goran-mahovlic/modular-psu/3D/BP3C/BP3C_r3B2_Front.png

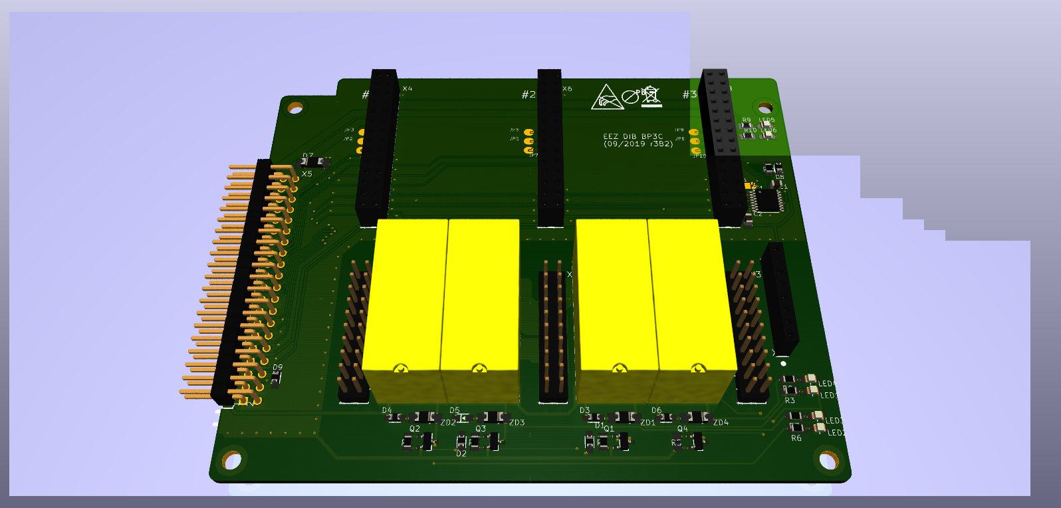
3D/BP3C/BP3C_r3B2_Front.png
