goran-mahovlic/modular-psu/3D/connected.FCStd

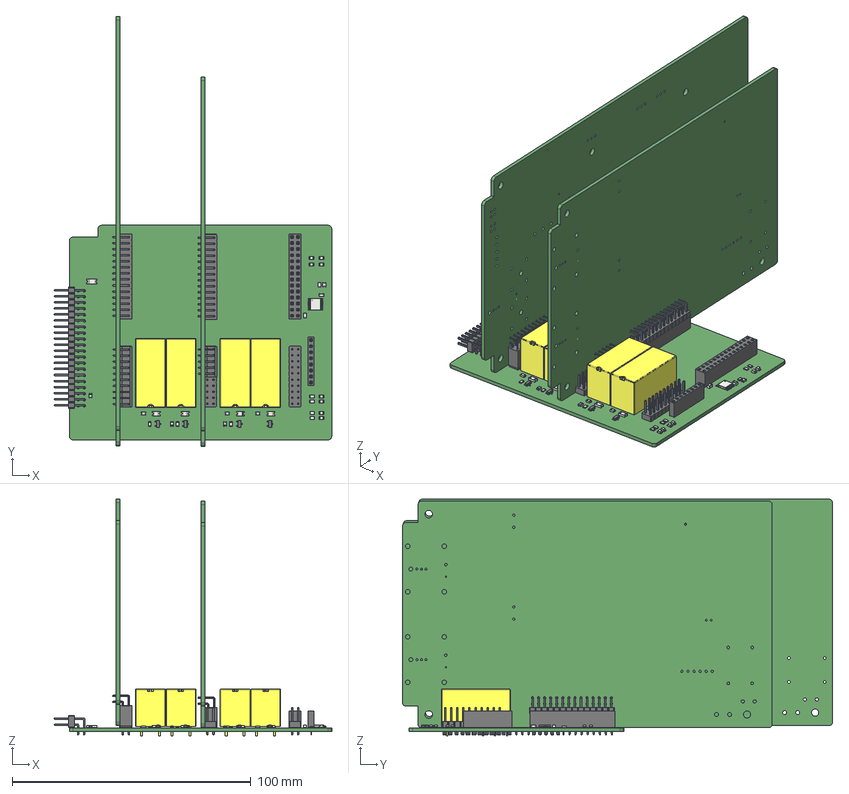
[picture p3: CAD file, 2020-01-07]
3D/connected.FCStd
116.4 x 180.3 x 99.2 mm
