goran-mahovlic/modular-psu/3D/parts/RM84-2P.STEP

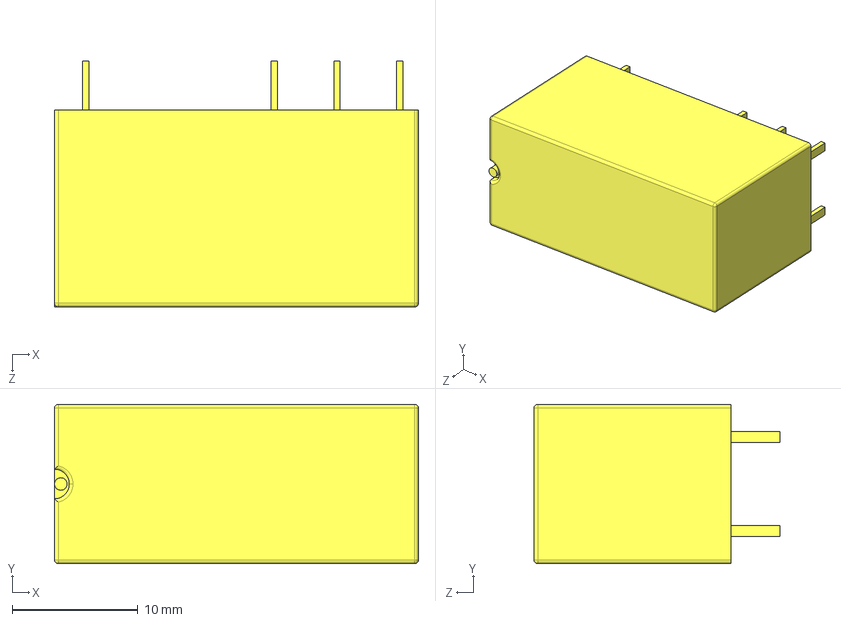
[picture p4: CAD file, 2020-01-07]
3D/parts/RM84-2P.STEP
29.0 x 12.7 x 19.6 mm
