goran-mahovlic/modular-psu/dcm220/Kicad/EEZ DIB DCM220 r2B7.step

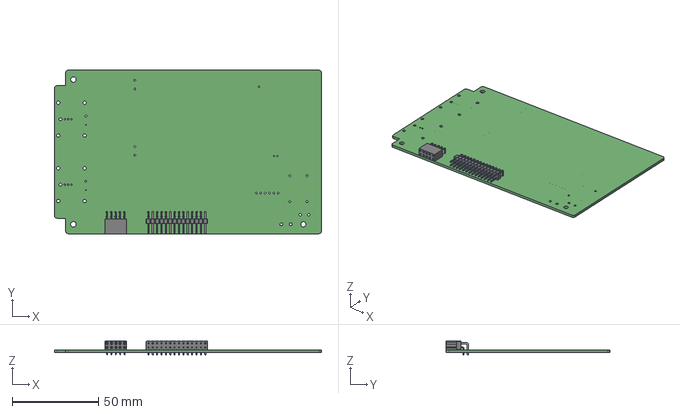
[picture p5: CAD file, 2020-01-07]
dcm220/Kicad/EEZ DIB DCM220 r2B7.step
155.0 x 95.1 x 8.08 mm
