goran-mahovlic/modular-psu/(list of files, cad)

Other CAD files:
3D/parts/RM84-2Z.STEP
