goran-mahovlic/modular-psu/dcp405/Kicad/EEZ DIB DCP405 r2B8.kicad_pcb

## KiCad design dcp405/Kicad/EEZ DIB DCP405 r2B8.kicad_pcb (2020-01-07)

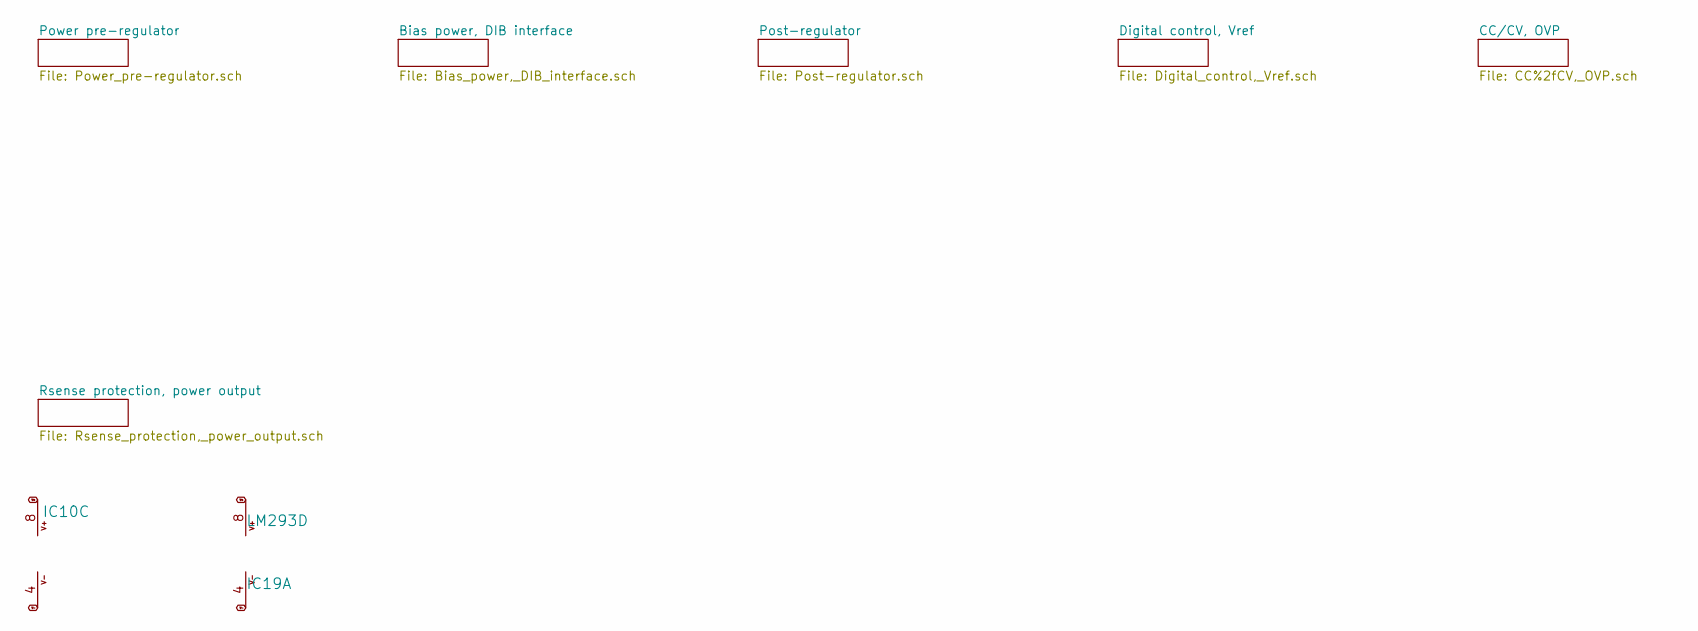
[picture p6: schematic EEZ DIB DCP405 r2B8.sch]

Parts:
IC10: MC33272ADR2G; SOIC127P600X173-8N
IC19: LM293D; SOIC127P600X173-8N

Connections:
V+: IC10.8 (V+), IC19.8 (V+); also elsewhere on the board
V-: IC10.4 (V-), IC19.4 (V-); also elsewhere on the board

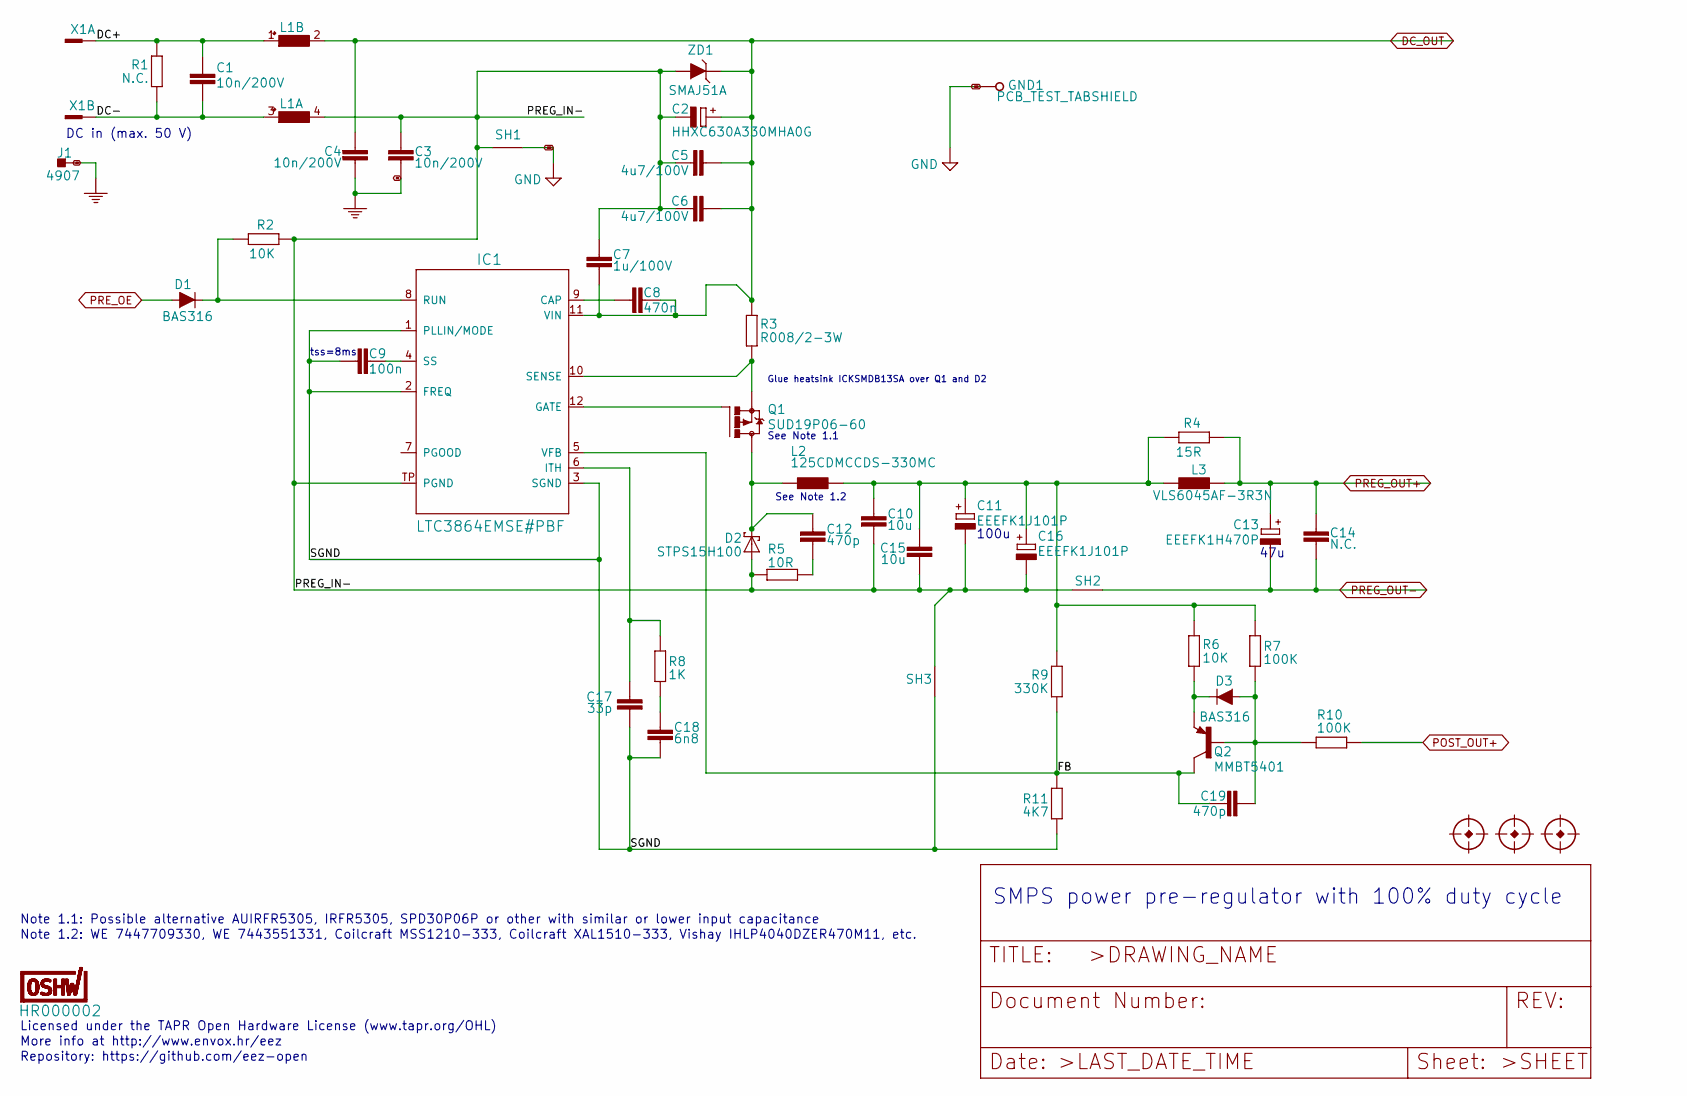
[picture p7: schematic Power_pre-regulator.sch]

Parts:
C1, C3, C4: 10n/200V; C1206
C2: HHXC630A330MHA0G; CAPAE830X1050N
C5, C6: 4u7/100V; C1210
C7: 1u/100V; C1206
C8: 470n; C0805
C9: 100n; C0603
C10, C15: 10u; C1210
C11, C16: EEEFK1J101P; CAPAE1030X1050N
C12, C19: 470p; C0805
C13: EEEFK1H470P; CAPAE830X1050N
C14: N.C.; C0805
C17: 33p; C0805
C18: 6n8; C0805
D1, D3: BAS316; SOD323-R
D2: STPS15H100; TO252-L
FM1, FM2, FM3: FIDUCIAL_2; FIDUCIAL_DUAL
GND: PCB_TEST_TABSHIELD; PCB_SHIELD_TAB
IC1: LTC3864EMSE#PBF; LTC_05-08-1666
J1: 4907; PCB_TAB-4907
L1: RN112-4-02-0M7; RN112
L2: 125CDMCCDS-330MC; 125CDMCC_DS
L3: VLS6045AF-3R3N; COILCRAFT_HPI0630
OSHWA: HR000002; CERT-SMALL-SILK
Q1: SUD19P06-60; TO229P990X239-3N
Q2: MMBT5401; SOT23-BEC
R1: N.C.; R2512
R2, R6: 10K; R0805
R3: R008/2-3W; R2512
R4: 15R; R2010
R5: 10R; R1206
R7, R10: 100K; R0805
R8: 1K; R0805
R9: 330K; R0805
R11: 4K7; R0805
SH1: SHORTNOHOLE; SHORT_NOHOLE
SH2: Pgnd to Pout- short; SHORT_NOHOLE
SH3: Sgnd to Pgnd short; SHORT_NOHOLE
X1: 39-30-1020; MINIFIT_39301020
ZD1: SMAJ51A; DO214AA

Connections:
/Power pre-regulator/DC+: C1.2, L1.1, R1.2, X1.1
/Power pre-regulator/DC-: C1.1, L1.3 (1), R1.1, X1.2
/Power pre-regulator/FB: C19.1, IC1.5 (VFB), Q2.C, R9.2, R11.1
/Power pre-regulator/PREG_IN-: C2.-, C3.1, C5.2, C6.2, C7.2, C10.2, C11.-, C15.2, C16.-, D2.1 (A), D2.2 (A), IC1.TP (PGND), L1.4 (2), R2.1, R5.1, SH1.1 (GND_A), SH2.2 (GND_B), SH3.2 (GND_B), ZD1.A
/Power pre-regulator/SGND: C9.1, C17.2, C18.2, IC1.1 (PLLIN/MODE), IC1.2 (FREQ), IC1.3 (SGND), R11.2, SH3.1 (GND_A)
DC_OUT: C2.+, C4.2, C5.1, C6.1, C7.1, C8.2, IC1.11 (VIN), L1.2, R3.1, ZD1.C; also elsewhere on the board
GND: GND.1, SH1.2 (GND_B); also elsewhere on the board
unnamed: C8.1, IC1.9 (CAP)
unnamed: C9.2, IC1.4 (SS)
unnamed: C10.1, C11.+, C15.1, C16.+, L2.2, L3.1, R4.1, R6.1, R7.1, R9.1
unnamed: C12.1, D2.3 (C), L2.1, Q1.2 (D)
unnamed: C12.2, R5.2
unnamed: C17.1, IC1.6 (ITH), R8.2
unnamed: C18.1, R8.1
unnamed: C19.2, D3.A, Q2.B, R7.2, R10.1
unnamed: D1.C, IC1.8 (RUN), R2.2
unnamed: D3.C, Q2.E, R6.2
unnamed: IC1.10 (SENSE), Q1.3 (S), R3.2
unnamed: IC1.12 (GATE), Q1.1 (G)
PE: C3.2, C4.1, J1.1, J1.2; also elsewhere on the board
POST_OUT+: R10.2; also elsewhere on the board
PREG_OUT+: C13.+, C14.1, L3.2, R4.2; also elsewhere on the board
PREG_OUT-: C13.-, C14.2, SH2.1 (GND_A); also elsewhere on the board
PRE_OE: D1.A; also elsewhere on the board

Notes on the sheet:
47u
tss=8ms
Licensed under the TAPR Open Hardware License (www.tapr.org/OHL)
Repository: https://github.com/eez-open
More info at http://www.envox.hr/eez
SMPS power pre-regulator with 100% duty cycle
100u
See Note 1.1
Note 1.1: Possible alternative AUIRFR5305, IRFR5305, SPD30P06P or other with similar or lower input capacitance
Note 1.2: WE 7447709330, WE 7443551331, Coilcraft MSS1210-333, Coilcraft XAL1510-333, Vishay IHLP4040DZER470M11, etc.
DC in (max. 50 V)
See Note 1.2
Glue heatsink ICKSMDB13SA over Q1 and D2

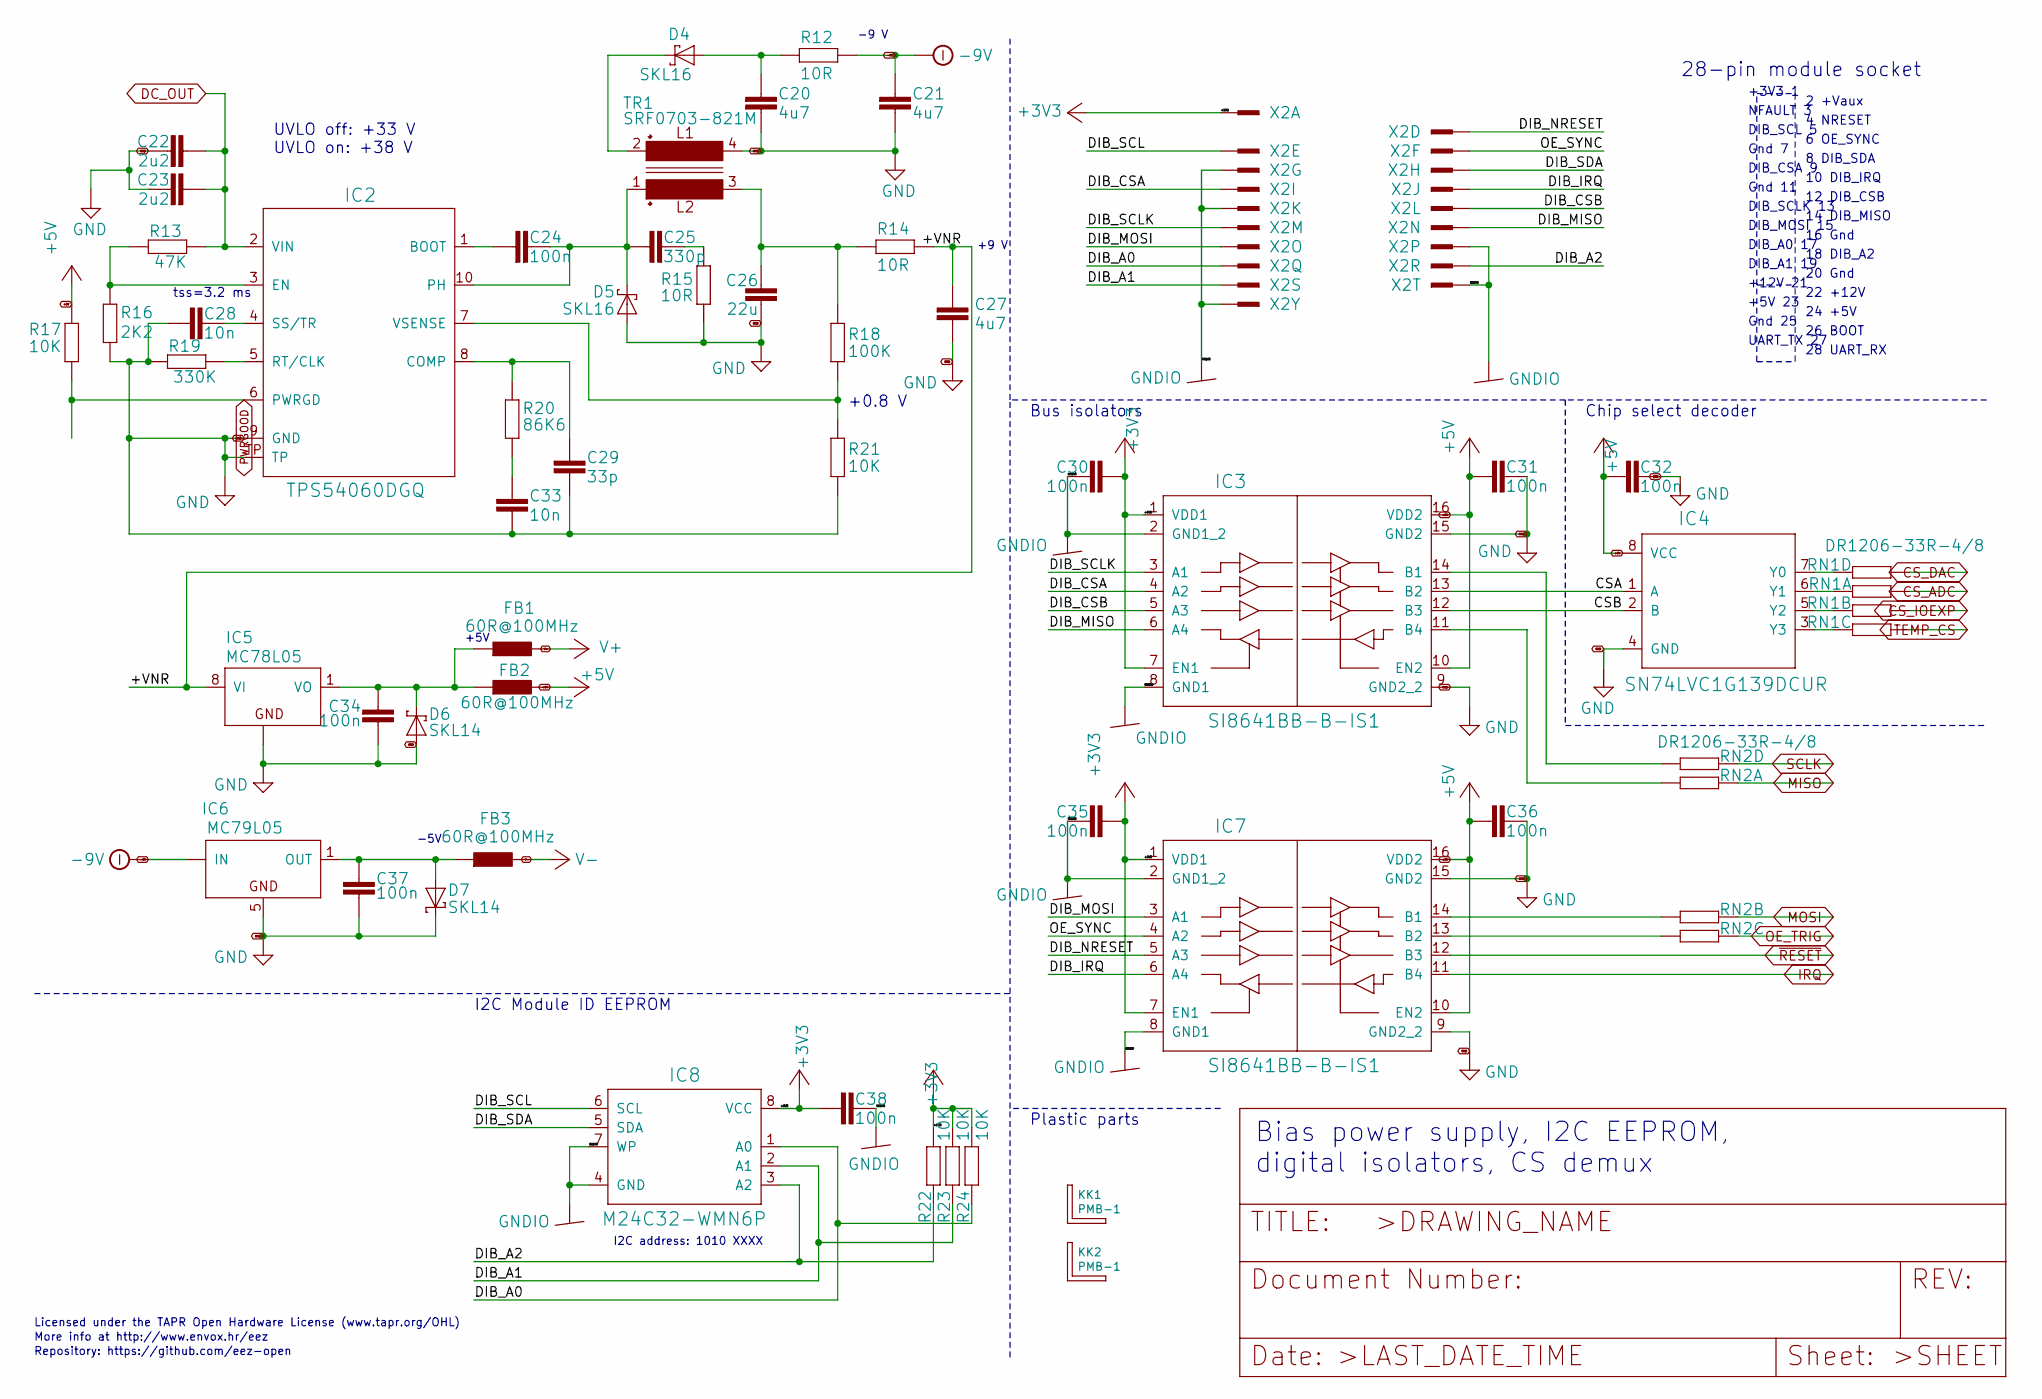
[picture p8: schematic Bias_power,_DIB_interface.sch]

Parts:
C20, C21, C27: 4u7; C1206
C22, C23: 2u2; C1206
C24, C30, C31, C32, C34, C35, C36, C37, C38: 100n; C0603
C25: 330p; C0805
C26: 22u; C1210
C28, C33: 10n; C0805
C29: 33p; C0805
D4, D5: SKL16; SOD123
D6, D7: SKL14; SOD123
FB1, FB2, FB3: 60R@100MHz; BEAD0603
IC2: TPS54060DGQ; SOP50P490X110-11N
IC3, IC7: SI8641BB-B-IS1; SOIC-16
IC4: SN74LVC1G139DCUR; DCU8
IC5: MC78L05; SOIC127P600X173-8N
IC6: MC79L05; SOIC127P600X173-8N
IC8: M24C32-WMN6P; SOIC127P600X173-8N
KK1, KK2: PMB-1; PCB-MB
R12, R14, R15: 10R; R1206
R13: 47K; R0805
R16: 2K2; R0805
R17, R21, R22, R23, R24: 10K; R0805
R18: 100K; R0805
R19: 330K; R0805
R20: 86K6; R0805
RN1, RN2: DR1206-33R-4/8; CAY16
TR1: SRF0703-821M; SRF0703
X2: 77317-104-20LF; 77317-104-28LF

Connections:
+3V3: C30.1, C35.1, C38.2, IC3.1 (VDD1), IC3.7 (EN1), IC7.1 (VDD1), IC7.7 (EN1), IC8.8 (VCC), R22.1, R23.1, R24.1, X2.1
+5V: C31.2, C32.1, C36.2, FB2.P$2 (2), IC3.10 (EN2), IC3.16 (VDD2), IC4.8 (VCC), IC7.10 (EN2), IC7.16 (VDD2), R17.1; also elsewhere on the board
-9V: C21.1, IC6.2 (IN), IC6.3 (IN), IC6.6 (IN), IC6.7 (IN), R12.1; also elsewhere on the board
/Bias power, DIB interface/+VNR: C27.1, IC5.8 (VI), R14.1
/Bias power, DIB interface/CSA: IC3.13 (B2), IC4.1 (A)
/Bias power, DIB interface/CSB: IC3.12 (B3), IC4.2 (B)
/Bias power, DIB interface/DIB_A0: IC8.1 (A0), R24.2, X2.17
/Bias power, DIB interface/DIB_A1: IC8.2 (A1), R23.2, X2.19
/Bias power, DIB interface/DIB_A2: IC8.3 (A2), R22.2, X2.18
/Bias power, DIB interface/DIB_CSA: IC3.4 (A2), X2.9
/Bias power, DIB interface/DIB_CSB: IC3.5 (A3), X2.12
/Bias power, DIB interface/DIB_IRQ: IC7.6 (A4), X2.10
/Bias power, DIB interface/DIB_MISO: IC3.6 (A4), X2.14
/Bias power, DIB interface/DIB_MOSI: IC7.3 (A1), X2.15
/Bias power, DIB interface/DIB_NRESET: IC7.5 (A3), X2.4
/Bias power, DIB interface/DIB_SCL: IC8.6 (SCL), X2.5
/Bias power, DIB interface/DIB_SCLK: IC3.3 (A1), X2.13
/Bias power, DIB interface/DIB_SDA: IC8.5 (SDA), X2.8
/Bias power, DIB interface/OE_SYNC: IC7.4 (A2), X2.6
CS_ADC: RN1.7 (2); also elsewhere on the board
CS_DAC: RN1.8 (2); also elsewhere on the board
CS_IOEXP: RN1.6 (2); also elsewhere on the board
DC_OUT: C22.1, C23.1, IC2.2 (VIN), R13.2; also elsewhere on the board
GND: C20.2, C21.2, C22.2, C23.2, C26.2, C27.2, C28.2, C29.1, C31.1, C32.2, C33.1, C34.2, C36.1, C37.1, D5.A, D6.A, D7.C, IC2.9 (GND), IC2.TP, IC3.9 (GND2_2), IC3.15 (GND2), IC4.4 (GND), IC5.2 (GND), IC5.3 (GND), IC5.6 (GND), IC5.7 (GND), IC6.5 (GND), IC7.9 (GND2_2), IC7.15 (GND2), R15.1, R16.1, R19.1, R21.1, TR1.4; also elsewhere on the board
GNDIO: C30.2, C35.2, C38.1, IC3.2 (GND1_2), IC3.8 (GND1), IC7.2 (GND1_2), IC7.8 (GND1), IC8.4 (GND), IC8.7 (WP), X2.7, X2.11, X2.16, X2.20, X2.25
IRQ: IC7.11 (B4); also elsewhere on the board
MISO: RN2.7 (2); also elsewhere on the board
MOSI: RN2.6 (2); also elsewhere on the board
unnamed: C20.1, D4.A, R12.2
unnamed: C24.1, C25.1, D5.C, IC2.10 (PH), TR1.1
unnamed: C24.2, IC2.1 (BOOT)
unnamed: C25.2, R15.2
unnamed: C26.1, R14.2, R18.2, TR1.3
unnamed: C28.1, IC2.4 (SS/TR)
unnamed: C29.2, IC2.8 (COMP), R20.2
unnamed: C33.2, R20.1
unnamed: C34.1, D6.C, FB1.P$1 (1), FB2.P$1 (1), IC5.1 (VO)
unnamed: C37.2, D7.A, FB3.P$1 (1), IC6.1 (OUT)
unnamed: D4.C, TR1.2
unnamed: IC2.3 (EN), R13.1, R16.2
unnamed: IC2.5 (RT/CLK), R19.2
unnamed: IC2.7 (VSENSE), R18.1, R21.2
unnamed: IC3.11 (B4), RN2.2 (1)
unnamed: IC3.14 (B1), RN2.1
unnamed: IC4.3 (Y3), RN1.4 (1)
unnamed: IC4.5 (Y2), RN1.3 (1)
unnamed: IC4.6 (Y1), RN1.2 (1)
unnamed: IC4.7 (Y0), RN1.1
unnamed: IC7.13 (B2), RN2.4 (1)
unnamed: IC7.14 (B1), RN2.3 (1)
OE_TRIG: RN2.5 (2); also elsewhere on the board
PWRGOOD: IC2.6 (PWRGD), R17.2; also elsewhere on the board
SCLK: RN2.8 (2); also elsewhere on the board
TEMP_CS: RN1.5 (2); also elsewhere on the board
V+: FB1.P$2 (2); also elsewhere on the board
V-: FB3.P$2 (2); also elsewhere on the board
~RESET: IC7.12 (B3); also elsewhere on the board

Notes on the sheet:
Licensed under the TAPR Open Hardware License (www.tapr.org/OHL)
Repository: https://github.com/eez-open
More info at http://www.envox.hr/eez
I2C Module ID EEPROM
Bus isolators
Bias power supply, I2C EEPROM, digital isolators, CS demux
Plastic parts
Chip select decoder
Gnd 7
22 +12V
16 Gnd
6 OE_SYNC
24 +5V
+5V 23
Gnd 25
28-pin module socket
+12V 21
10 DIB_IRQ
DIB_CSA 9
2 +Vaux
12 DIB_CSB
+3V3 1
Gnd 11
8 DIB_SDA
DIB_SCL 5
DIB_A1 19
4 NRESET
DIB_A0 17
20 Gnd
NFAULT 3
14 DIB_MISO
DIB_MOSI 15
DIB_SCLK 13
18 DIB_A2
-5V
+5V
I2C address: 1010 XXXX
+9 V
UVLO off: +33 V UVLO on: +38 V
+0.8 V
-9 V
26 BOOT
UART_TX 27
28 UART_RX
tss=3.2 ms

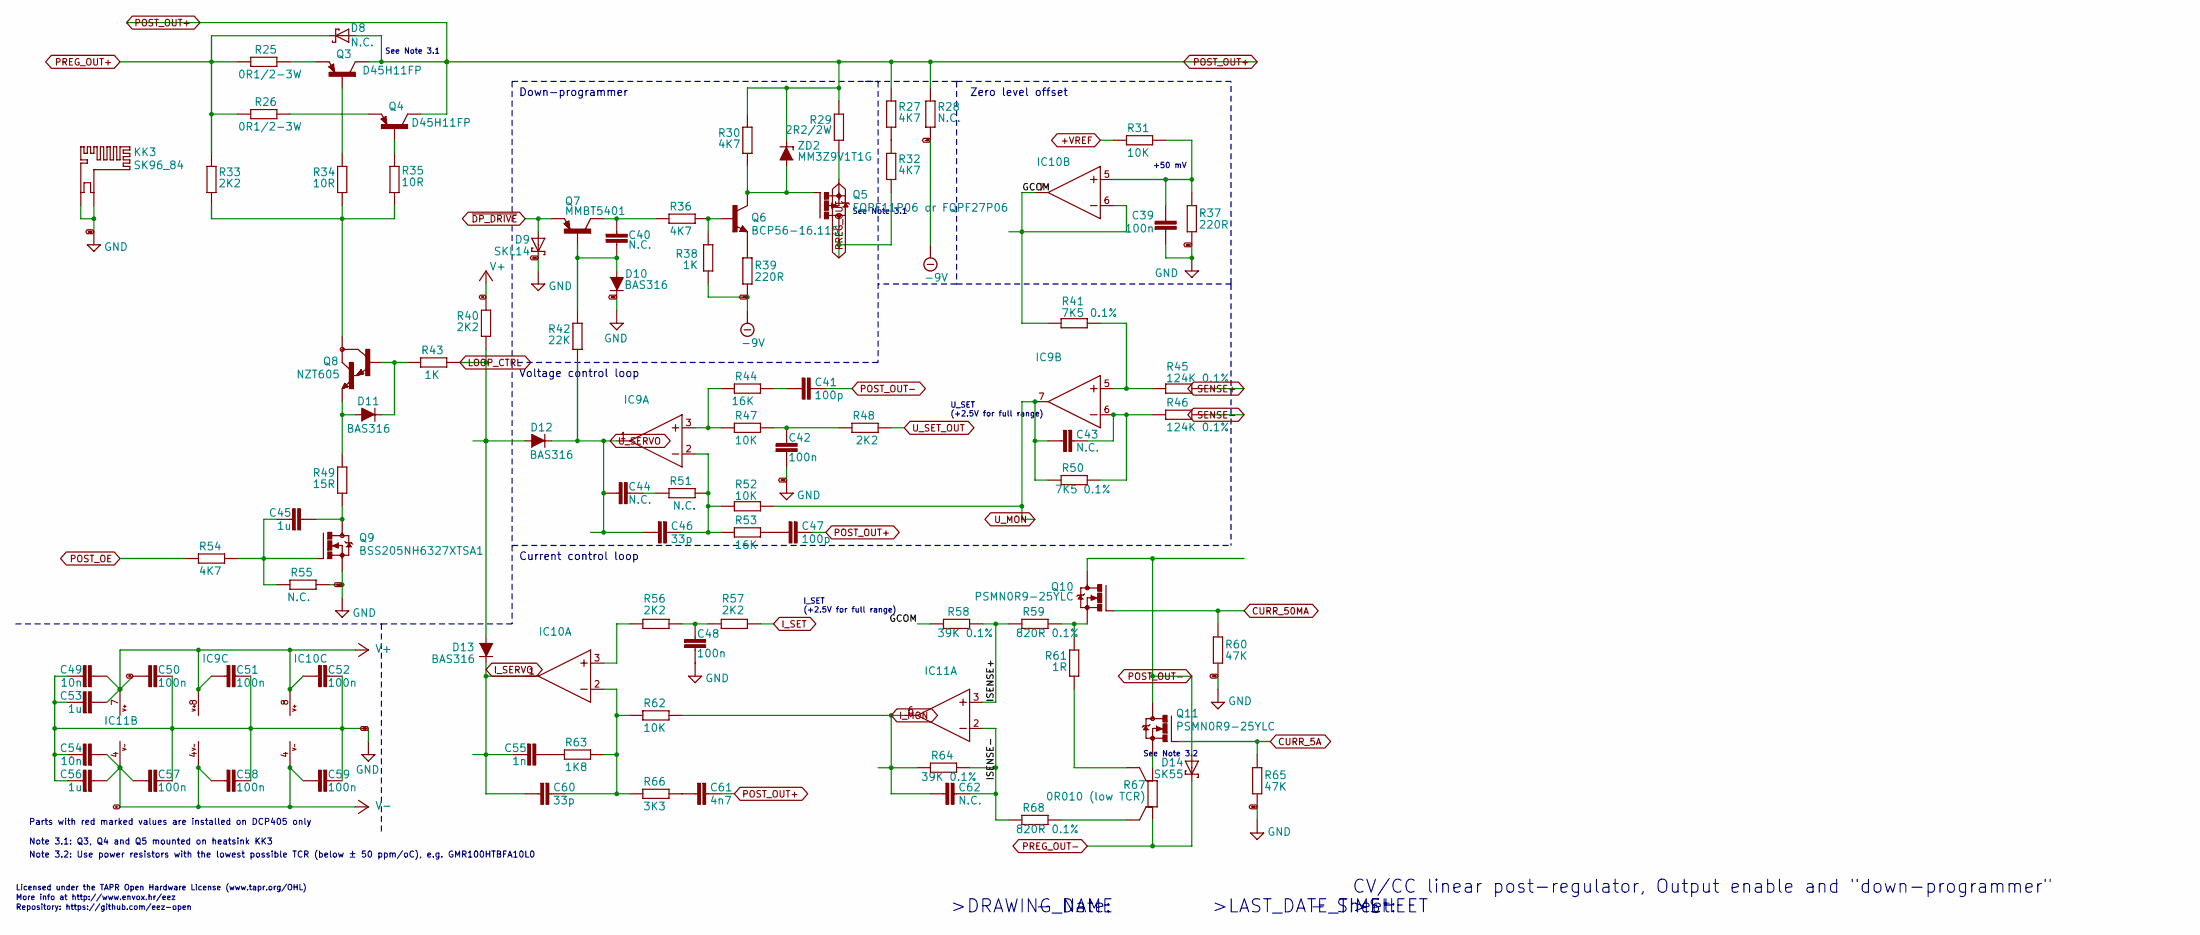
[picture p9: schematic Post-regulator.sch]

Parts:
C39, C42, C48, C50, C51, C52, C57, C58, C59: 100n; C0603
C40, C43, C44, C62: N.C.; C0805
C41, C47: 100p; C0805
C45, C53, C56: 1u; C0805
C46, C60: 33p; C0805
C49, C54: 10n; C0805
C55: 1n; C0805
C61: 4n7; C0805
D8: N.C.; SOD123
D9: SKL14; SOD123
D10, D11, D12, D13: BAS316; SOD323-R
D14: SK55; SMB
IC9: TL072D; SOIC127P600X173-8N
IC10: MC33272ADR2G; SOIC127P600X173-8N
IC11: LTC2050HVCS8#PBF; SOIC127P600X173-8N
KK3: SK96_84
Q3, Q4: D45H11FP; TO220FP-V
Q5: FQPF11P06 or FQPF27P06; TO220FP-V
Q6: BCP56-16.115; SOT230P700X180-4N
Q7: MMBT5401; SOT23-BEC
Q8: NZT605; SOT230P700X180-4N
Q9: BSS205NH6327XTSA1; SOT103P240X110-3N
Q10, Q11: PSMN0R9-25YLC; SOT669
R25, R26: 0R1/2-3W; R2512
R27, R30, R32, R36, R54: 4K7; R0805
R28, R51, R55: N.C.; R0805
R29: 2R2/2W; R2512
R31, R47, R52, R62: 10K; R0805
R33, R40, R48, R56, R57: 2K2; R0805
R34, R35: 10R; R1206
R37, R39: 220R; R0805
R38, R43: 1K; R0805
R41, R50: 7K5 0.1%; R0805
R42: 22K; R0805
R44, R53: 16K; R0805
R45, R46: 124K 0.1%; R0805
R49: 15R; R2010
R58, R64: 39K 0.1%; R0805
R59, R68: 820R 0.1%; R0805
R60, R65: 47K; R0805
R61: 1R; R1206
R63: 1K8; R0805
R66: 3K3; R0805
R67: 0R010 (low TCR); R_2512-4WIRE
ZD2: MM3Z9V1T1G; SOD323-R

Connections:
+VREF: R31.1; also elsewhere on the board
-9V: R28.1, R38.2, R39.2; also elsewhere on the board
/Post-regulator/GCOM: IC10.6 (-IN), IC10.7 (OUT), R41.1, R58.1
/Post-regulator/ISENSE+: IC11.3 (+IN), R58.2, R59.2
/Post-regulator/ISENSE-: C62.1, IC11.2 (-IN), R64.1, R68.2
CURR_5A: Q11.4 (G), R65.2; also elsewhere on the board
CURR_50MA: Q10.4 (G), R60.2; also elsewhere on the board
GND: C39.2, C42.2, C48.2, C49.1, C50.2, C51.1, C52.1, C53.1, C54.1, C56.1, C57.2, C58.1, C59.1, D9.C, D10.C, KK3.1, KK3.2, Q9.2 (S), R37.2, R55.1, R60.1, R65.1; also elsewhere on the board
I_MON: C62.2, IC11.6 (OUT), R62.1, R64.2; also elsewhere on the board
I_SERVO: C55.2, C60.2, D13.C, IC10.1 (OUT); also elsewhere on the board
I_SET: R57.1; also elsewhere on the board
LOOP_CTRL: D12.A, D13.A, R40.1, R43.1; also elsewhere on the board
unnamed: C39.1, IC10.5 (+IN), R31.2, R37.1
unnamed: C40.1, D10.A, Q7.B, R42.2
unnamed: C40.2, Q7.C, R36.2
unnamed: C41.2, R44.1
unnamed: C42.1, R47.1, R48.2
unnamed: C43.1, IC9.6 (-IN), R46.1, R50.2
unnamed: C44.1, R51.2
unnamed: C45.1, Q9.1 (G), R54.1, R55.2
unnamed: C45.2, Q9.3 (D), R49.1
unnamed: C46.1, IC9.2 (-IN), R51.1, R52.2, R53.2
unnamed: C47.2, R53.1
unnamed: C48.1, R56.1, R57.2
unnamed: C55.1, R63.1
unnamed: C60.1, IC10.2 (-IN), R62.2, R63.2, R66.2
unnamed: C61.2, R66.1
unnamed: D11.A, Q8.3 (E), R49.2
unnamed: D11.C, Q8.1 (B), R43.2
unnamed: IC9.3 (+IN), R44.2, R47.2
unnamed: IC9.5 (+IN), R41.2, R45.1
unnamed: IC10.3 (+IN), R56.2
unnamed: Q3.1 (B), R34.2
unnamed: Q3.3 (E), R25.2
unnamed: Q4.1 (B), R35.2
unnamed: Q4.3 (E), R26.2
unnamed: Q5.1 (G), Q6.2 (C), Q6.4 (C), R30.2, ZD2.A
unnamed: Q5.3 (S), R29.1
unnamed: Q6.1 (B), R36.1, R38.1
unnamed: Q6.3 (E), R39.1
unnamed: Q8.2 (C), Q8.4 (C), R33.1, R34.1, R35.1
unnamed: Q10.1 (S), Q10.2 (S), Q10.3 (S), R59.1, R61.1
unnamed: Q11.1 (S), Q11.2 (S), Q11.3 (S), R67.2
unnamed: R27.1, R32.2
unnamed: R61.2, R67.2S
unnamed: R67.1S, R68.1
POST_OE: R54.2; also elsewhere on the board
POST_OUT+: C47.1, C61.1, D8.A, Q3.2 (C), Q4.2 (C), R27.2, R28.2, R29.2, R30.1, ZD2.C; also elsewhere on the board
POST_OUT-: C41.1, D14.A, Q10.MB (D), Q11.MB (D); also elsewhere on the board
PREG_OUT+: D8.C, R25.1, R26.1, R33.2; also elsewhere on the board
PREG_OUT-: D14.C, Q5.2 (D), R32.1, R67.1; also elsewhere on the board
SENSE+: R45.2; also elsewhere on the board
SENSE-: R46.2; also elsewhere on the board
U_MON: C43.2, IC9.7 (OUT), R50.1, R52.1; also elsewhere on the board
U_SERVO: C44.2, C46.2, D12.C, IC9.1 (OUT), R42.1; also elsewhere on the board
U_SET_OUT: R48.1; also elsewhere on the board
V+: C49.2, C50.1, C51.2, C52.2, C53.2, IC9.8 (V+), IC10.8 (V+), IC11.7 (V+), R40.2; also elsewhere on the board
V-: C54.2, C56.2, C57.1, C58.2, C59.2, IC9.4 (V-), IC10.4 (V-), IC11.4 (V-); also elsewhere on the board
~DP_DRIVE: D9.A, Q7.E; also elsewhere on the board

Notes on the sheet:
Voltage control loop
U_SET (+2.5V for full range)
Note 3.1: Q3, Q4 and Q5 mounted on heatsink KK3
Down-programmer
Licensed under the TAPR Open Hardware License (www.tapr.org/OHL)
Repository: https://github.com/eez-open
More info at http://www.envox.hr/eez
+50 mV
See Note 3.1
I_SET (+2.5V for full range)
Zero level offset
Note 3.2: Use power resistors with the lowest possible TCR (below ± 50 ppm/oC), e.g. GMR100HTBFA10L0
CV/CC linear post-regulator, Output enable and "down-programmer"
See Note 3.2
>SHEET
- Sheet:
>DRAWING_NAME
>LAST_DATE_TIME
- Date:
Current control loop
Parts with red marked values are installed on DCP405 only

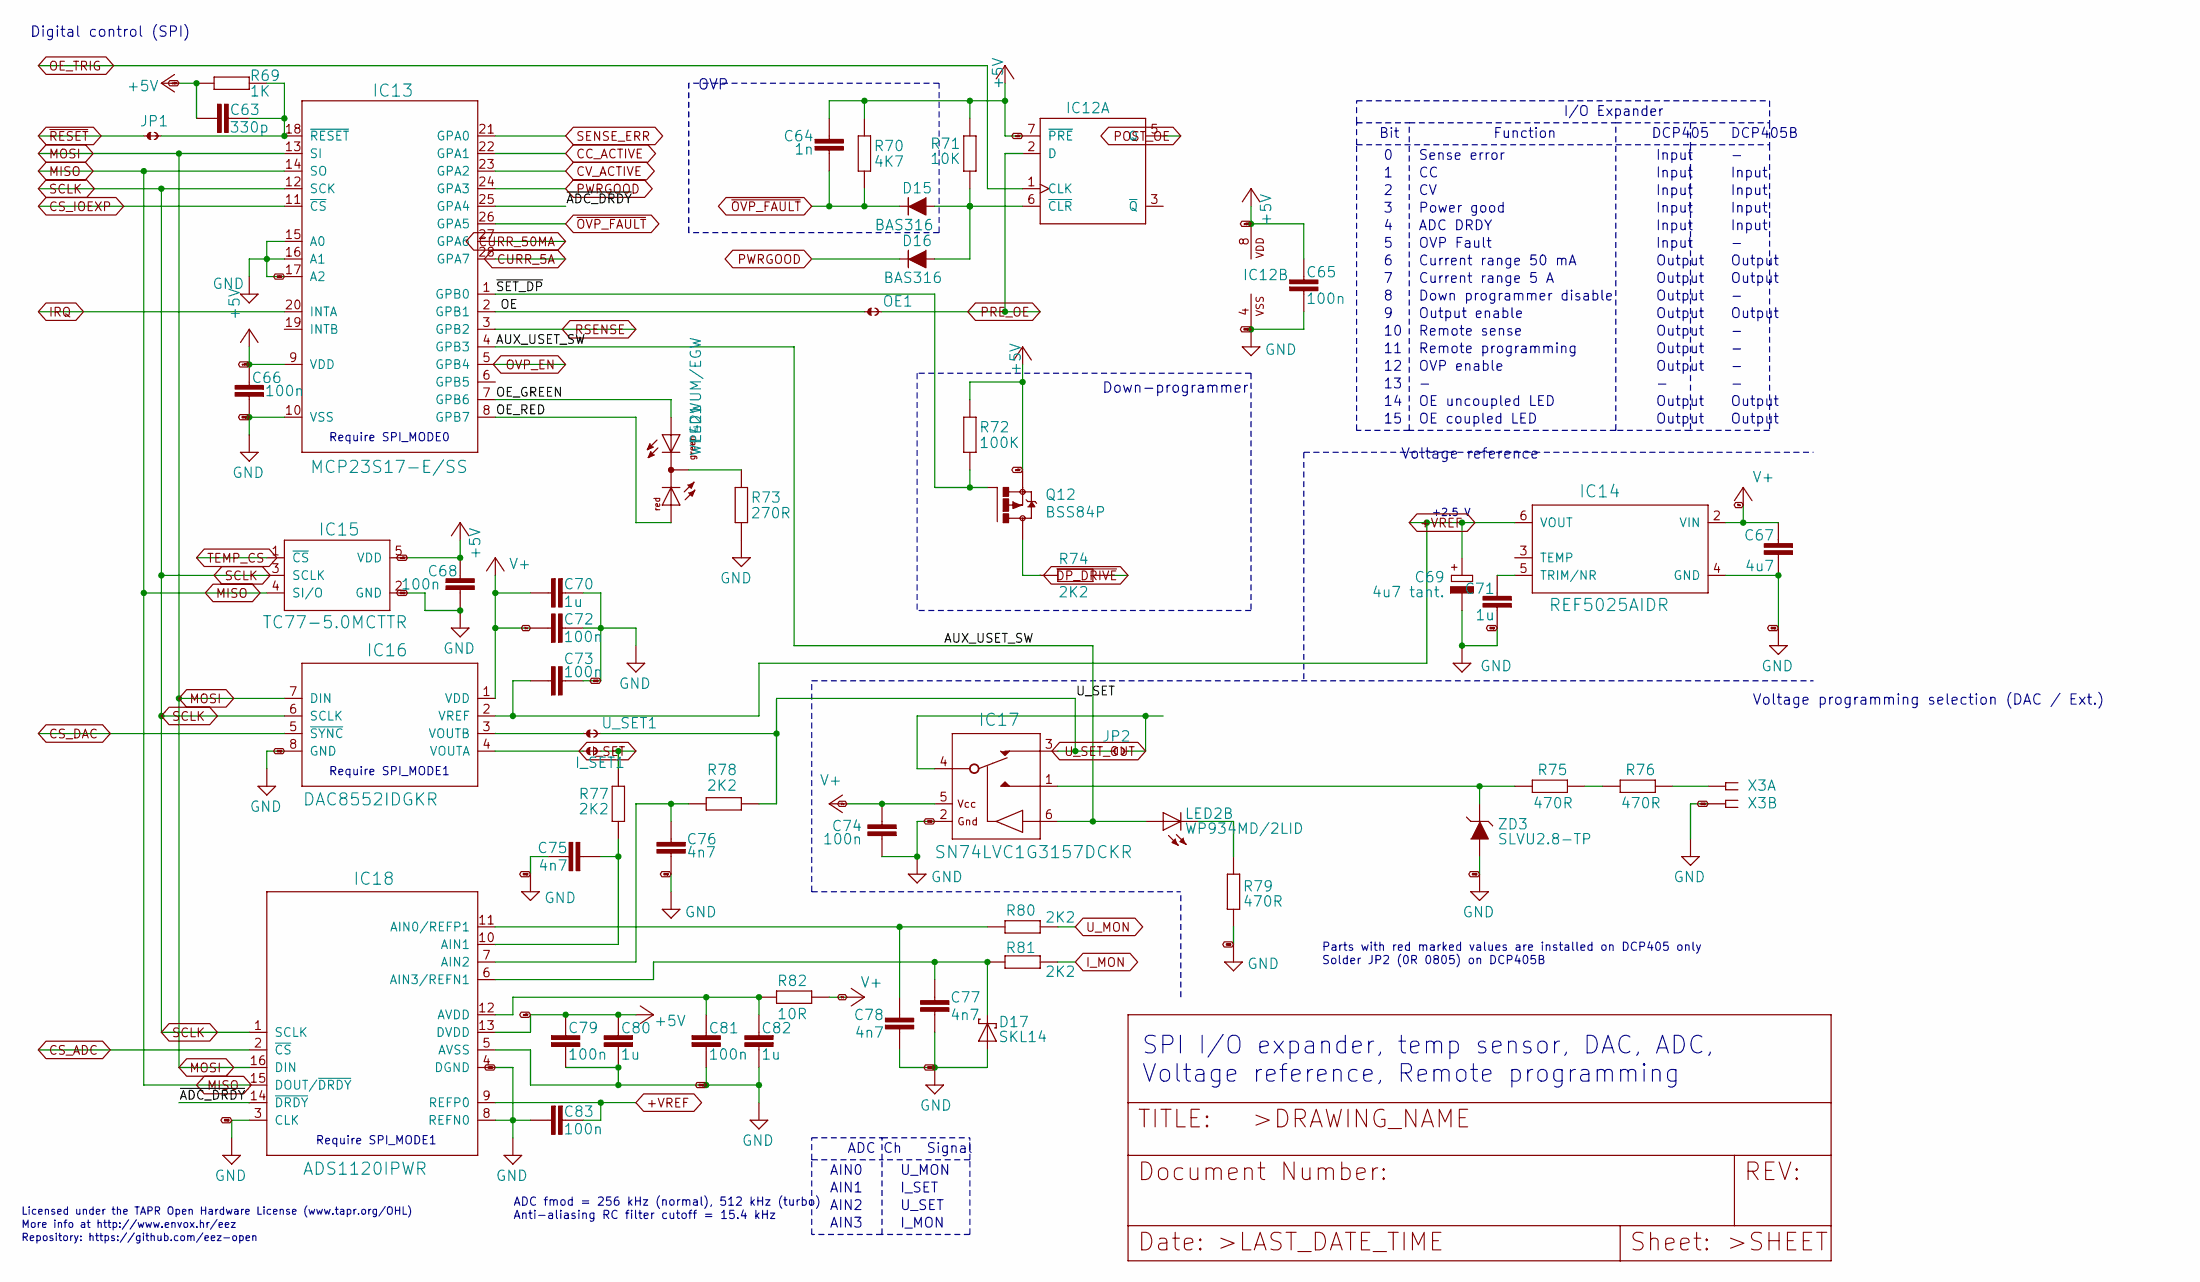
[picture p10: schematic Digital_control,_Vref.sch]

Parts:
C63: 330p; C0805
C64: 1n; C0805
C65, C66, C68, C72, C73, C74, C79, C81, C83: 100n; C0603
C67: 4u7; C1206
C69: 4u7 tant.; EC1206
C70, C71, C80, C82: 1u; C0805
C75, C76, C77, C78: 4n7; C0805
D15, D16: BAS316; SOD323-R
D17: SKL14; SOD123
IC12: 74AUP1G74DC.125; DCU8
IC13: MCP23S17-E/SS; SOP65P780X200-28N
IC14: REF5025AIDR; SOIC127P600X175-8N
IC15: TC77-5.0MCTTR; SOT23-5
IC16: DAC8552IDGKR; DGK8-M
IC17: SN74LVC1G3157DCKR; SOT65P210X110-6N
IC18: ADS1120IPWR; PW(R-PDSO-G16)
I_SET: JP2-NOCUT
JP1: JP2-NOCUT
JP2: JP2-CUT-0805; R_0805
LED1: WP42WUM/EGW; L-42WUM-1EGWT
LED2: WP934MD/2LID; WP934MD
OE: JP2-NOCUT
Q12: BSS84P; SOT95P237X112-3N
R69: 1K; R0805
R70: 4K7; R0805
R71: 10K; R0805
R72: 100K; R0805
R73: 270R; R0805
R74, R77, R78, R80, R81: 2K2; R0805
R75, R76, R79: 470R; R0805
R82: 10R; R1206
U_SET: JP2-NOCUT
X3: 691322110005; MC1,5_5-G-3,5
ZD3: SLVU2.8-TP; SOT23

Connections:
+5V: C63.2, C64.2, C65.2, C66.1, C68.1, C79.2, C80.2, IC12.7 (~PRE), IC12.8 (VDD), IC13.9 (VDD), IC15.5 (VDD), IC18.13 (DVDD), Q12.2 (S), R69.1, R70.1, R71.1, R72.1; also elsewhere on the board
+VREF: C69.+, C73.2, C83.2, IC14.6 (VOUT), IC16.2 (VREF), IC18.9 (REFP0); also elsewhere on the board
/Digital control, Vref/AUX_USET_SW: IC13.4 (GPB3), IC17.6 (CTRL), LED2.BA (A)
/Digital control, Vref/OE: IC13.2 (GPB1), OE.1
/Digital control, Vref/OE_GREEN: IC13.7 (GPB6), LED1.GREEN (AG)
/Digital control, Vref/OE_RED: IC13.8 (GPB7), LED1.RED (AR)
/Digital control, Vref/U_SET: IC17.3 (NC), JP2.1, R78.1, U_SET.2
/Digital control, Vref/~ADC_DRDY: IC13.25 (GPA4), IC18.14 (~DRDY)
/Digital control, Vref/~SET_DP: IC13.1 (GPB0), Q12.1 (G), R72.2
CC_ACTIVE: IC13.22 (GPA1); also elsewhere on the board
CS_ADC: IC18.2 (~CS); also elsewhere on the board
CS_DAC: IC16.5 (~SYNC); also elsewhere on the board
CS_IOEXP: IC13.11 (~CS); also elsewhere on the board
CURR_5A: IC13.28 (GPA7); also elsewhere on the board
CURR_50MA: IC13.27 (GPA6); also elsewhere on the board
CV_ACTIVE: IC13.23 (GPA2); also elsewhere on the board
GND: C65.1, C66.2, C67.2, C68.2, C69.-, C70.2, C71.2, C72.1, C73.1, C74.2, C75.1, C76.1, C77.2, C78.1, C79.1, C80.1, C81.1, C82.1, C83.1, D17.A, IC12.4 (VSS), IC13.10 (VSS), IC13.15 (A0), IC13.16 (A1), IC13.17 (A2), IC14.4 (GND), IC15.2 (GND), IC16.8 (GND), IC17.2 (GND), IC18.3 (CLK), IC18.4 (DGND), IC18.5 (AVSS), IC18.8 (REFN0), R73.2, R79.1, X3.2, ZD3.1 (A), ZD3.2 (A); also elsewhere on the board
IRQ: IC13.20 (INTA); also elsewhere on the board
I_MON: R81.1; also elsewhere on the board
I_SET: I_SET.2, R77.1; also elsewhere on the board
MISO: IC13.14 (SO), IC15.4 (SI/O), IC18.15 (DOUT/~DRDY); also elsewhere on the board
MOSI: IC13.13 (SI), IC16.7 (DIN), IC18.16 (DIN); also elsewhere on the board
unnamed: C63.1, IC13.18 (~RESET), JP1.2, R69.2
unnamed: C71.1, IC14.5 (TRIM/NR)
unnamed: C75.2, IC18.10 (AIN1), R77.2
unnamed: C76.2, IC18.7 (AIN2), R78.2
unnamed: C77.1, D17.C, IC18.6 (AIN3/REFN1), R81.2
unnamed: C78.2, IC18.11 (AIN0/REFP1), R80.2
unnamed: C81.2, C82.2, IC18.12 (AVDD), R82.2
unnamed: D15.A, D16.A, IC12.6 (~CLR), R71.2
unnamed: IC16.3 (VOUTB), U_SET.1
unnamed: IC16.4 (VOUTA), I_SET.1
unnamed: IC17.1 (NO), R75.1, ZD3.3 (C)
unnamed: LED1.CC (C), R73.1
unnamed: LED2.BC (C), R79.2
unnamed: Q12.3 (D), R74.2
unnamed: R75.2, R76.1
unnamed: R76.2, X3.1
OE_TRIG: IC12.1 (CLK); also elsewhere on the board
OVP_EN: IC13.5 (GPB4); also elsewhere on the board
POST_OE: IC12.5 (Q); also elsewhere on the board
PRE_OE: IC12.2 (D), OE.2; also elsewhere on the board
PWRGOOD: D16.C, IC13.24 (GPA3); also elsewhere on the board
RSENSE: IC13.3 (GPB2); also elsewhere on the board
SCLK: IC13.12 (SCK), IC15.3 (SCLK), IC16.6 (SCLK), IC18.1 (SCLK); also elsewhere on the board
SENSE_ERR: IC13.21 (GPA0); also elsewhere on the board
TEMP_CS: IC15.1 (~CS); also elsewhere on the board
U_MON: R80.1; also elsewhere on the board
U_SET_OUT: IC17.4 (COM), JP2.2; also elsewhere on the board
V+: C67.1, C70.1, C72.2, C74.1, IC14.2 (VIN), IC16.1 (VDD), IC17.5 (VDD), R82.1; also elsewhere on the board
~DP_DRIVE: R74.1; also elsewhere on the board
~OVP_FAULT: C64.1, D15.C, IC13.26 (GPA5), R70.2; also elsewhere on the board
~RESET: JP1.1; also elsewhere on the board

Notes on the sheet:
Require SPI_MODE1
Digital control (SPI)
Voltage reference
Licensed under the TAPR Open Hardware License (www.tapr.org/OHL)
Repository: https://github.com/eez-open
More info at http://www.envox.hr/eez
Function
DCP405
Sense error
Input
Bit
Down programmer disable
Remote sense
Remote programming
Power good
Output enable
Output
I/O Expander
SPI I/O expander, temp sensor, DAC, ADC, Voltage reference, Remote programming
Require SPI_MODE0
Current range 5 A
Current range 50 mA
+2.5 V
OE coupled LED
AIN0
AIN1
Signal
U_MON
I_SET
ADC Ch
U_SET
AIN2
AIN3
I_MON
Voltage programming selection (DAC / Ext.)
OE uncoupled LED
OVP enable
ADC DRDY
OVP Fault
ADC fmod = 256 kHz (normal), 512 kHz (turbo) Anti-aliasing RC filter cutoff = 15.4 kHz
DCP405B
Parts with red marked values are installed on DCP405 only Solder JP2 (0R 0805) on DCP405B
OVP
Down-programmer
