goran-mahovlic/modular-psu/dcp405/Kicad/EEZ DIB DCP405 r2B8.kicad_pcb

## KiCad design dcp405/Kicad/EEZ DIB DCP405 r2B8.kicad_pcb (continued)

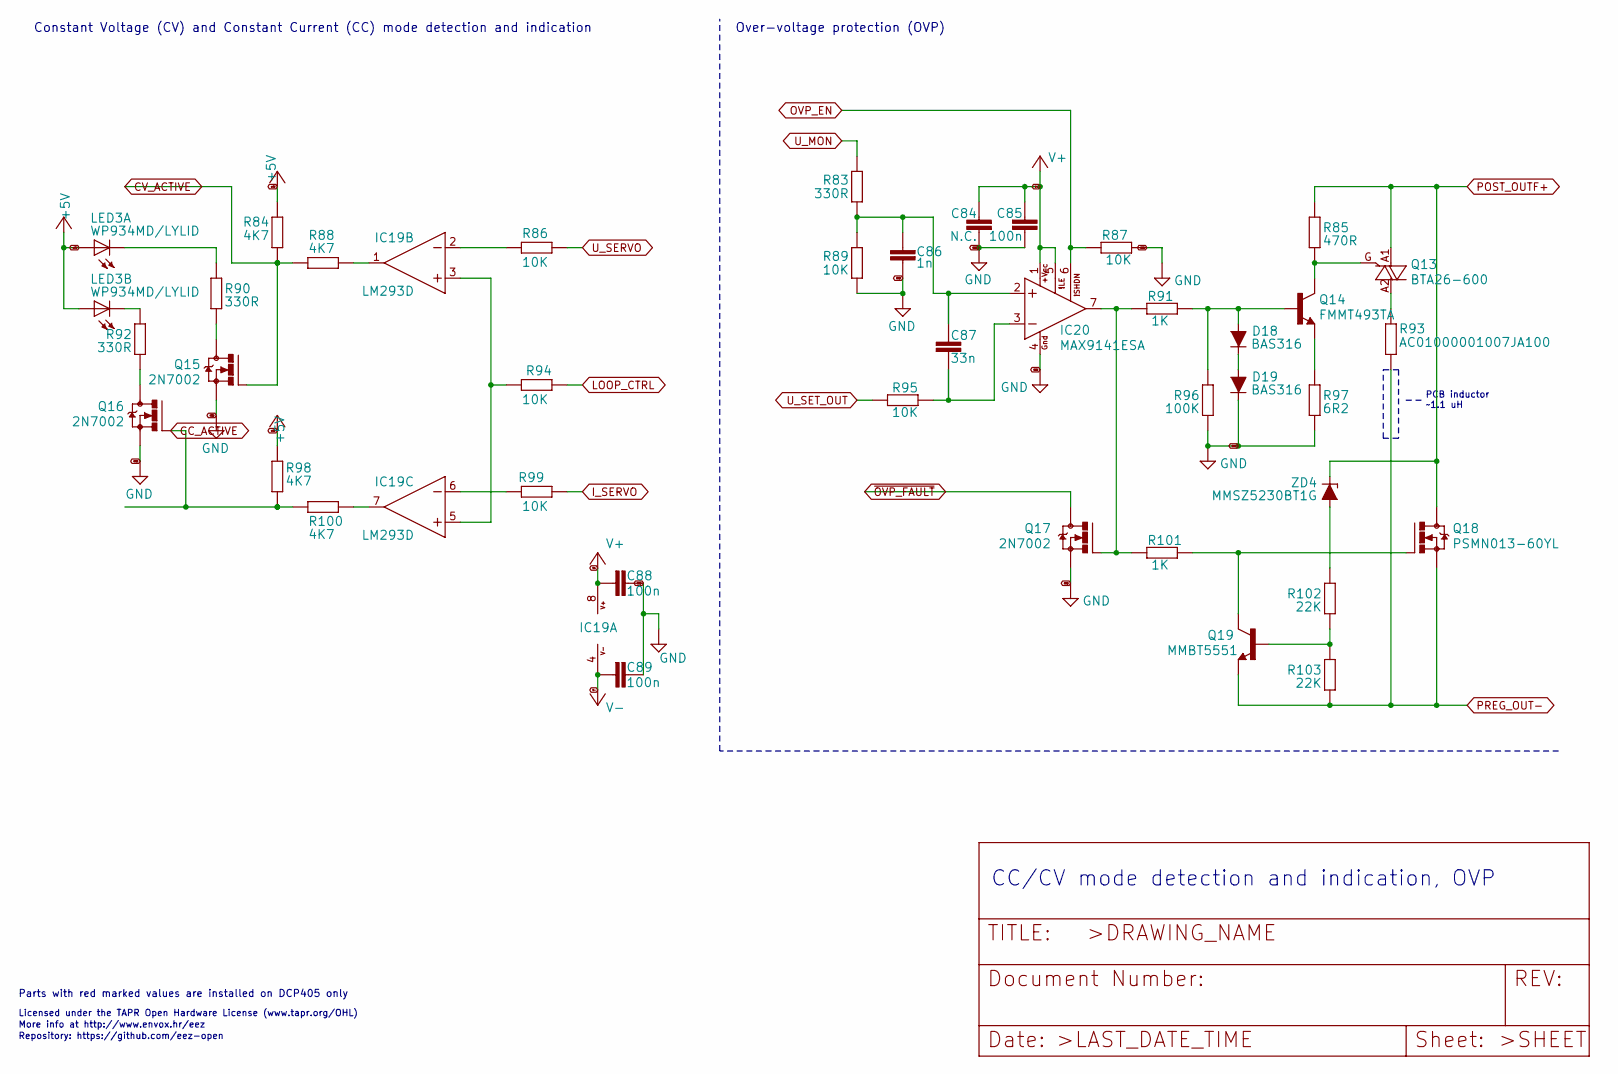
[picture p11: schematic CC%2fCV,_OVP.sch]

Parts:
C84: N.C.; C0805
C85, C88, C89: 100n; C0603
C86: 1n; C0805
C87: 33n; C0805
D18, D19: BAS316; SOD323-R
IC19: LM293D; SOIC127P600X173-8N
IC20: MAX9141ESA; SOIC127P600X173-8N
LED3: WP934MD/LYLID; WP934MD
Q13: BTA26-600; TOP3_TRIAC_NOHOLE
Q14: FMMT493TA; SOT23-BEC
Q15, Q16, Q17: 2N7002; SOT103P240X110-3N
Q18: PSMN013-60YL; SOT669
Q19: MMBT5551; SOT23-BEC
R83, R90, R92: 330R; R0805
R84, R88, R98, R100: 4K7; R0805
R85: 470R; R0805
R86, R87, R89, R94, R95, R99: 10K; R0805
R91, R101: 1K; R0805
R93: AC01000001007JA100; 0411_15
R96: 100K; R0805
R97: 6R2; R0805
R102, R103: 22K; R0805
ZD4: MMSZ5230BT1G; SOD123

Connections:
+5V: LED3.BA (A), LED3.TA (A), R84.2, R98.2; also elsewhere on the board
CC_ACTIVE: Q16.1 (G), R98.1, R100.2; also elsewhere on the board
CV_ACTIVE: Q15.1 (G), R84.1, R88.2; also elsewhere on the board
GND: C84.2, C85.1, C86.1, C88.1, C89.1, D19.C, IC20.4 (GND), Q15.2 (S), Q16.2 (S), Q17.2 (S), R87.1, R89.2, R96.1, R97.1; also elsewhere on the board
I_SERVO: R99.1; also elsewhere on the board
LOOP_CTRL: R94.2; also elsewhere on the board
unnamed: C86.2, C87.1, IC20.2 (+IN), R83.2, R89.1
unnamed: C87.2, IC20.3 (-IN), R95.2
unnamed: D18.A, Q14.B, R91.1, R96.2
unnamed: D18.C, D19.A
unnamed: IC19.1 (OUT), R88.1
unnamed: IC19.2 (-IN), R86.2
unnamed: IC19.3 (+IN), IC19.5 (+IN), R94.1
unnamed: IC19.6 (-IN), R99.2
unnamed: IC19.7 (OUT), R100.1
unnamed: IC20.7 (OUT), Q17.1 (G), R91.2, R101.2
unnamed: LED3.BC (C), R92.2
unnamed: LED3.TC (C), R90.1
unnamed: Q13.A2, R93.2
unnamed: Q13.G, Q14.C, R85.1
unnamed: Q14.E, R97.2
unnamed: Q15.3 (D), R90.2
unnamed: Q16.3 (D), R92.1
unnamed: Q18.4 (G), Q19.C, R101.1
unnamed: Q19.B, R102.1, R103.2
unnamed: R102.2, ZD4.A
OVP_EN: IC20.6 (~SHDN), R87.2; also elsewhere on the board
POST_OUTF+: Q13.A1, Q18.MB (D), R85.2, ZD4.C; also elsewhere on the board
PREG_OUT-: Q18.1 (S), Q18.2 (S), Q18.3 (S), Q19.E, R93.1, R103.1; also elsewhere on the board
U_MON: R83.1; also elsewhere on the board
U_SERVO: R86.1; also elsewhere on the board
U_SET_OUT: R95.1; also elsewhere on the board
V+: C84.1, C85.2, C88.2, IC19.8 (V+), IC20.1 (+VCC), IC20.5 (~LE); also elsewhere on the board
V-: C89.2, IC19.4 (V-); also elsewhere on the board
~OVP_FAULT: Q17.3 (D); also elsewhere on the board

Notes on the sheet:
Licensed under the TAPR Open Hardware License (www.tapr.org/OHL)
Repository: https://github.com/eez-open
More info at http://www.envox.hr/eez
CC/CV mode detection and indication, OVP
Constant Voltage (CV) and Constant Current (CC) mode detection and indication
Over-voltage protection (OVP)
PCB inductor ~~1.1 uH ~
Parts with red marked values are installed on DCP405 only

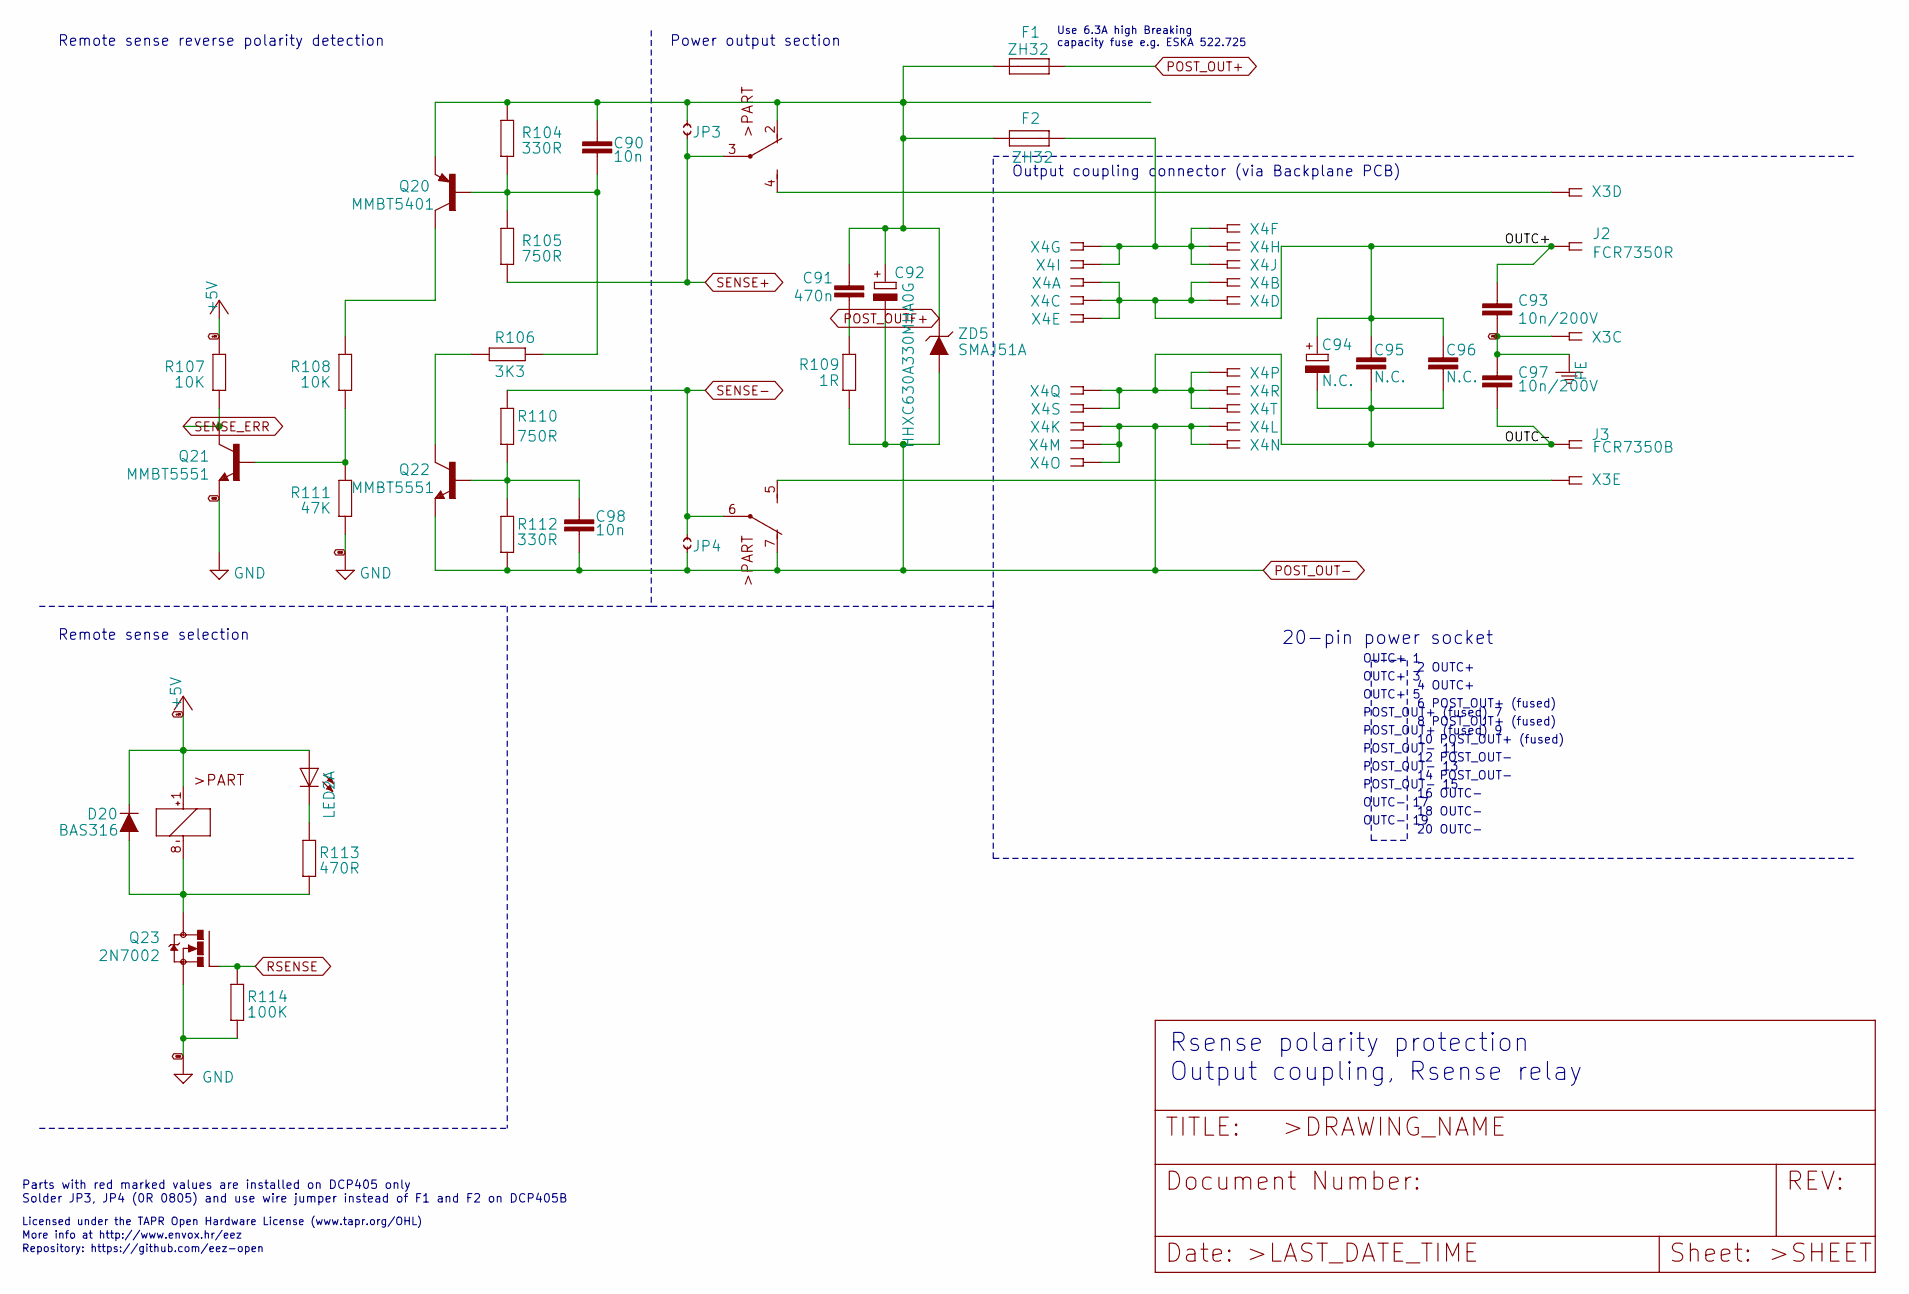
[picture p12: schematic Rsense_protection,_power_output.sch]

Parts:
C90, C98: 10n; C0805
C91: 470n; C0805
C92: HHXC630A330MHA0G; CAPAE830X1050N
C93, C97: 10n/200V; C1206
C94: N.C.; ECAP2_5
C95, C96: N.C.; C0805
D20: BAS316; SOD323-R
F1, F2: ZH32
J2: FCR7350R; S16N-PC
J3: FCR7350B; S16N-PC
JP3, JP4: JP2-CUT-0805; R_0805
K1: G6K-2F-5DC; G6K-2F
LED2: WP934MD/2LID; WP934MD
Q20: MMBT5401; SOT23-BEC
Q21, Q22: MMBT5551; SOT23-BEC
Q23: 2N7002; SOT103P240X110-3N
R104, R112: 330R; R0805
R105, R110: 750R; R0805
R106: 3K3; R0805
R107, R108: 10K; R0805
R109: 1R; R1206
R111: 47K; R0805
R113: 470R; R0805
R114: 100K; R0805
X3: 691322110005; MC1,5_5-G-3,5
X4: DS1024-2*10R0; SSW-110-02-T-D-RA
ZD5: SMAJ51A; DO214AA

Connections:
+5V: D20.C, K1.1 (+), LED2.TA (A), R107.2; also elsewhere on the board
/Rsense protection, power output/OUTC+: C93.1, C94.+, C95.1, C96.1, J2.1, J2.NC1, J2.NC2, J2.NC3, J2.NC4, X4.1, X4.2, X4.3, X4.4, X4.5
/Rsense protection, power output/OUTC-: C94.-, C95.2, C96.2, C97.2, J3.1, J3.NC1, J3.NC2, J3.NC3, J3.NC4, X4.16, X4.17, X4.18, X4.19, X4.20
GND: Q21.E, Q23.2 (S), R111.1, R114.1; also elsewhere on the board
unnamed: C90.2, Q20.B, R104.1, R105.2, R106.2
unnamed: C91.2, R109.2
unnamed: C98.1, Q22.B, R110.1, R112.2
unnamed: D20.A, K1.8 (-), Q23.3 (D), R113.1
unnamed: F2.2, X4.6, X4.7, X4.8, X4.9, X4.10
unnamed: K1.4 (S), X3.4
unnamed: K1.5 (S), X3.5
unnamed: LED2.TC (C), R113.2
unnamed: Q20.C, R108.2
unnamed: Q21.B, R108.1, R111.2
unnamed: Q22.C, R106.1
PE: C93.2, C97.1, X3.3; also elsewhere on the board
POST_OUT+: F1.1; also elsewhere on the board
POST_OUT-: C92.-, C98.2, JP4.1, K1.7 (O), Q22.E, R109.1, R112.1, X4.11, X4.12, X4.13, X4.14, X4.15, ZD5.A; also elsewhere on the board
POST_OUTF+: C90.1, C91.1, C92.+, F1.2, F2.1, JP3.2, K1.2 (O), Q20.E, R104.2, ZD5.C; also elsewhere on the board
RSENSE: Q23.1 (G), R114.2; also elsewhere on the board
SENSE+: JP3.1, K1.3, R105.1; also elsewhere on the board
SENSE-: JP4.2, K1.6, R110.2; also elsewhere on the board
SENSE_ERR: Q21.C, R107.1; also elsewhere on the board

Notes on the sheet:
Rsense polarity protection Output coupling, Rsense relay
Licensed under the TAPR Open Hardware License (www.tapr.org/OHL)
Repository: https://github.com/eez-open
More info at http://www.envox.hr/eez
Remote sense reverse polarity detection
Remote sense selection
POST_OUT+ (fused) 7
16 OUTC-
6 POST_OUT+ (fused)
20-pin power socket
10 POST_OUT+ (fused)
POST_OUT+ (fused) 9
2 OUTC+
12 POST_OUT-
OUTC+ 1
POST_OUT- 11
8 POST_OUT+ (fused)
OUTC+ 5
OUTC- 19
4 OUTC+
OUTC- 17
20 OUTC-
OUTC+ 3
14 POST_OUT-
POST_OUT- 15
POST_OUT- 13
18 OUTC-
Output coupling connector (via Backplane PCB)
Power output section
Use 6.3A high Breaking capacity fuse e.g. ESKA 522.725
Parts with red marked values are installed on DCP405 only Solder JP3, JP4 (0R 0805) and use wire jumper instead of F1 and F2 on DCP405B

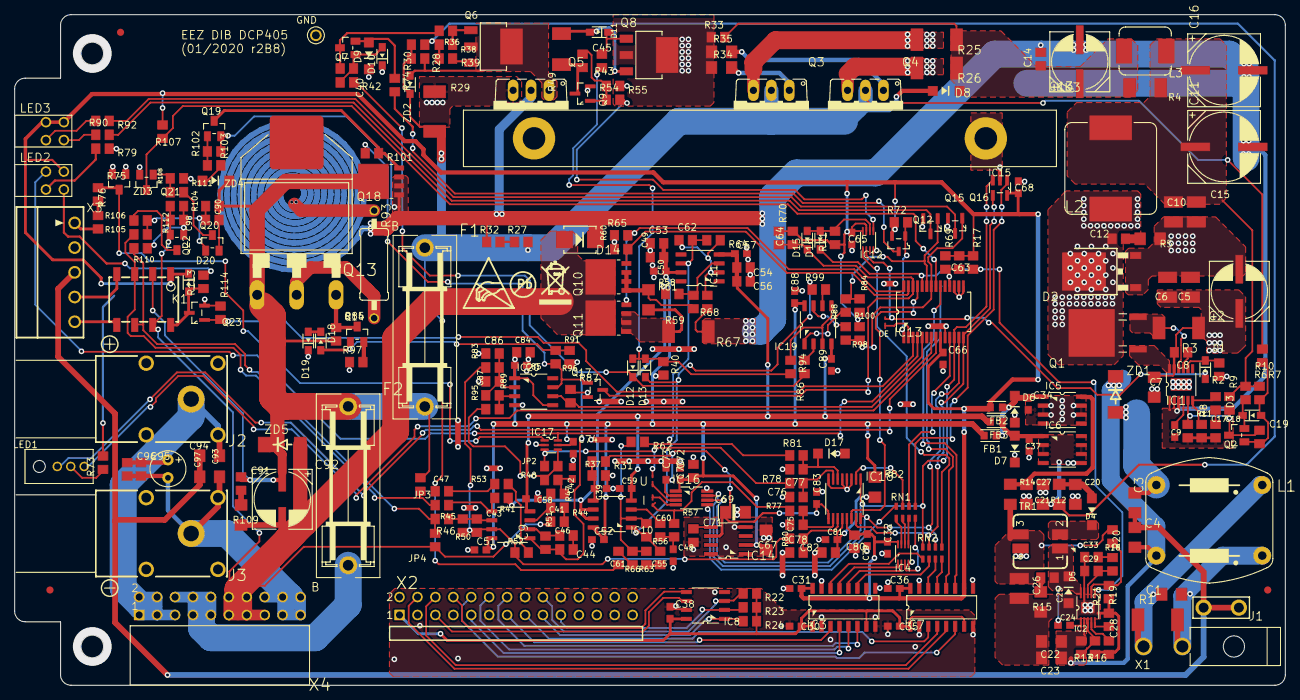
[picture p13: board EEZ DIB DCP405 r2B8.kicad_pcb from above]

Board: 2 copper layers, 180.0 x 95.0 mm, 324 parts (0 on the bottom side), 194 nets.

Other parts of the board:
EEZ_SIGNATURE: SIGNATURESMALL; SIGNATURE_5MM
U$1: RECYCLE_BIN1_8
U$6: ESD_SYMBOL
U$7: PB_SMALL
