goran-mahovlic/modular-psu/dcm220/Kicad/EEZ DIB DCM220 r2B7.kicad_pcb

## KiCad design dcm220/Kicad/EEZ DIB DCM220 r2B7.kicad_pcb (2020-01-07)

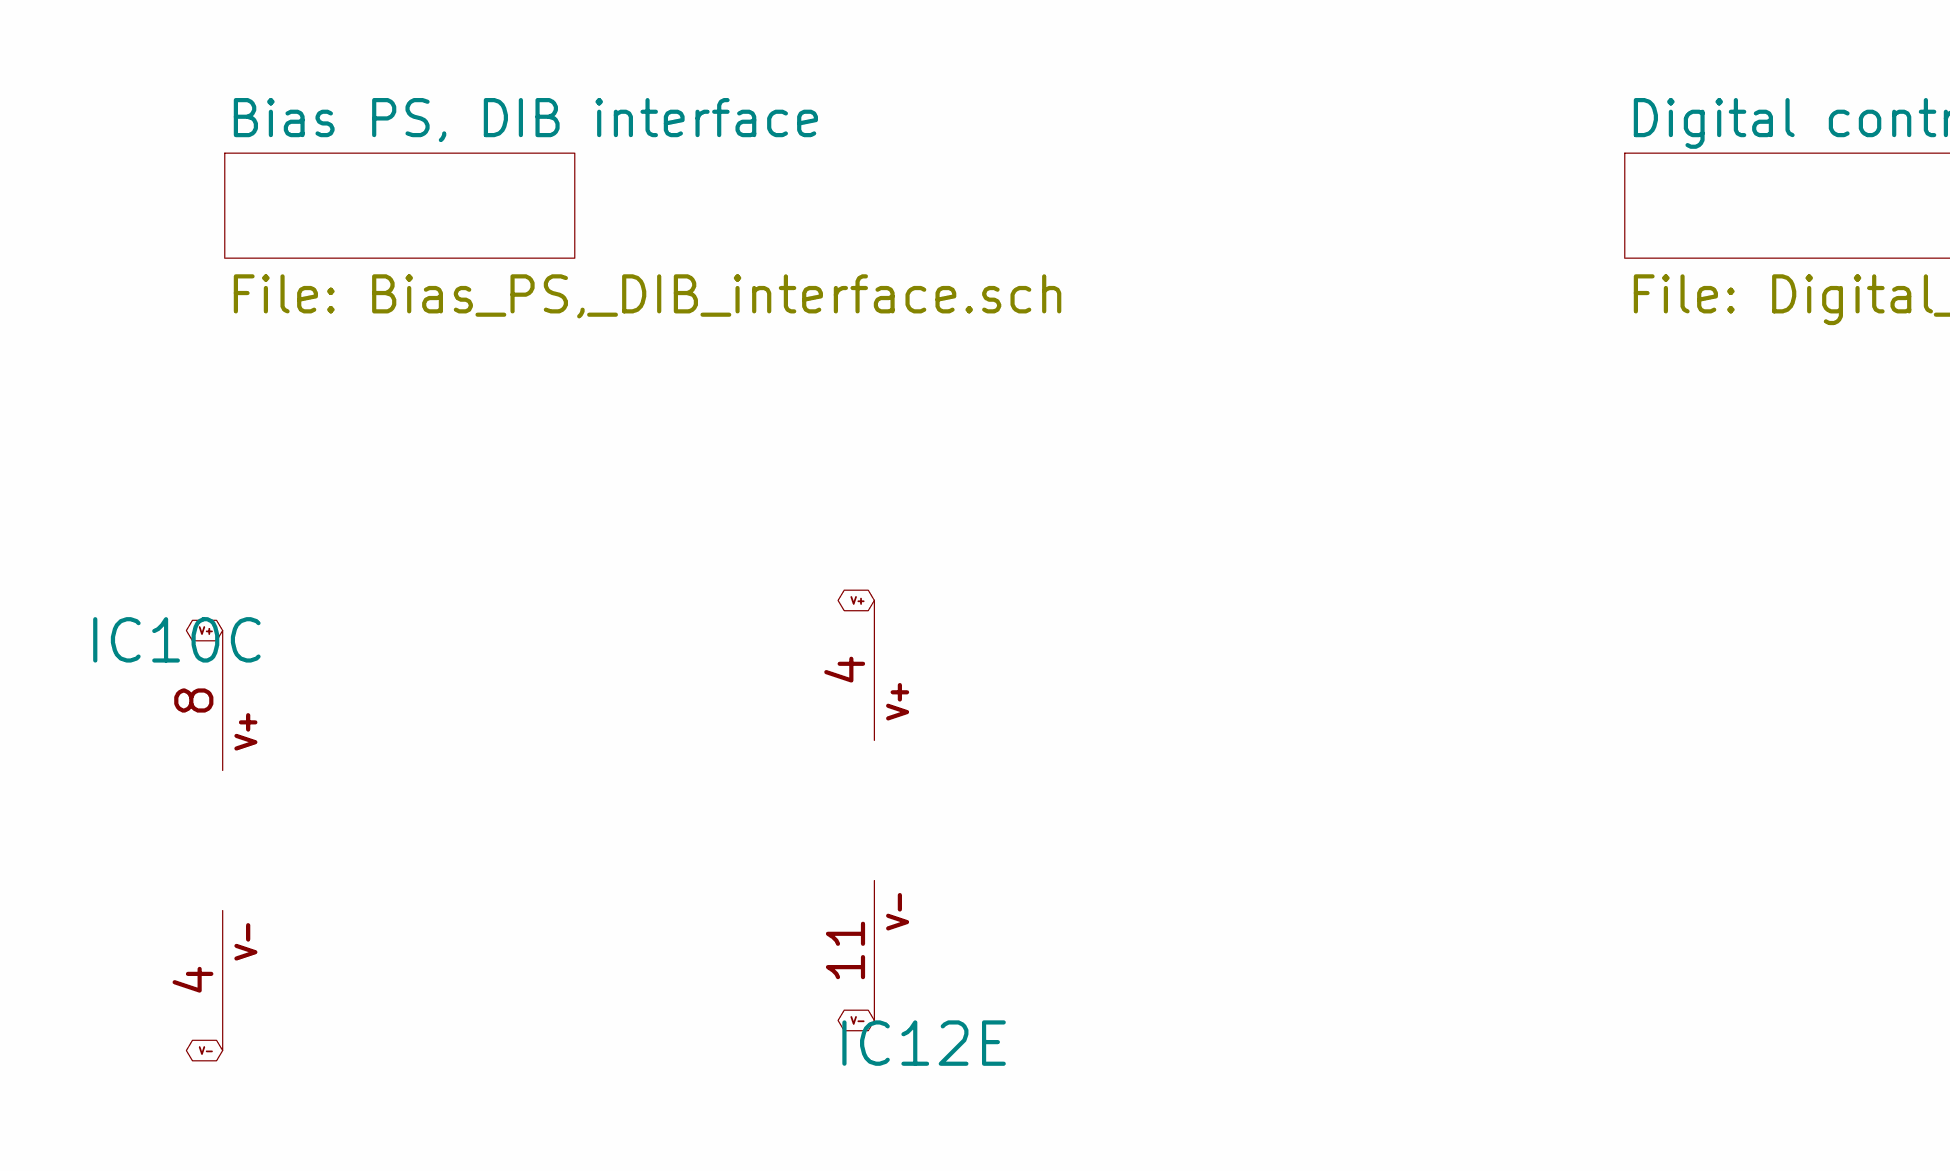
[picture p14: schematic EEZ DIB DCM220 r2B7.sch, part in row 1, column 1]

Parts:
IC10: MC33272ADR2G; SOIC127P600X173-8N
IC12: MC33274ADR2G; SOIC127P600X175-14N

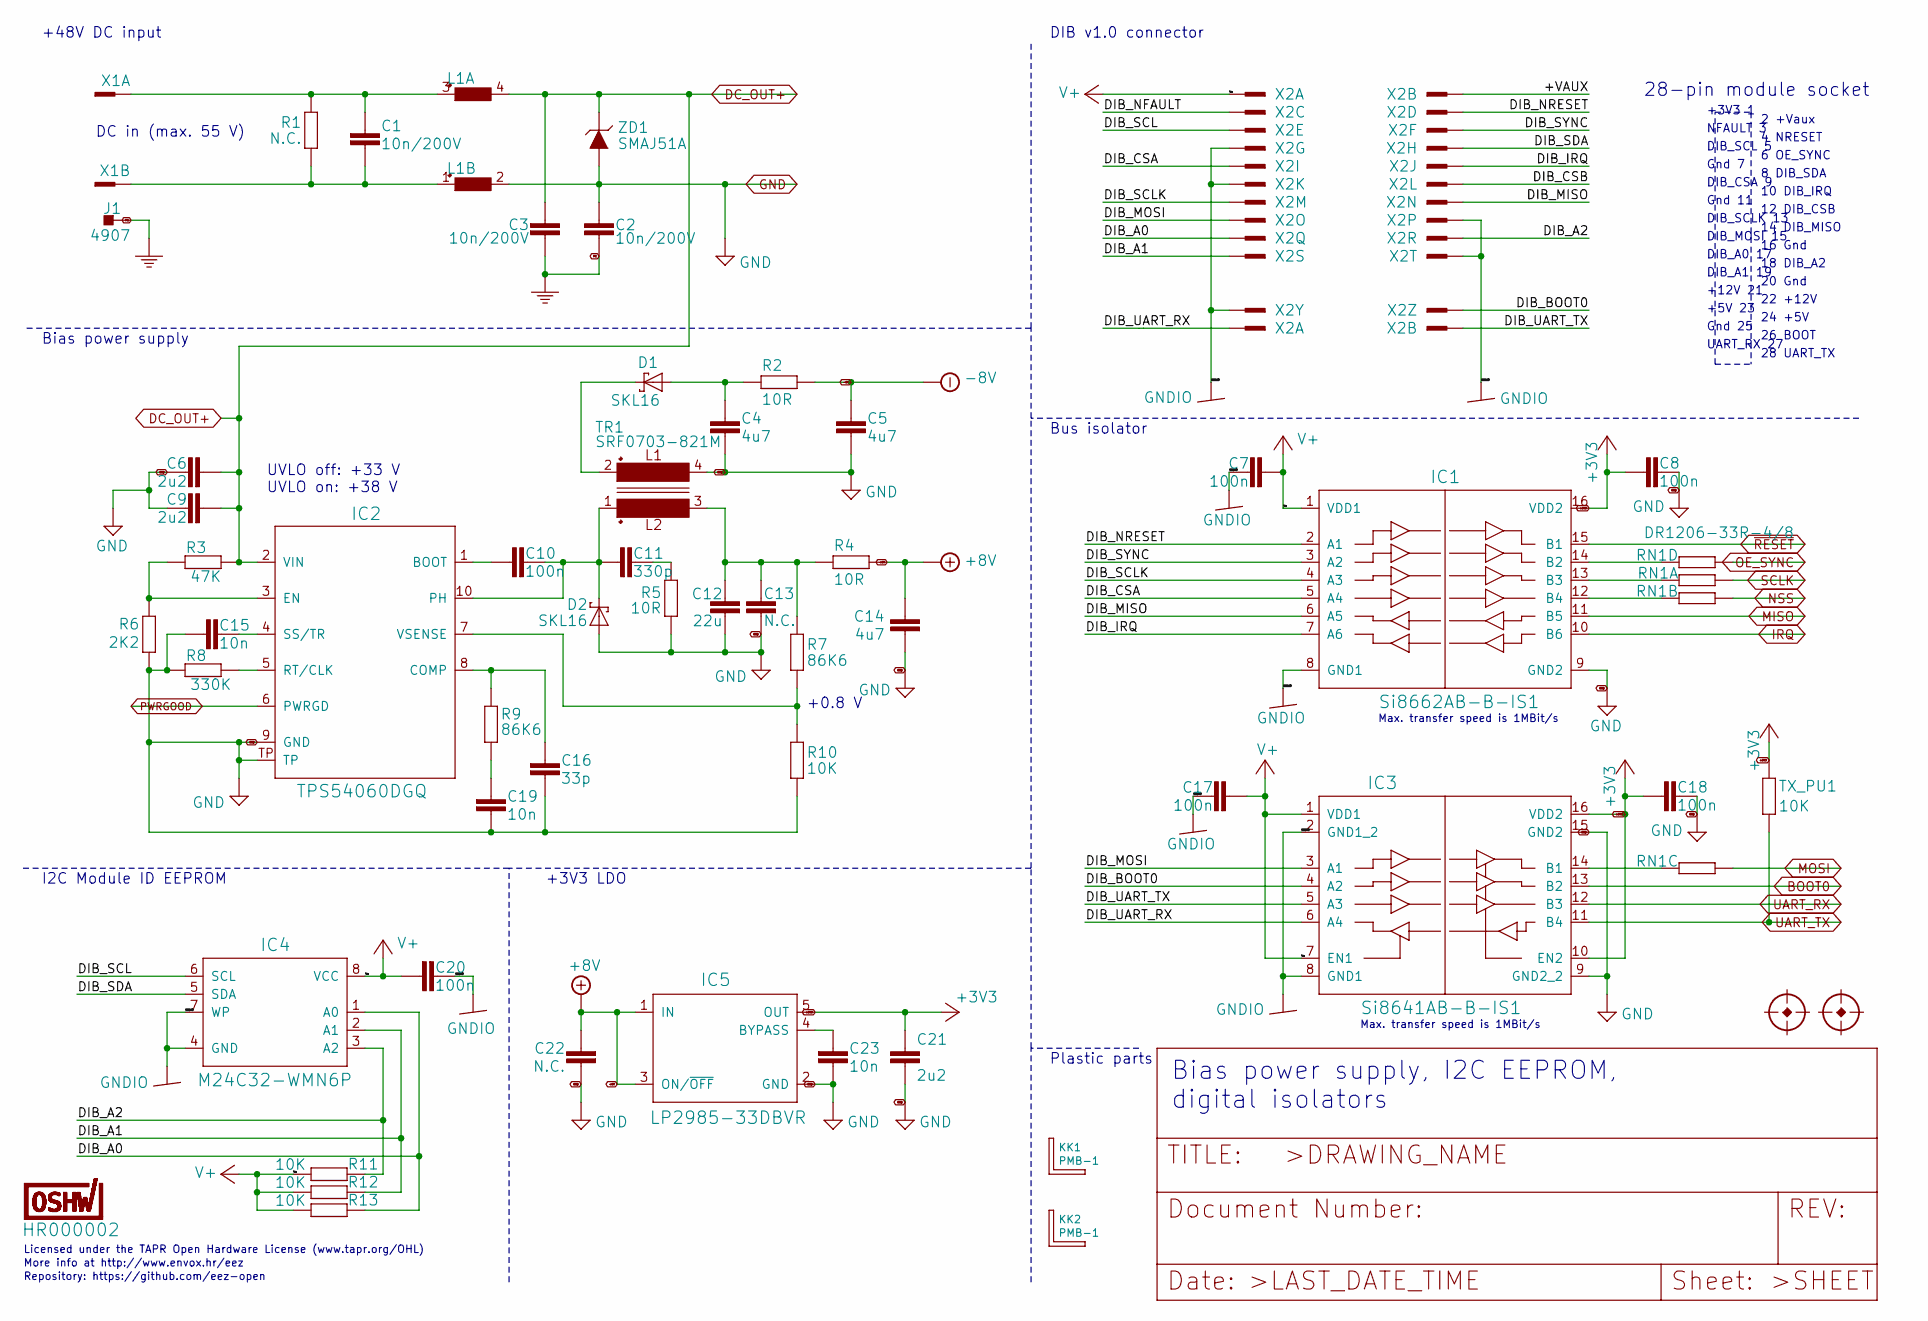
[picture p15: schematic Bias_PS,_DIB_interface.sch]

Parts:
C1, C2, C3: 10n/200V; C1206
C4, C5, C14: 4u7; C1206
C6, C9, C21: 2u2; C1206
C7, C8, C10, C17, C18, C20: 100n; C0603
C11: 330p; C0805
C12: 22u; C1206
C13: N.C.; C1206
C15, C19, C23: 10n; C0805
C16: 33p; C0603
C22: N.C.; C0805
D1, D2: SKL16; SOD123
FM1, FM2: FIDUCIAL_2; FIDUCIAL_DUAL
IC1: Si8662AB-B-IS1; SOIC-16
IC2: TPS54060DGQ; SOP50P490X110-11N
IC3: Si8641AB-B-IS1; SOIC-16
IC4: M24C32-WMN6P; SOIC127P600X173-8N
IC5: LP2985-33DBVR; SOT95P270X145-5N
J1: 4907; PCB_TAB-4907
KK1, KK2: PMB-1; PCB-MB
L1: RN112-4-02-0M7; RN112
R1: N.C.; R2512
R2, R4, R5: 10R; R0805
R3: 47K; R0805
R6: 2K2; R0805
R7, R9: 86K6; R0805
R8: 330K; R0805
R10, R11, R12, R13: 10K; R0805
RN1: DR1206-33R-4/8; CAY16
TR1: SRF0703-821M; SRF0703
TX_PU: 10K; R0805
U$3: HR000002; CERT-SMALL-SILK
X1: 39-30-1020; MINIFIT_39301020
X2: 77317-104-28LF
ZD1: SMAJ51A; DO214AA

Connections:
/Bias PS, DIB interface/+VAUX: X2.2
/Bias PS, DIB interface/DIB_A0: IC4.1 (A0), R13.2, X2.17
/Bias PS, DIB interface/DIB_A1: IC4.2 (A1), R12.2, X2.19
/Bias PS, DIB interface/DIB_A2: IC4.3 (A2), R11.2, X2.18
/Bias PS, DIB interface/DIB_BOOT0: IC3.4 (A2), X2.26
/Bias PS, DIB interface/DIB_CSA: IC1.5 (A4), X2.9
/Bias PS, DIB interface/DIB_CSB: X2.12
/Bias PS, DIB interface/DIB_IRQ: IC1.7 (A6), X2.10
/Bias PS, DIB interface/DIB_MISO: IC1.6 (A5), X2.14
/Bias PS, DIB interface/DIB_MOSI: IC3.3 (A1), X2.15
/Bias PS, DIB interface/DIB_NFAULT: X2.3
/Bias PS, DIB interface/DIB_NRESET: IC1.2 (A1), X2.4
/Bias PS, DIB interface/DIB_SCL: IC4.6 (SCL), X2.5
/Bias PS, DIB interface/DIB_SCLK: IC1.4 (A3), X2.13
/Bias PS, DIB interface/DIB_SDA: IC4.5 (SDA), X2.8
/Bias PS, DIB interface/DIB_SYNC: IC1.3 (A2), X2.6
/Bias PS, DIB interface/DIB_UART_RX: IC3.6 (A4), X2.27
/Bias PS, DIB interface/DIB_UART_TX: IC3.5 (A3), X2.28
BOOT0: IC3.13 (B2); also elsewhere on the board
DC_OUT+: C3.2, C6.1, C9.1, IC2.2 (VIN), L1.4 (2), R3.2, ZD1.C; also elsewhere on the board
GNDIO: C7.2, C17.2, C20.1, IC1.8 (GND1), IC3.2 (GND1_2), IC3.8 (GND1), IC4.4 (GND), IC4.7 (WP), X2.7, X2.11, X2.16, X2.20, X2.25
IRQ: IC1.10 (B6); also elsewhere on the board
MISO: IC1.11 (B5); also elsewhere on the board
MOSI: RN1.5 (2); also elsewhere on the board
NSS: RN1.6 (2); also elsewhere on the board
unnamed: C1.1, L1.1, R1.1, X1.2
unnamed: C1.2, L1.3 (1), R1.2, X1.1
unnamed: C4.1, D1.A, R2.2
unnamed: C10.1, C11.1, D2.C, IC2.10 (PH), TR1.1
unnamed: C10.2, IC2.1 (BOOT)
unnamed: C11.2, R5.2
unnamed: C12.1, C13.1, R4.2, R7.2, TR1.3
unnamed: C15.1, IC2.4 (SS/TR)
unnamed: C16.2, IC2.8 (COMP), R9.2
unnamed: C19.2, R9.1
unnamed: C23.2, IC5.4 (BYPASS)
unnamed: D1.C, TR1.2
unnamed: IC1.12 (B4), RN1.3 (1)
unnamed: IC1.13 (B3), RN1.2 (1)
unnamed: IC1.14 (B2), RN1.1
unnamed: IC2.3 (EN), R3.1, R6.2
unnamed: IC2.5 (RT/CLK), R8.2
unnamed: IC2.7 (VSENSE), R7.1, R10.2
unnamed: IC3.14 (B1), RN1.4 (1)
OE_SYNC: RN1.8 (2); also elsewhere on the board
PE: C2.2, C3.1, J1.1, J1.2; also elsewhere on the board
PWRGOOD: IC2.6 (PWRGD); also elsewhere on the board
SCLK: RN1.7 (2); also elsewhere on the board
UART_RX: IC3.12 (B3); also elsewhere on the board
UART_TX: IC3.11 (B4), TX_PU.1; also elsewhere on the board
~RESET: IC1.15 (B1); also elsewhere on the board

Notes on the sheet:
Licensed under the TAPR Open Hardware License (www.tapr.org/OHL)
Repository: https://github.com/eez-open
More info at http://www.envox.hr/eez
I2C Module ID EEPROM
Bias power supply, I2C EEPROM, digital isolators
Plastic parts
26 BOOT
Gnd 7
22 +12V
16 Gnd
6 OE_SYNC
24 +5V
+5V 23
Gnd 25
28-pin module socket
+12V 21
10 DIB_IRQ
DIB_CSA 9
2 +Vaux
12 DIB_CSB
+3V3 1
Gnd 11
8 DIB_SDA
DIB_SCL 5
DIB_A1 19
4 NRESET
DIB_A0 17
20 Gnd
NFAULT 3
14 DIB_MISO
DIB_MOSI 15
DIB_SCLK 13
18 DIB_A2
DC in (max. 55 V)
Bus isolator
+0.8 V
UART_RX 27
28 UART_TX
UVLO off: +33 V UVLO on: +38 V
+3V3 LDO
Max. transfer speed is 1MBit/s
DIB v1.0 connector
Bias power supply
+48V DC input

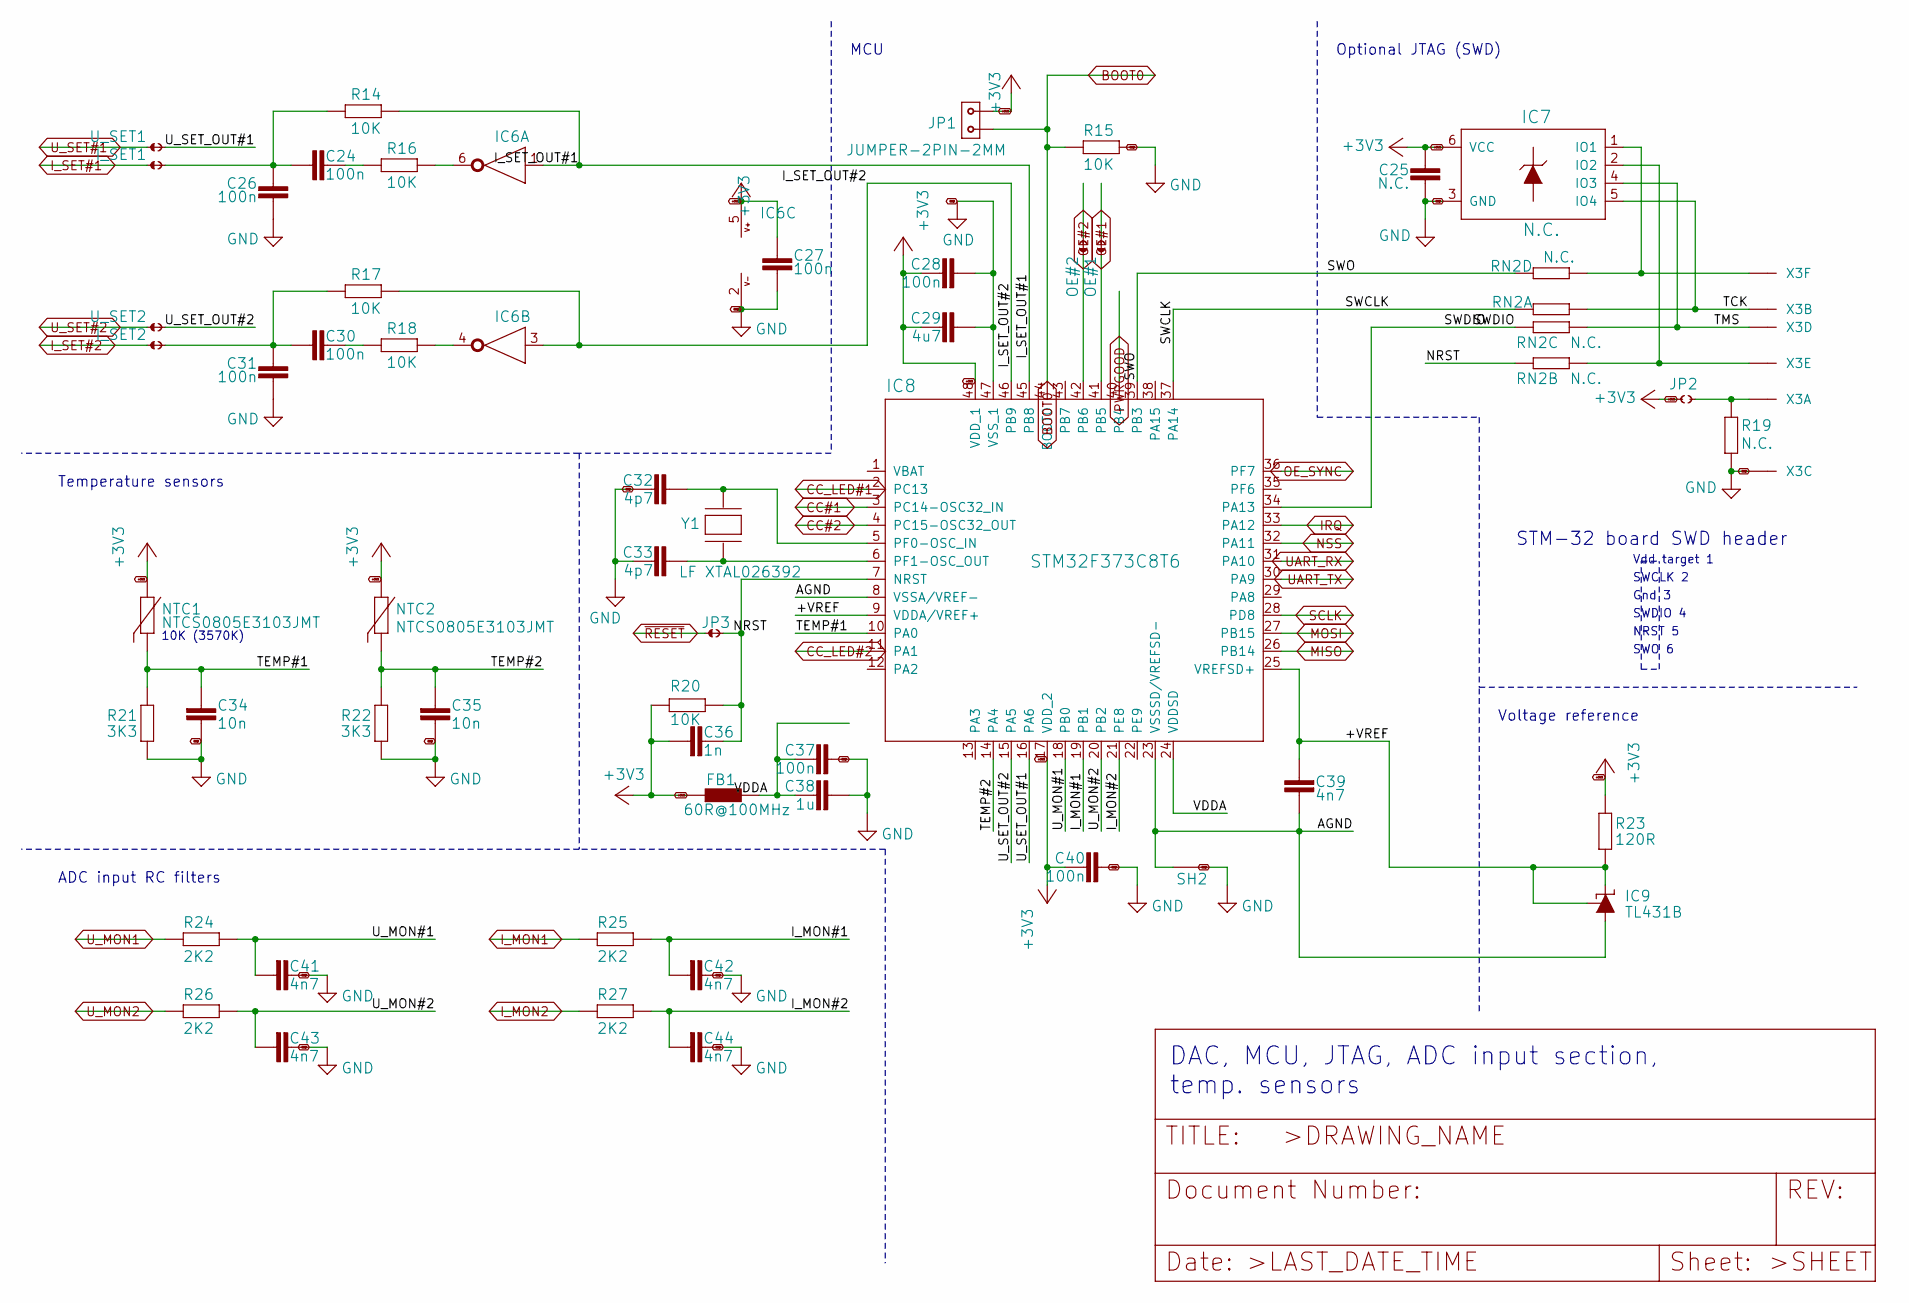
[picture p16: schematic Digital_control.sch]

Parts:
C24, C26, C27, C28, C30, C31, C37, C40: 100n; C0603
C25: N.C.; C0603
C29: 4u7; C1206
C32, C33: 4p7; C0603
C34, C35: 10n; C0805
C36: 1n; C0805
C38: 1u; C0805
C39, C41, C42, C43, C44: 4n7; C0805
FB1: 60R@100MHz; BEAD0603
IC6: 74HC2G04GW,125; SOT65P210X110-6N
IC7: N.C.; DRL6
IC8: STM32F373C8T6; LQFP-48
IC9: TL431B; SOT103P240X110-3N
I_SET1, I_SET2: JP2-NOCUT
JP1: JUMPER-2PIN-2MM; 2MM-2
JP2: JP2-CUT
JP3: JP2-NOCUT
NTC1, NTC2: NTCS0805E3103JMT; R_0805
OE#1, OE#2: JP2-NOCUT
R14, R15, R16, R17, R18, R20: 10K; R0805
R19: N.C.; R0805
R21, R22: 3K3; R0805
R23: 120R; R0805
R24, R25, R26, R27: 2K2; R0805
RN2: N.C.; CAY16
SH2: SHORTNOHOLE; SHORT_NOHOLE
U_SET1, U_SET2: JP2-NOCUT
X3: N.C.; 22-23-2061
Y1: LF XTAL026392; 12SMX(B)

Connections:
/Digital control/+VREF: C39.2, IC8.9 (VDDA/VREF+), IC8.25 (VREFSD+), IC9.1 (C), IC9.2 (R), R23.2
/Digital control/AGND: C39.1, IC8.8 (VSSA/VREF-), IC8.23 (VSSSD/VREFSD-), IC9.3 (A), SH2.1 (GND_A)
/Digital control/I_MON#1: C42.2, IC8.19 (PB1), R25.1
/Digital control/I_MON#2: C44.2, IC8.21 (PE8), R27.1
/Digital control/I_SET_OUT#1: IC6.1 (I), IC8.45 (PB8), R14.2
/Digital control/I_SET_OUT#2: IC6.3 (I), IC8.46 (PB9), R17.2
/Digital control/NRST: C36.1, IC8.7 (NRST), JP3.2, R20.2, RN2.3 (1)
/Digital control/SWCLK: IC8.37 (PA14), RN2.2 (1)
/Digital control/SWDIO: IC8.34 (PA13), RN2.4 (1)
/Digital control/SWO: IC8.39 (PB3), RN2.1
/Digital control/TCK: IC7.5 (IO4), RN2.7 (2), X3.2
/Digital control/TEMP#1: C34.2, IC8.10 (PA0), NTC1.2, R21.1
/Digital control/TEMP#2: C35.2, IC8.14 (PA4), NTC2.2, R22.1
/Digital control/TMS: IC7.4 (IO3), RN2.5 (2), X3.4
/Digital control/U_MON#1: C41.2, IC8.18 (PB0), R24.1
/Digital control/U_MON#2: C43.2, IC8.20 (PB2), R26.1
/Digital control/U_SET_OUT#1: IC8.16 (PA6), U_SET1.2
/Digital control/U_SET_OUT#2: IC8.15 (PA5), U_SET2.2
/Digital control/VDDA: C37.2, C38.2, FB1.P$2 (2), IC8.24 (VDDSD)
BOOT0: IC8.44 (BOOT0), JP1.2, R15.2; also elsewhere on the board
CC#1: IC8.3 (PC14-OSC32_IN); also elsewhere on the board
CC#2: IC8.4 (PC15-OSC32_OUT); also elsewhere on the board
CC_LED#1: IC8.2 (PC13); also elsewhere on the board
CC_LED#2: IC8.11 (PA1); also elsewhere on the board
IRQ: IC8.33 (PA12); also elsewhere on the board
I_MON1: R25.2; also elsewhere on the board
I_MON2: R27.2; also elsewhere on the board
I_SET#1: I_SET1.1; also elsewhere on the board
I_SET#2: I_SET2.1; also elsewhere on the board
MISO: IC8.26 (PB14); also elsewhere on the board
MOSI: IC8.27 (PB15); also elsewhere on the board
NSS: IC8.32 (PA11); also elsewhere on the board
unnamed: C24.1, C26.1, I_SET1.2, R14.1
unnamed: C24.2, R16.1
unnamed: C30.1, C31.1, I_SET2.2, R17.1
unnamed: C30.2, R18.1
unnamed: C32.2, IC8.5 (PF0-OSC_IN), Y1.3 (2)
unnamed: C33.2, IC8.6 (PF1-OSC_OUT), Y1.1
unnamed: IC6.4 (O), R18.2
unnamed: IC6.6 (O), R16.2
unnamed: IC7.1 (IO1), RN2.8 (2), X3.6
unnamed: IC7.2 (IO2), RN2.6 (2), X3.5
unnamed: IC8.41 (PB5), OE#1.1
unnamed: IC8.42 (PB6), OE#2.1
unnamed: JP2.2, R19.2, X3.1
OE#1: OE#1.2; also elsewhere on the board
OE#2: OE#2.2; also elsewhere on the board
OE_SYNC: IC8.36 (PF7); also elsewhere on the board
PWRGOOD: IC8.40 (PB4); also elsewhere on the board
SCLK: IC8.28 (PD8); also elsewhere on the board
UART_RX: IC8.31 (PA10); also elsewhere on the board
UART_TX: IC8.30 (PA9); also elsewhere on the board
U_MON1: R24.2; also elsewhere on the board
U_MON2: R26.2; also elsewhere on the board
U_SET#1: U_SET1.1; also elsewhere on the board
U_SET#2: U_SET2.1; also elsewhere on the board
~RESET: JP3.1; also elsewhere on the board

Notes on the sheet:
DAC, MCU, JTAG, ADC input section, temp. sensors
SWDIO 4
SWCLK 2
Vdd target 1
STM-32 board SWD header
Gnd 3
NRST 5
SWO 6
Optional JTAG (SWD)
MCU
10K (3570K)
Temperature sensors
ADC input RC filters
Voltage reference
