goran-mahovlic/modular-psu/dcm220/Kicad/EEZ DIB DCM220 r2B7.kicad_pcb

## KiCad design dcm220/Kicad/EEZ DIB DCM220 r2B7.kicad_pcb (continued)

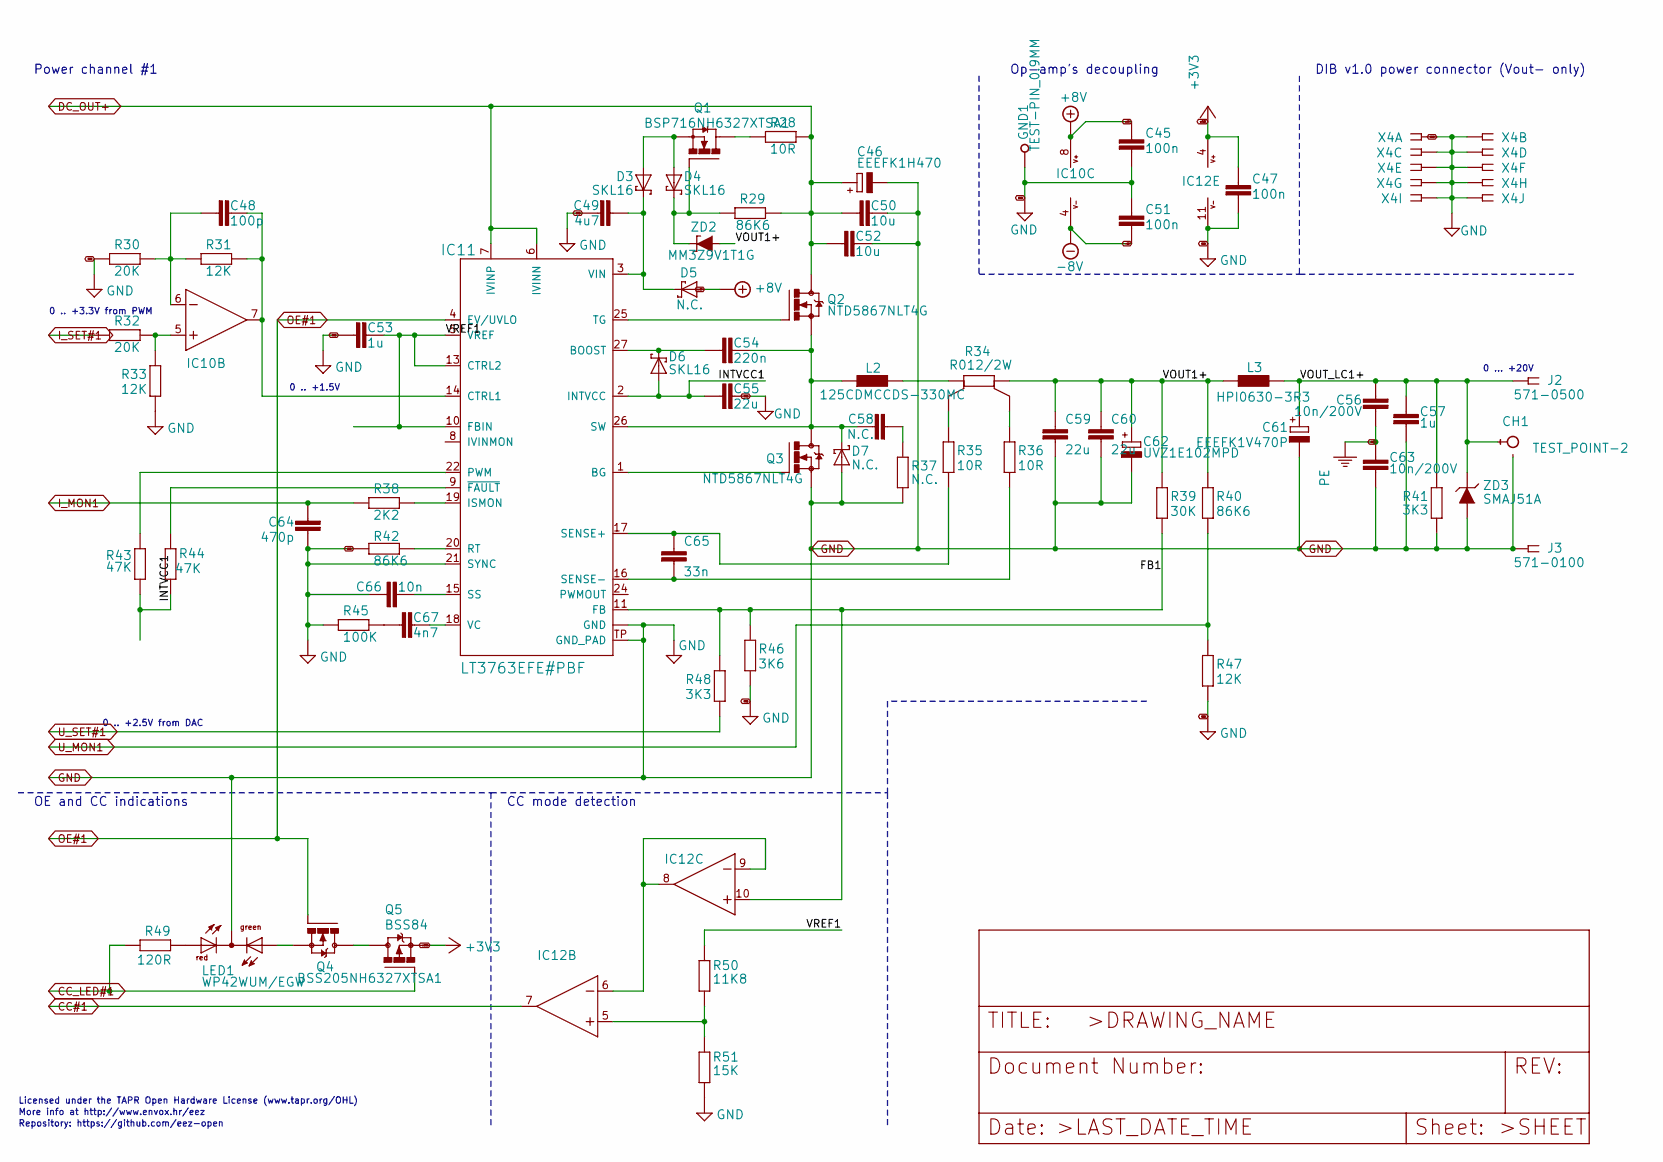
[picture p17: schematic Channel_#1.sch]

Parts:
C45, C47, C51: 100n; C0603
C46: EEEFK1H470; CAPAE830X1050N
C48: 100p; C0805
C49: 4u7; C1206
C50, C52: 10u; C1210
C53, C57: 1u; C0805
C54: 220n; C0805
C55: 22u; C1206
C56, C63: 10n/200V; C1206
C58: N.C.; C0805
C59, C60: 22u; C1210
C61: EEEFK1V470P; CAPAE660X610N
C62: UVZ1E102MPD; ECAP5_10.5
C64: 470p; C0805
C65: 33n; C0805
C66: 10n; C0805
C67: 4n7; C0805
CH1: TEST_POINT-2; TP_1.1MM_2
D3, D4, D6: SKL16; SOD123
D5: N.C.; SOD123
D7: N.C.; SMA
GND: TEST-PIN_0.9MM
IC10: MC33272ADR2G; SOIC127P600X173-8N
IC11: LT3763EFE#PBF; LTC_05-08-1663-EB
IC12: MC33274ADR2G; SOIC127P600X175-14N
J2: 571-0500; DELTRON_571
J3: 571-0100; DELTRON_571
L2: 125CDMCCDS-330MC; 125CDMCC_DS
L3: HPI0630-3R3; COILCRAFT_HPI0630
LED1: WP42WUM/EGW; L-42WUM-1EGWT
Q1: BSP716NH6327XTSA1; SOT223
Q2, Q3: NTD5867NLT4G; TO229P990X239-3N
Q4: BSS205NH6327XTSA1; SOT103P240X110-3N
Q5: BSS84; SOT95P237X112-3N
R28, R35, R36: 10R; R0805
R29, R40, R42: 86K6; R0805
R30, R32: 20K; R0805
R31, R33, R47: 12K; R0805
R34: R012/2W; R_2512-4WIRE
R37: N.C.; R1206
R38: 2K2; R0805
R39: 30K; R0805
R41, R48: 3K3; R0805
R43, R44: 47K; R0805
R45: 100K; R0805
R46: 3K6; R0805
R49: 120R; R0805
R50: 11K8; R0805
R51: 15K; R0805
X4: DS1024-2*5R0; SSW-105-02-T-D-RA
ZD2: MM3Z9V1T1G; SOD323-W
ZD3: SMAJ51A; DO214AA

Connections:
/Channel #1/FB1: IC11.11 (FB), IC12.10 (+IN), R39.1, R46.2, R48.2
/Channel #1/INTVCC1: C55.1, D6.A, IC11.2 (INTVCC), R43.1, R44.2
/Channel #1/VOUT1+: C59.1, C60.1, C62.+, L3.1, R34.2, R39.2, R40.2, ZD2.A
/Channel #1/VOUT_LC1+: C56.2, C57.1, C61.1 (+), CH1.TIP, J2.1, J2.1.1, L3.2, R41.1, ZD3.C
/Channel #1/VREF1: C53.1, IC11.5 (VREF), IC11.10 (FBIN), IC11.13 (CTRL2), R50.2
CC#1: IC12.7 (OUT); also elsewhere on the board
CC_LED#1: Q5.1 (G), R49.2; also elsewhere on the board
DC_OUT+: C46.+, C50.1, C52.1, IC11.6 (IVINN), IC11.7 (IVINP), Q2.2 (D), R28.1, R29.1; also elsewhere on the board
I_MON1: C64.2, R38.1; also elsewhere on the board
I_SET#1: R32.1; also elsewhere on the board
unnamed: C48.1, IC10.7 (OUT), IC11.14 (CTRL1), R31.2
unnamed: C48.2, IC10.6 (-IN), R30.2, R31.1
unnamed: C49.1, D3.C, D5.C, IC11.3 (VIN)
unnamed: C54.1, D6.C, IC11.27 (BOOST)
unnamed: C54.2, C58.1, D7.C, IC11.26 (SW), L2.1, Q2.3 (S), Q3.2 (D)
unnamed: C58.2, R37.2
unnamed: C65.1, IC11.17 (SENSE+), R35.1
unnamed: C65.2, IC11.16 (SENSE-), R36.1
unnamed: C66.2, IC11.15 (SS)
unnamed: C67.1, R45.2
unnamed: C67.2, IC11.18 (VC)
unnamed: D3.A, D4.A, Q1.3 (S)
unnamed: D4.C, Q1.1 (G), R29.2, ZD2.C
unnamed: IC10.5 (+IN), R32.2, R33.2
unnamed: IC11.1 (BG), Q3.1 (G)
unnamed: IC11.9 (~FAULT), R44.1
unnamed: IC11.19 (ISMON), R38.2
unnamed: IC11.20 (RT), R42.2
unnamed: IC11.22 (PWM), R43.2
unnamed: IC11.25 (TG), Q2.1 (G)
unnamed: IC12.5 (+IN), R50.1, R51.2
unnamed: IC12.6 (-IN), IC12.8 (OUT), IC12.9 (-IN)
unnamed: L2.2, R34.1
unnamed: LED1.GREEN (AG), Q4.2 (S)
unnamed: LED1.RED (AR), R49.1
unnamed: Q1.2 (D), Q1.4 (D), R28.2
unnamed: Q4.3 (D), Q5.3 (D)
unnamed: R34.1S, R35.2
unnamed: R34.2S, R36.2
OE#1: IC11.4 (EV/UVLO), Q4.1 (G); also elsewhere on the board
PE: C56.1, C63.1; also elsewhere on the board
U_MON1: R40.1, R47.2; also elsewhere on the board
U_SET#1: R48.1; also elsewhere on the board

Notes on the sheet:
Licensed under the TAPR Open Hardware License (www.tapr.org/OHL)
Repository: https://github.com/eez-open
More info at http://www.envox.hr/eez
0 ... +20V
0 .. +3.3V from PWM
0 .. +1.5V
0 .. +2.5V from DAC
Power channel #1
CC mode detection
DIB v1.0 power connector (Vout- only)
Op-amp's decoupling
OE and CC indications

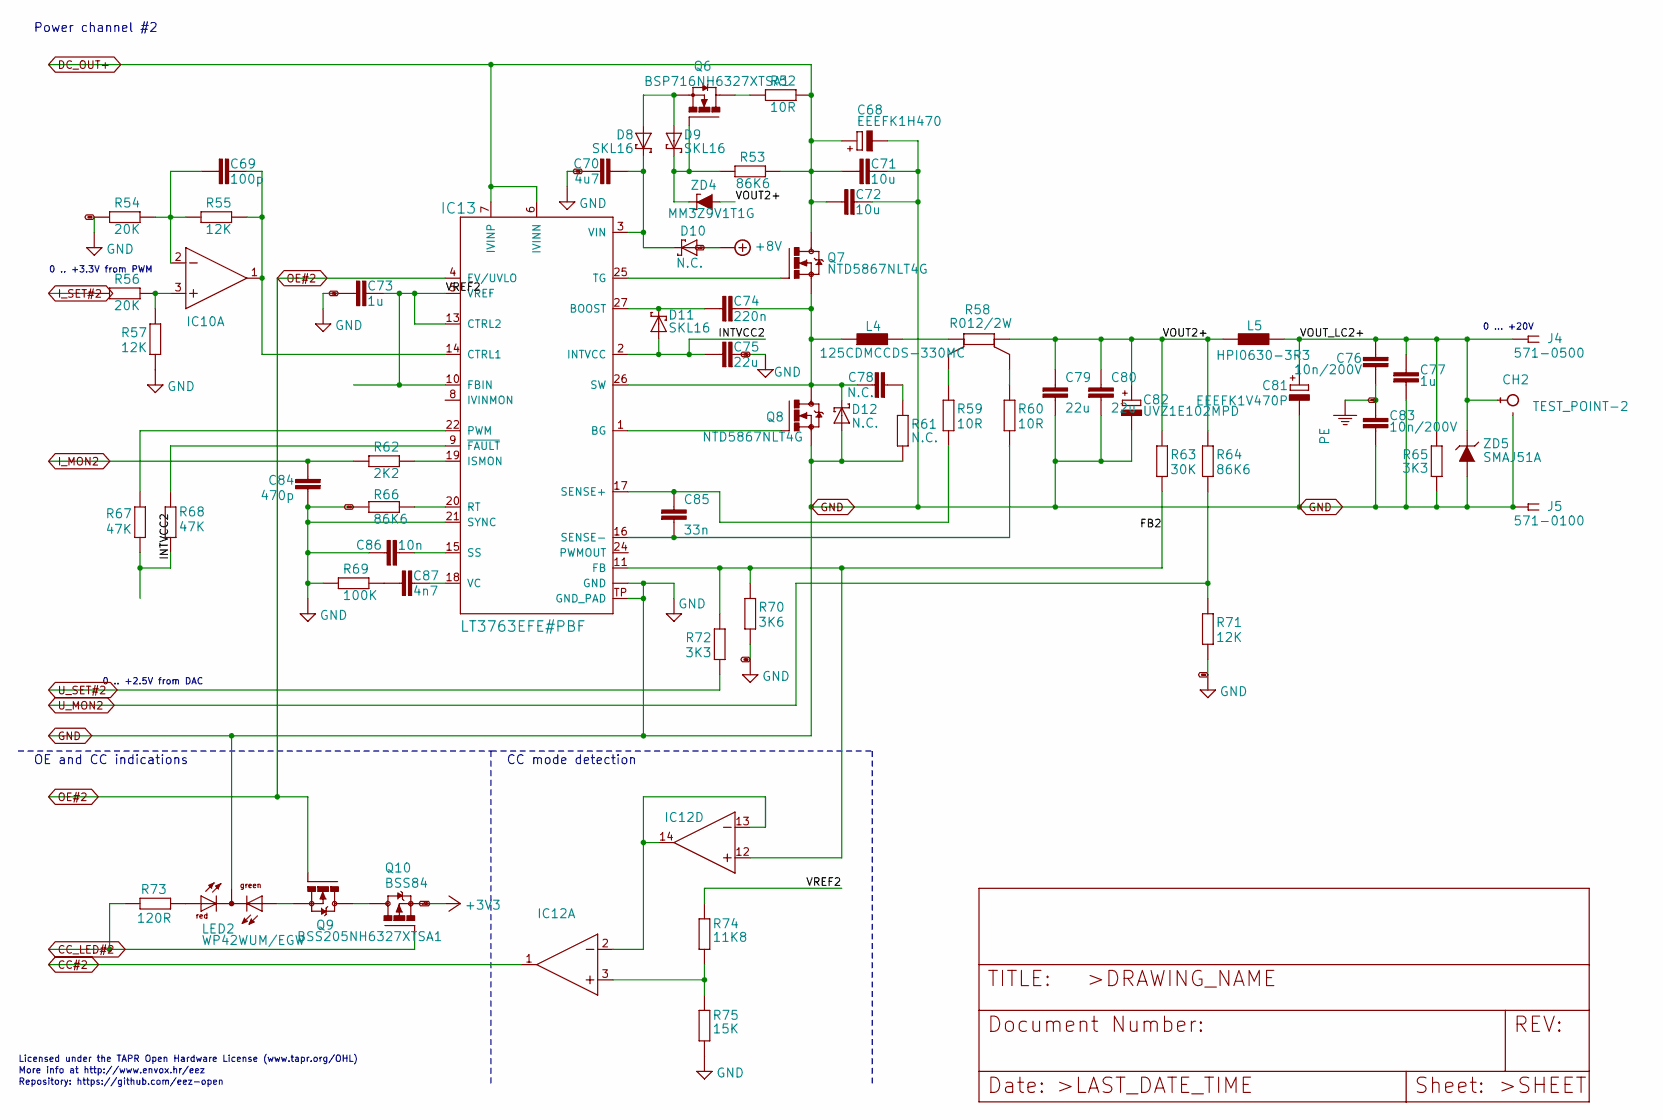
[picture p18: schematic Channel_#2.sch]

Parts:
C68: EEEFK1H470; CAPAE830X1050N
C69: 100p; C0805
C70: 4u7; C1206
C71, C72: 10u; C1210
C73, C77: 1u; C0805
C74: 220n; C0805
C75: 22u; C1206
C76, C83: 10n/200V; C1206
C78: N.C.; C0805
C79, C80: 22u; C1210
C81: EEEFK1V470P; CAPAE660X610N
C82: UVZ1E102MPD; ECAP5_10.5
C84: 470p; C0805
C85: 33n; C0805
C86: 10n; C0805
C87: 4n7; C0805
CH2: TEST_POINT-2; TP_1.1MM_2
D8, D9, D11: SKL16; SOD123
D10: N.C.; SOD123
D12: N.C.; SMA
IC10: MC33272ADR2G; SOIC127P600X173-8N
IC12: MC33274ADR2G; SOIC127P600X175-14N
IC13: LT3763EFE#PBF; LTC_05-08-1663-EB
J4: 571-0500; DELTRON_571
J5: 571-0100; DELTRON_571
L4: 125CDMCCDS-330MC; 125CDMCC_DS
L5: HPI0630-3R3; COILCRAFT_HPI0630
LED2: WP42WUM/EGW; L-42WUM-1EGWT
Q6: BSP716NH6327XTSA1; SOT223
Q7, Q8: NTD5867NLT4G; TO229P990X239-3N
Q9: BSS205NH6327XTSA1; SOT103P240X110-3N
Q10: BSS84; SOT95P237X112-3N
R52, R59, R60: 10R; R0805
R53, R64, R66: 86K6; R0805
R54, R56: 20K; R0805
R55, R57, R71: 12K; R0805
R58: R012/2W; R_2512-4WIRE
R61: N.C.; R1206
R62: 2K2; R0805
R63: 30K; R0805
R65, R72: 3K3; R0805
R67, R68: 47K; R0805
R69: 100K; R0805
R70: 3K6; R0805
R73: 120R; R0805
R74: 11K8; R0805
R75: 15K; R0805
ZD4: MM3Z9V1T1G; SOD323-W
ZD5: SMAJ51A; DO214AA

Connections:
/Channel #2/FB2: IC12.12 (+IN), IC13.11 (FB), R63.1, R70.2, R72.2
/Channel #2/INTVCC2: C75.1, D11.A, IC13.2 (INTVCC), R67.1, R68.2
/Channel #2/VOUT2+: C79.1, C80.1, C82.+, L5.1, R58.2, R63.2, R64.2, ZD4.A
/Channel #2/VOUT_LC2+: C76.2, C77.1, C81.1 (+), CH2.TIP, J4.1, J4.1.1, L5.2, R65.1, ZD5.C
/Channel #2/VREF2: C73.1, IC13.5 (VREF), IC13.10 (FBIN), IC13.13 (CTRL2), R74.2
CC#2: IC12.1 (OUT); also elsewhere on the board
CC_LED#2: Q10.1 (G), R73.2; also elsewhere on the board
DC_OUT+: C68.+, C71.1, C72.1, IC13.6 (IVINN), IC13.7 (IVINP), Q7.2 (D), R52.1, R53.1; also elsewhere on the board
I_MON2: C84.2, R62.1; also elsewhere on the board
I_SET#2: R56.1; also elsewhere on the board
unnamed: C69.1, IC10.1 (OUT), IC13.14 (CTRL1), R55.2
unnamed: C69.2, IC10.2 (-IN), R54.2, R55.1
unnamed: C70.1, D8.C, D10.C, IC13.3 (VIN)
unnamed: C74.1, D11.C, IC13.27 (BOOST)
unnamed: C74.2, C78.1, D12.C, IC13.26 (SW), L4.1, Q7.3 (S), Q8.2 (D)
unnamed: C78.2, R61.2
unnamed: C85.1, IC13.17 (SENSE+), R59.1
unnamed: C85.2, IC13.16 (SENSE-), R60.1
unnamed: C86.2, IC13.15 (SS)
unnamed: C87.1, R69.2
unnamed: C87.2, IC13.18 (VC)
unnamed: D8.A, D9.A, Q6.3 (S)
unnamed: D9.C, Q6.1 (G), R53.2, ZD4.C
unnamed: IC10.3 (+IN), R56.2, R57.2
unnamed: IC12.3 (+IN), R74.1, R75.2
unnamed: IC12.2 (-IN), IC12.13 (-IN), IC12.14 (OUT)
unnamed: IC13.1 (BG), Q8.1 (G)
unnamed: IC13.9 (~FAULT), R68.1
unnamed: IC13.19 (ISMON), R62.2
unnamed: IC13.20 (RT), R66.2
unnamed: IC13.22 (PWM), R67.2
unnamed: IC13.25 (TG), Q7.1 (G)
unnamed: L4.2, R58.1
unnamed: LED2.GREEN (AG), Q9.2 (S)
unnamed: LED2.RED (AR), R73.1
unnamed: Q6.2 (D), Q6.4 (D), R52.2
unnamed: Q9.3 (D), Q10.3 (D)
unnamed: R58.1S, R59.2
unnamed: R58.2S, R60.2
OE#2: IC13.4 (EV/UVLO), Q9.1 (G); also elsewhere on the board
PE: C76.1, C83.1; also elsewhere on the board
U_MON2: R64.1, R71.2; also elsewhere on the board
U_SET#2: R72.1; also elsewhere on the board

Notes on the sheet:
Licensed under the TAPR Open Hardware License (www.tapr.org/OHL)
Repository: https://github.com/eez-open
More info at http://www.envox.hr/eez
0 ... +20V
CC mode detection
OE and CC indications
Power channel #2
0 .. +3.3V from PWM
0 .. +2.5V from DAC

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
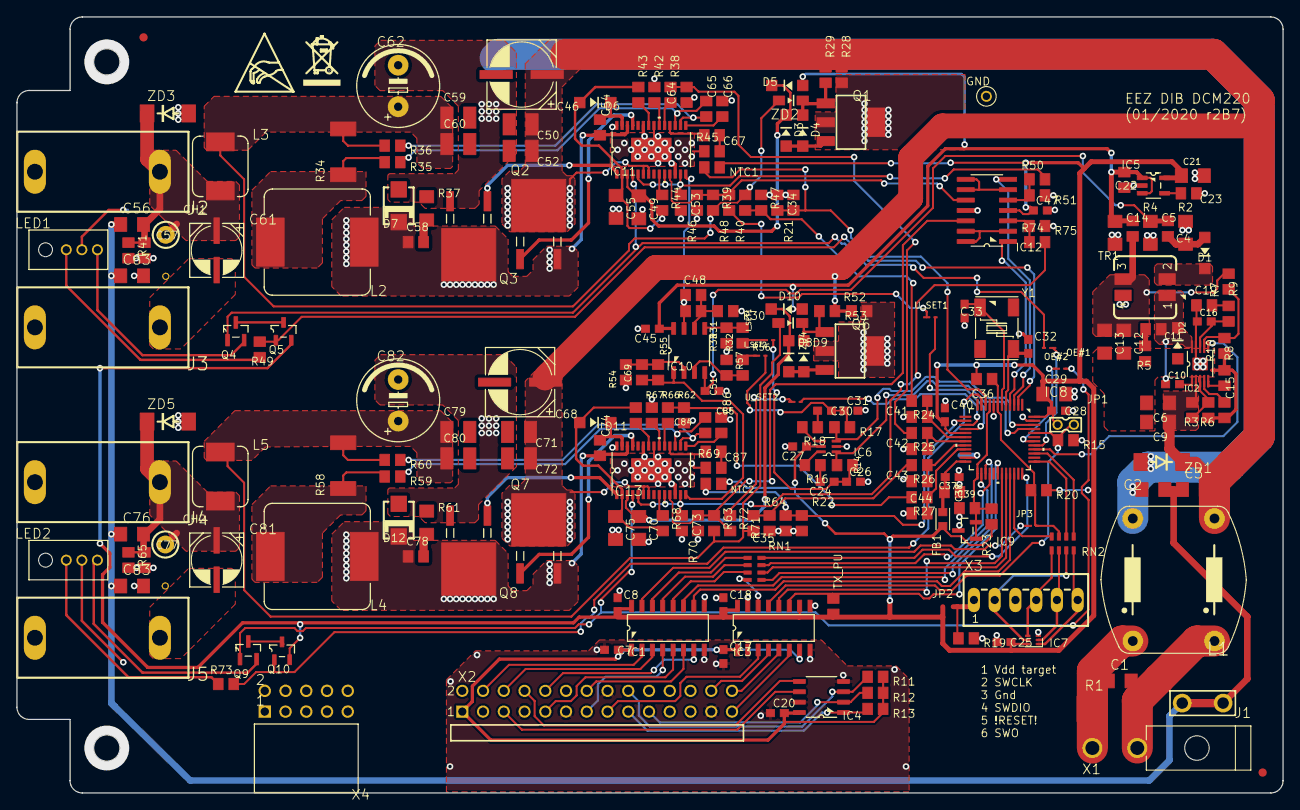
[picture p19: board EEZ DIB DCM220 r2B7.kicad_pcb from above]

Board: 2 copper layers, 155.0 x 95.0 mm, 247 parts (0 on the bottom side), 168 nets.

Other parts of the board:
EEZ_SIGNATURE: SIGNATURESMALL; SIGNATURE_5MM
U$2: RECYCLE_BIN1_8
U$4: ESD_SYMBOL
