goran-mahovlic/modular-psu/bp3c/Kicad/EEZ DIB BP3C r3B2.kicad_pcb

## KiCad design bp3c/Kicad/EEZ DIB BP3C r3B2.kicad_pcb (2020-01-07)

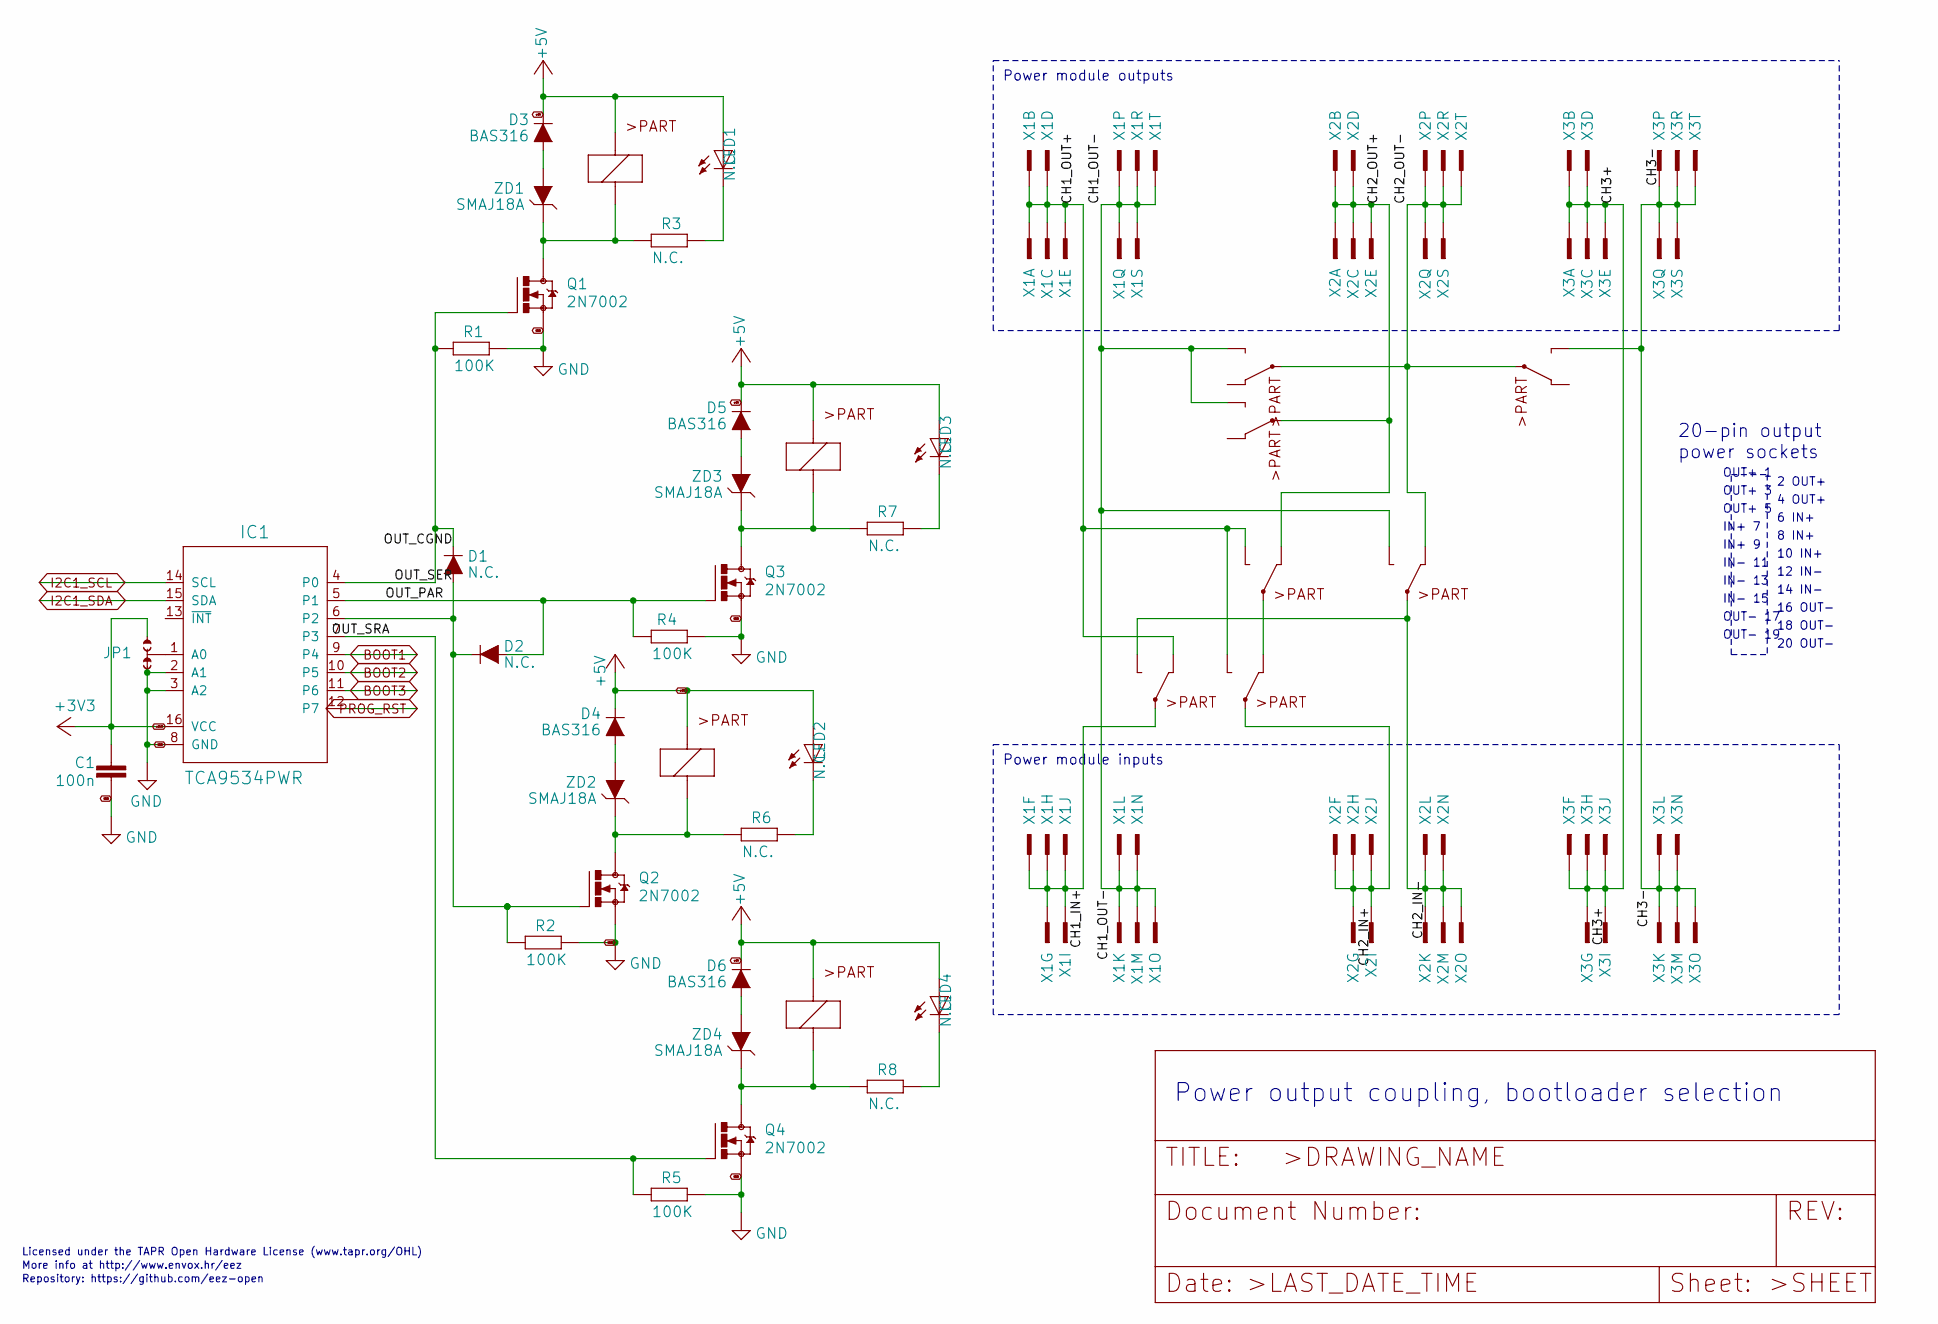
[picture p20: schematic EEZ_DIB_BP3C_r3B2_1.sch]

Parts:
C1: 100n; C0603
D1, D2: N.C.; SOD323-R
D3, D4, D5, D6: BAS316; SOD323-R
IC1: TCA9534PWR; PW(R-PDSO-G16)
JP1: JP3-CUT
K1, K2, K3, K4: RT424005; RT-C_016A5_ROUND
LED1, LED2, LED3, LED4: N.C.; LED_0805
Q1, Q2, Q3, Q4: 2N7002; SOT103P240X110-3N
R1, R2, R4, R5: 100K; R0805
R3, R6, R7, R8: N.C.; R0805
X1, X2, X3: ZL202-20G; DS1021-2*10SF11
ZD1, ZD2, ZD3, ZD4: SMAJ18A; DO214AC

Connections:
+3V3: C1.1, IC1.16 (VCC), JP1.NO; also elsewhere on the board
+5V: D3.C, D4.C, D5.C, D6.C, K1.A2 (C1), K2.A2 (C1), K3.A2 (C1), K4.A2 (C1), LED1.A, LED2.A, LED3.A, LED4.A; also elsewhere on the board
/EEZ DIB BP3C r3B2_1/CH1_IN+: K1.11A, X1.6, X1.7, X1.8, X1.9, X1.10
/EEZ DIB BP3C r3B2_1/CH1_OUT+: K1.12A (S), K1.14B (O), K2.14A (O), X1.1, X1.2, X1.3, X1.4, X1.5
/EEZ DIB BP3C r3B2_1/CH1_OUT-: K2.14B (O), K3.14A (O), K4.14A (O), X1.11, X1.12, X1.13, X1.14, X1.15, X1.16, X1.17, X1.18, X1.19, X1.20
/EEZ DIB BP3C r3B2_1/CH2_IN+: K1.11B, X2.6, X2.7, X2.8, X2.9, X2.10
/EEZ DIB BP3C r3B2_1/CH2_IN-: K1.14A (O), K2.11B, X2.11, X2.12, X2.13, X2.14, X2.15
/EEZ DIB BP3C r3B2_1/CH2_OUT+: K2.12A (S), K4.11A, X2.1, X2.2, X2.3, X2.4, X2.5
/EEZ DIB BP3C r3B2_1/CH2_OUT-: K2.12B (S), K3.11A, K3.11B, X2.16, X2.17, X2.18, X2.19, X2.20
/EEZ DIB BP3C r3B2_1/CH3+: X3.1, X3.2, X3.3, X3.4, X3.5, X3.6, X3.7, X3.8, X3.9, X3.10
/EEZ DIB BP3C r3B2_1/CH3-: K3.14B (O), X3.11, X3.12, X3.13, X3.14, X3.15, X3.16, X3.17, X3.18, X3.19, X3.20
/EEZ DIB BP3C r3B2_1/OUT_CGND: D1.C, IC1.4 (P0), Q1.1 (G), R1.2
/EEZ DIB BP3C r3B2_1/OUT_PAR: D2.A, IC1.5 (P1), Q3.1 (G), R4.2
/EEZ DIB BP3C r3B2_1/OUT_SER: D1.A, D2.C, IC1.6 (P2), Q2.1 (G), R2.2
/EEZ DIB BP3C r3B2_1/OUT_SRA: IC1.7 (P3), Q4.1 (G), R5.2
BOOT1: IC1.9 (P4); also elsewhere on the board
BOOT2: IC1.10 (P5); also elsewhere on the board
BOOT3: IC1.11 (P6); also elsewhere on the board
GND: C1.2, IC1.2 (A1), IC1.3 (A2), IC1.8 (GND), JP1.NC, Q1.2 (S), Q2.2 (S), Q3.2 (S), Q4.2 (S), R1.1, R2.1, R4.1, R5.1; also elsewhere on the board
I2C1_SCL: IC1.14 (SCL); also elsewhere on the board
I2C1_SDA: IC1.15 (SDA); also elsewhere on the board
unnamed: D3.A, ZD1.A
unnamed: D4.A, ZD2.A
unnamed: D5.A, ZD3.A
unnamed: D6.A, ZD4.A
unnamed: IC1.1 (A0), JP1.COM
unnamed: K1.12B (S), K2.11A
unnamed: K1.A1 (C2), Q2.3 (D), R6.2, ZD2.C
unnamed: K2.A1 (C2), Q3.3 (D), R7.2, ZD3.C
unnamed: K3.A1 (C2), Q1.3 (D), R3.2, ZD1.C
unnamed: K4.A1 (C2), Q4.3 (D), R8.2, ZD4.C
unnamed: LED1.C, R3.1
unnamed: LED2.C, R6.1
unnamed: LED3.C, R7.1
unnamed: LED4.C, R8.1
PROG_RST: IC1.12 (P7); also elsewhere on the board

Notes on the sheet:
Licensed under the TAPR Open Hardware License (www.tapr.org/OHL)
Repository: https://github.com/eez-open
More info at http://www.envox.hr/eez
Power output coupling, bootloader selection
Power module inputs
Power module outputs
IN+ 7
16 OUT-
6 IN+
20-pin output power sockets
10 IN+
IN+ 9
2 OUT+
12 IN-
OUT+ 1
IN- 11
8 IN+
OUT+ 5
OUT- 19
4 OUT+
OUT- 17
20 OUT-
OUT+ 3
14 IN-
IN- 15
IN- 13
18 OUT-

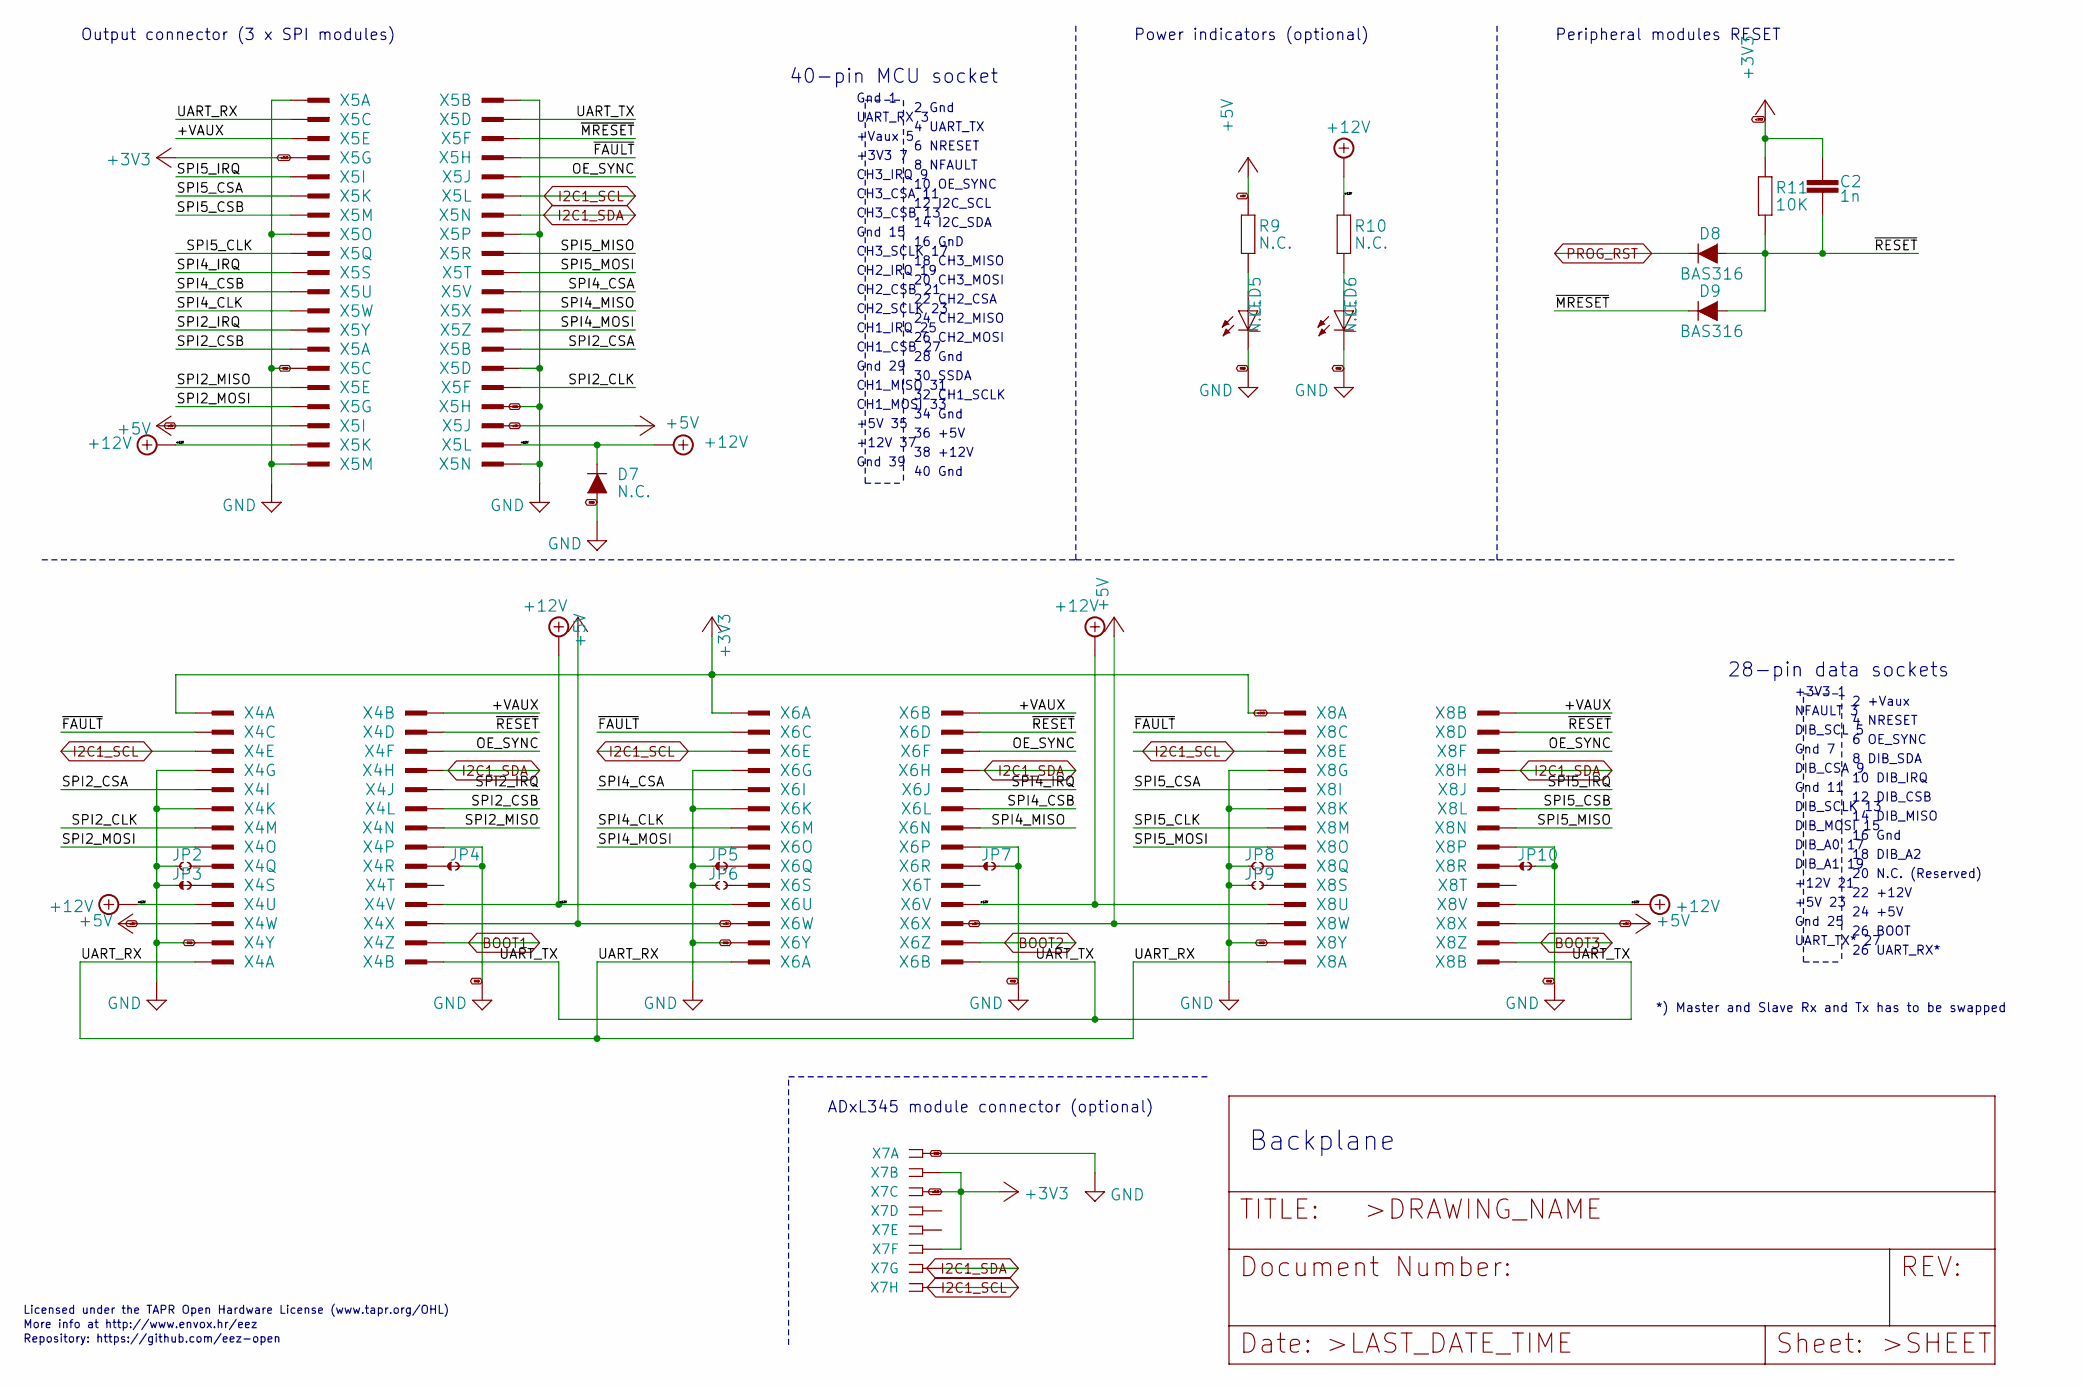
[picture p21: schematic EEZ_DIB_BP3C_r3B2_2.sch]

Parts:
C2: 1n; C0805
D7: N.C.; DO214AA
D8, D9: BAS316; SOD323-R
JP2, JP6, JP8, JP9: JP2-CUT
JP3, JP4, JP5, JP7, JP10: JP2-NOCUT
LED5, LED6: N.C.; LED_0805
R9, R10: N.C.; R0805
R11: 10K; R0805
X4, X6, X8: DS1023-2*14S21; TSW-114-07-F-D
X5: DS1022-2*20RF11; ZL212-40KG
X7: N.C.; SSW-108-02-S-S

Connections:
+3V3: C2.2, R11.1, X4.1, X5.7, X6.1, X7.2, X7.3, X7.6, X8.1; also elsewhere on the board
+5V: R9.1, X4.23, X4.24, X5.35, X5.36, X6.23, X6.24, X8.23, X8.24; also elsewhere on the board
+12V: D7.C, R10.1, X4.21, X4.22, X5.37, X5.38, X6.21, X6.22, X8.21, X8.22
/EEZ DIB BP3C r3B2_2/+VAUX: X4.2, X5.5, X6.2, X8.2
/EEZ DIB BP3C r3B2_2/OE_SYNC: X4.6, X5.10, X6.6, X8.6
/EEZ DIB BP3C r3B2_2/SPI2_CLK: X4.13, X5.32
/EEZ DIB BP3C r3B2_2/SPI2_CSA: X4.9, X5.28
/EEZ DIB BP3C r3B2_2/SPI2_CSB: X4.12, X5.27
/EEZ DIB BP3C r3B2_2/SPI2_IRQ: X4.10, X5.25
/EEZ DIB BP3C r3B2_2/SPI2_MISO: X4.14, X5.31
/EEZ DIB BP3C r3B2_2/SPI2_MOSI: X4.15, X5.33
/EEZ DIB BP3C r3B2_2/SPI4_CLK: X5.23, X6.13
/EEZ DIB BP3C r3B2_2/SPI4_CSA: X5.22, X6.9
/EEZ DIB BP3C r3B2_2/SPI4_CSB: X5.21, X6.12
/EEZ DIB BP3C r3B2_2/SPI4_IRQ: X5.19, X6.10
/EEZ DIB BP3C r3B2_2/SPI4_MISO: X5.24, X6.14
/EEZ DIB BP3C r3B2_2/SPI4_MOSI: X5.26, X6.15
/EEZ DIB BP3C r3B2_2/SPI5_CLK: X5.17, X8.13
/EEZ DIB BP3C r3B2_2/SPI5_CSA: X5.11, X8.9
/EEZ DIB BP3C r3B2_2/SPI5_CSB: X5.13, X8.12
/EEZ DIB BP3C r3B2_2/SPI5_IRQ: X5.9, X8.10
/EEZ DIB BP3C r3B2_2/SPI5_MISO: X5.18, X8.14
/EEZ DIB BP3C r3B2_2/SPI5_MOSI: X5.20, X8.15
/EEZ DIB BP3C r3B2_2/UART_RX: X4.27, X5.3, X6.27, X8.27
/EEZ DIB BP3C r3B2_2/UART_TX: X4.28, X5.4, X6.28, X8.28
/EEZ DIB BP3C r3B2_2/~FAULT: X4.3, X5.8, X6.3, X8.3
/EEZ DIB BP3C r3B2_2/~MRESET: D9.C, X5.6
/EEZ DIB BP3C r3B2_2/~RESET: C2.1, D8.A, D9.A, R11.2, X4.4, X6.4, X8.4
BOOT1: X4.26; also elsewhere on the board
BOOT2: X6.26; also elsewhere on the board
BOOT3: X8.26; also elsewhere on the board
GND: D7.A, JP2.1, JP3.1, JP4.2, JP5.1, JP6.1, JP7.2, JP8.1, JP9.1, JP10.2, LED5.C, LED6.C, X4.7, X4.11, X4.16, X4.25, X5.1, X5.2, X5.15, X5.16, X5.29, X5.30, X5.34, X5.39, X5.40, X6.7, X6.11, X6.16, X6.25, X7.1, X8.7, X8.11, X8.16, X8.25; also elsewhere on the board
I2C1_SCL: X4.5, X5.12, X6.5, X7.8, X8.5; also elsewhere on the board
I2C1_SDA: X4.8, X5.14, X6.8, X7.7, X8.8; also elsewhere on the board
unnamed: JP2.2, X4.17
unnamed: JP3.2, X4.19
unnamed: JP4.1, X4.18
unnamed: JP5.2, X6.17
unnamed: JP6.2, X6.19
unnamed: JP7.1, X6.18
unnamed: JP8.2, X8.17
unnamed: JP9.2, X8.19
unnamed: JP10.1, X8.18
unnamed: LED5.A, R9.2
unnamed: LED6.A, R10.2
PROG_RST: D8.C; also elsewhere on the board

Notes on the sheet:
Licensed under the TAPR Open Hardware License (www.tapr.org/OHL)
Repository: https://github.com/eez-open
More info at http://www.envox.hr/eez
Backplane
2 Gnd
+3V3 7
6 NRESET
8 NFAULT
10 OE_SYNC
4 UART_TX
UART_RX 3
Gnd 1
40-pin MCU socket
+Vaux 5
CH3_IRQ 9
CH3_CSB 13
12 I2C_SCL
CH3_CSA 11
14 I2C_SDA
Gnd 15
16 GnD
18 CH3_MISO
CH2_SCLK 23
22 CH2_CSA
24 CH2_MISO
26 CH2_MOSI
20 CH3_MOSI
CH2_IRQ 19
CH3_SCLK 17
CH2_CSB 21
CH1_IRQ 25
Gnd 29
28 Gnd
CH1_CSB 27
30 SSDA
CH1_MISO 31
32 CH1_SCLK
CH1_MOSI 33
+12V 37
+5V 35
Gnd 39
34 Gnd
36 +5V
38 +12V
40 Gnd
Output connector (3 x SPI modules)
Power indicators (optional)
26 BOOT
Gnd 7
22 +12V
16 Gnd
6 OE_SYNC
24 +5V
+5V 23
Gnd 25
28-pin data sockets
+12V 21
10 DIB_IRQ
DIB_CSA 9
2 +Vaux
12 DIB_CSB
+3V3 1
Gnd 11
8 DIB_SDA
DIB_SCL 5
DIB_A1 19
4 NRESET
DIB_A0 17
20 N.C. (Reserved)
NFAULT 3
14 DIB_MISO
DIB_MOSI 15
DIB_SCLK 13
18 DIB_A2
UART_TX* 27
26 UART_RX*
*) Master and Slave Rx and Tx has to be swapped
Peripheral modules RESET
ADxL345 module connector (optional)

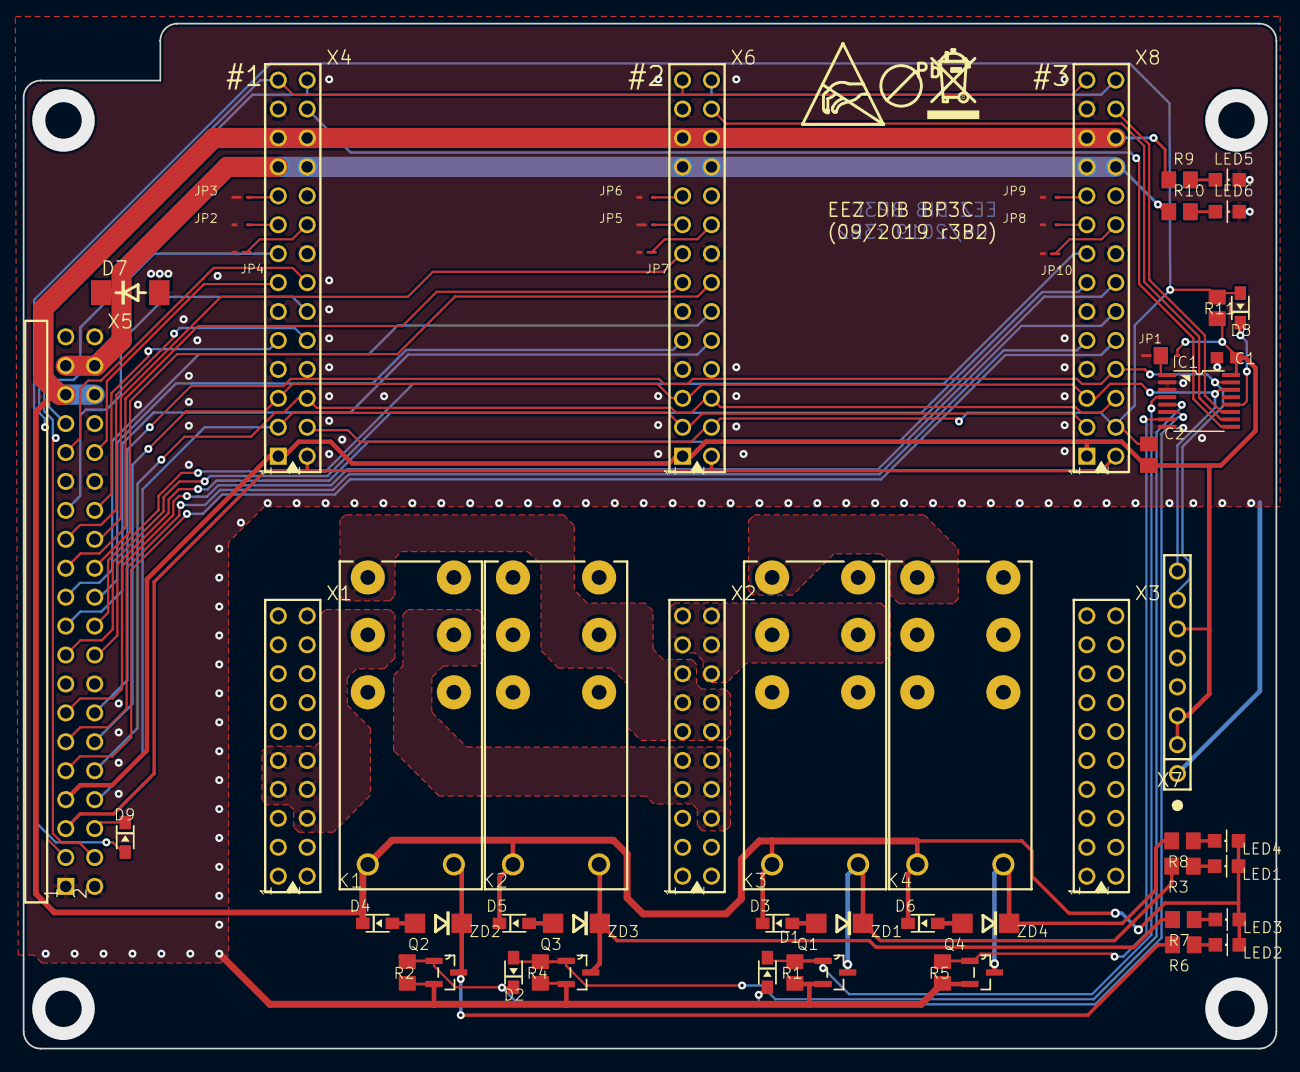
[picture p22: board EEZ DIB BP3C r3B2.kicad_pcb from above]

Board: 2 copper layers, 110.0 x 90.0 mm, 63 parts (0 on the bottom side), 73 nets.

Other parts of the board:
EEZ_SIGNATURE: SIGNATURESMALL; SIGNATURE_5MM
U$2: RECYCLE_BIN1_8
U$4: ESD_SYMBOL
U$5: PB_SMALL
