goran-mahovlic/modular-psu/mcu/KiCad_new/r2B1/EEZ DIB MCU r2B1.kicad_pcb

## KiCad design mcu/KiCad_new/r2B1/EEZ DIB MCU r2B1.kicad_pcb (2020-01-06)

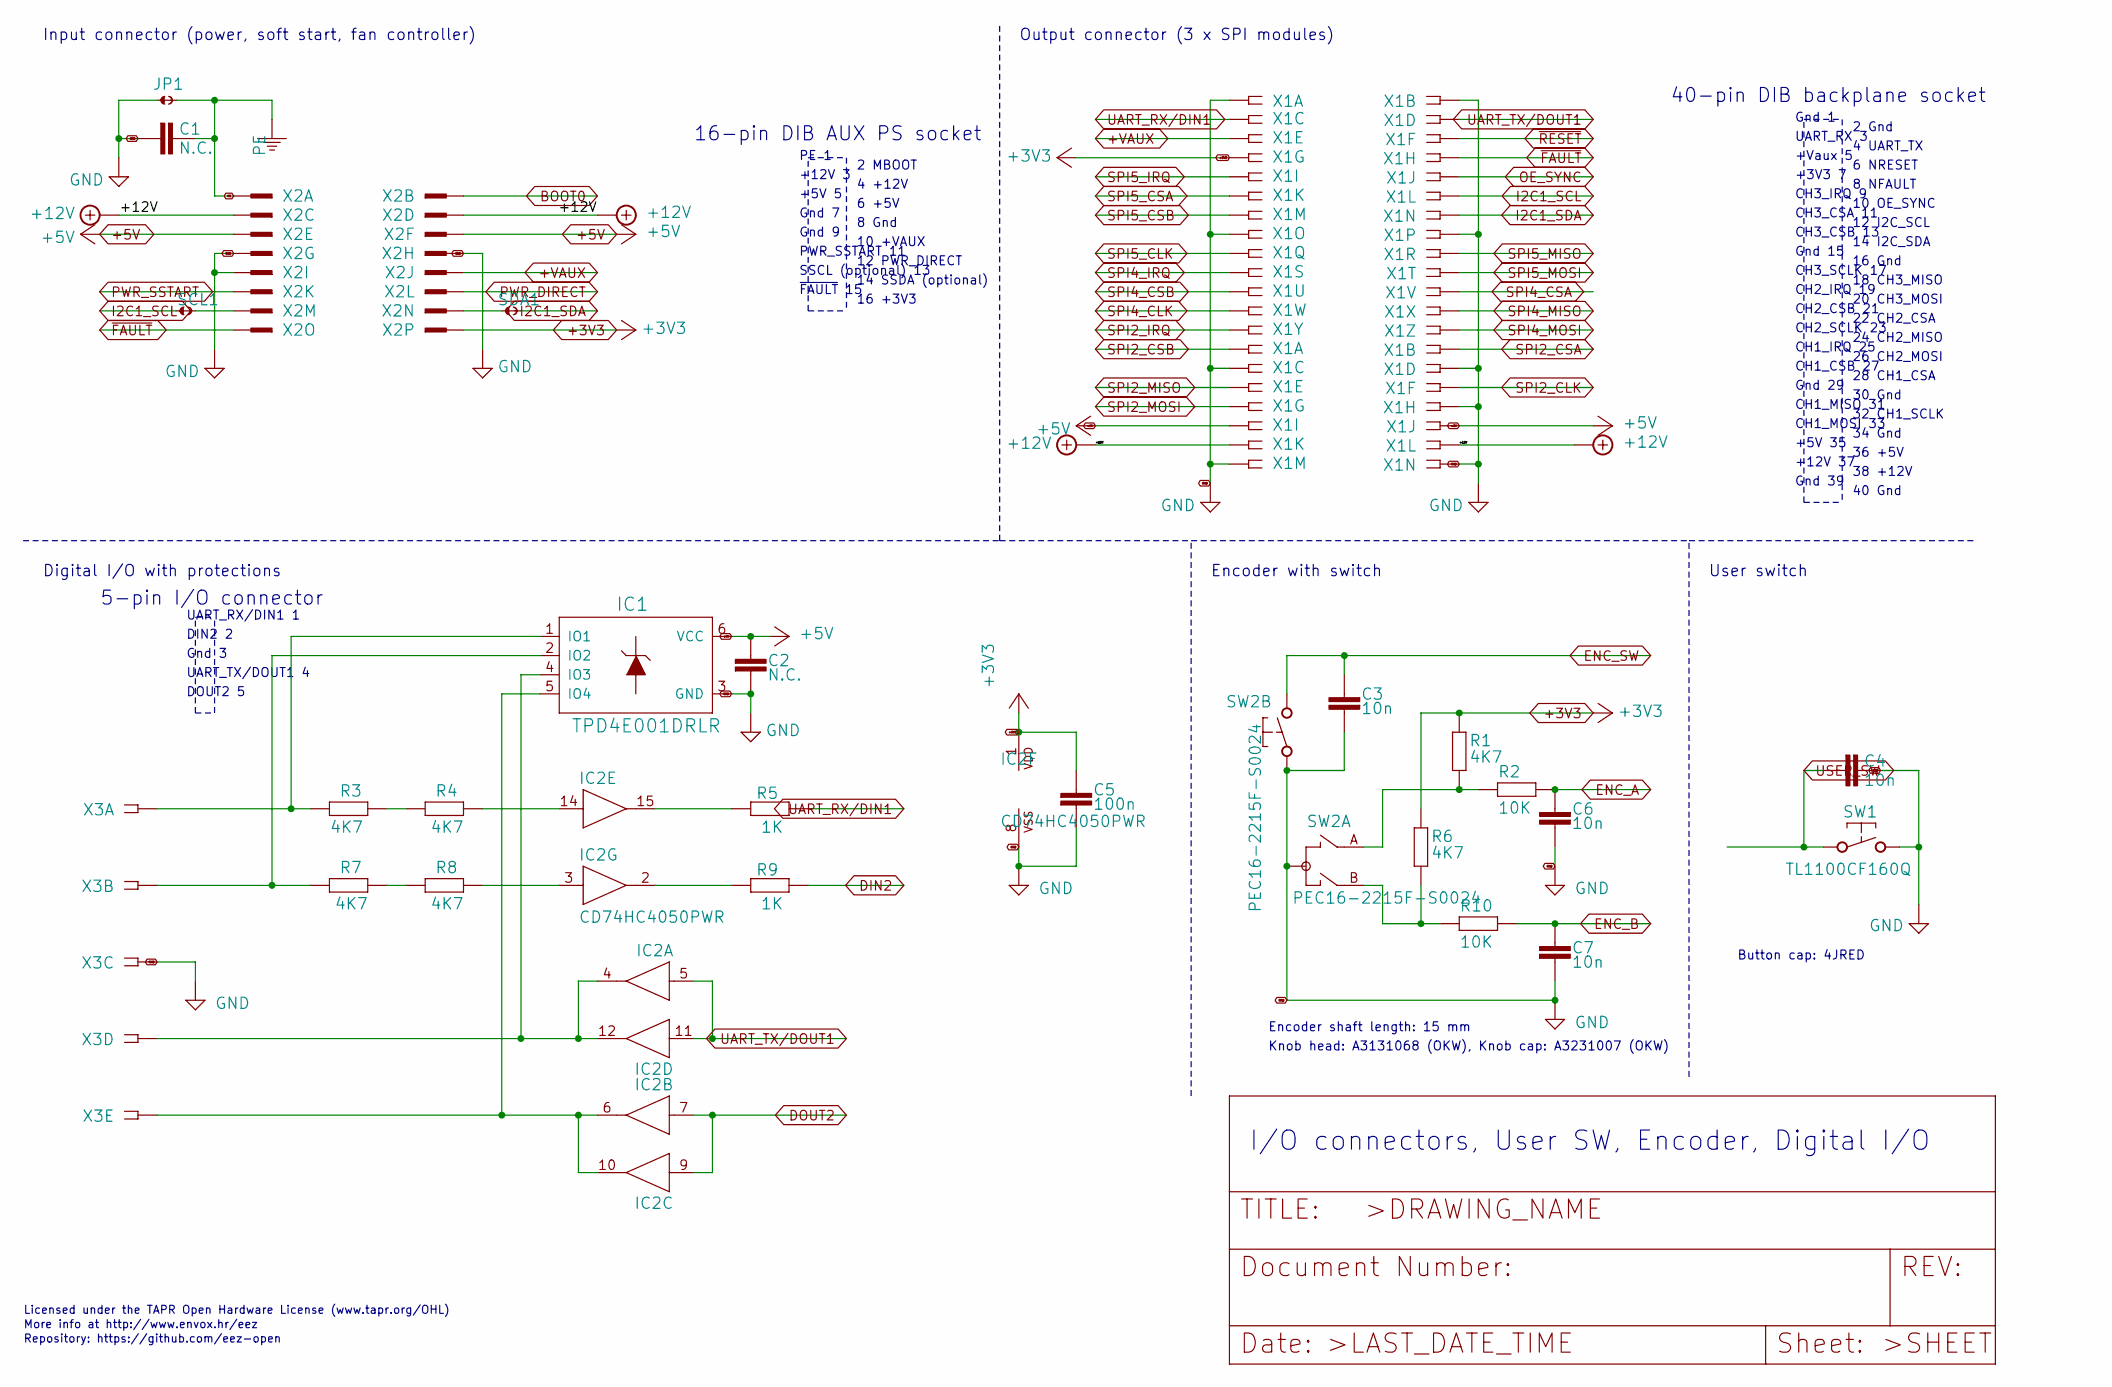
[picture p23: schematic I%2fO_connectors,_Encoder,_user_SW.sch]

Parts:
C1: N.C.; C0805
C2: N.C.; C0603
C3, C4, C6, C7: 10n; C0805
C5: 100n; C0603
IC1: TPD4E001DRLR; DRL6
IC2: CD74HC4050PWR; PW16
JP1: JP2-NOCUT
R1, R3, R4, R6, R7, R8: 4K7; R0805
R2, R10: 10K; R0805
R5, R9: 1K; R0805
SCL: JP2-NOCUT
SDA: JP2-NOCUT
SW1: TL1100CF160Q; TL1100C
SW2: PEC16-2215F-S0024; PEC16-2215F
X1: DS1024-2*20R0; ZL263-40DG
X2: DS1013-16SSIB1; IDC-16PIN
X3: 691322110005; MC1,5_5-G-3,5

Connections:
+3V3: C5.1, IC2.1 (VDD), R1.1, R6.1, X1.7, X2.16; also elsewhere on the board
+5V: C2.1, IC1.6 (VCC), X1.35, X1.36, X2.5, X2.6; also elsewhere on the board
+12V: X1.37, X1.38, X2.3, X2.4
+VAUX: X1.5, X2.10; also elsewhere on the board
BOOT0: X2.2; also elsewhere on the board
DIN2: R9.2; also elsewhere on the board
DOUT2: IC2.7 (I), IC2.9 (I); also elsewhere on the board
ENC_A: C6.2, R2.1; also elsewhere on the board
ENC_B: C7.1, R10.1; also elsewhere on the board
ENC_SW: C3.2, SW2.E (2); also elsewhere on the board
GND: C1.2, C2.2, C3.1, C4.1, C5.2, C6.1, C7.2, IC1.3 (GND), IC2.8 (VSS), JP1.1, SW1.2, SW2.C, SW2.D (1), SW2.GND1 (C), SW2.GND2 (C), X1.1, X1.2, X1.15, X1.16, X1.29, X1.30, X1.34, X1.39, X1.40, X2.7, X2.8, X2.9, X3.3; also elsewhere on the board
I2C1_SCL: X1.12; also elsewhere on the board
I2C1_SDA: X1.14; also elsewhere on the board
unnamed: IC1.1 (IO1), R3.1, X3.1
unnamed: IC1.2 (IO2), R7.1, X3.2
unnamed: IC1.4 (IO3), IC2.4 (O), IC2.12 (O), X3.4
unnamed: IC1.5 (IO4), IC2.6 (O), IC2.10 (O), X3.5
unnamed: IC2.2 (O), R9.1
unnamed: IC2.3 (I), R8.2
unnamed: IC2.14 (I), R4.2
unnamed: IC2.15 (O), R5.1
unnamed: R1.2, R2.2, SW2.A
unnamed: R3.2, R4.1
unnamed: R7.2, R8.1
unnamed: R6.2, R10.2, SW2.B
unnamed 199: X2.13; also elsewhere on the board
unnamed 200: X2.14; also elsewhere on the board
OE_SYNC: X1.10; also elsewhere on the board
PE: C1.1, JP1.2, X2.1; also elsewhere on the board
PWR_DIRECT: X2.12; also elsewhere on the board
PWR_SSTART: X2.11; also elsewhere on the board
SPI2_CLK: X1.32; also elsewhere on the board
SPI2_CSA: X1.28; also elsewhere on the board
SPI2_CSB: X1.27; also elsewhere on the board
SPI2_IRQ: X1.25; also elsewhere on the board
SPI2_MISO: X1.31; also elsewhere on the board
SPI2_MOSI: X1.33; also elsewhere on the board
SPI4_CLK: X1.23; also elsewhere on the board
SPI4_CSA: X1.22; also elsewhere on the board
SPI4_CSB: X1.21; also elsewhere on the board
SPI4_IRQ: X1.19; also elsewhere on the board
SPI4_MISO: X1.24; also elsewhere on the board
SPI4_MOSI: X1.26; also elsewhere on the board
SPI5_CLK: X1.17; also elsewhere on the board
SPI5_CSA: X1.11; also elsewhere on the board
SPI5_CSB: X1.13; also elsewhere on the board
SPI5_IRQ: X1.9; also elsewhere on the board
SPI5_MISO: X1.18; also elsewhere on the board
SPI5_MOSI: X1.20; also elsewhere on the board
UART_RX/DIN1: R5.2, X1.3; also elsewhere on the board
UART_TX/DOUT1: IC2.5 (I), IC2.11 (I), X1.4; also elsewhere on the board
USER_SW: C4.2, SW1.1; also elsewhere on the board
~FAULT: X1.8, X2.15; also elsewhere on the board
~RESET: X1.6; also elsewhere on the board

Notes on the sheet:
Licensed under the TAPR Open Hardware License (www.tapr.org/OHL)
Repository: https://github.com/eez-open
More info at http://www.envox.hr/eez
Encoder shaft length: 15 mm
Knob head: A3131068 (OKW), Knob cap: A3231007 (OKW)
I/O connectors, User SW, Encoder, Digital I/O
2 MBOOT
Gnd 7
6 +5V
8 Gnd
10 +VAUX
4 +12V
+12V 3
PE 1
16-pin DIB AUX PS socket
+5V 5
Gnd 9
SSCL (optional) 13
12 PWR_DIRECT
PWR_SSTART 11
14 SSDA (optional)
~FAULT~ 15
16 +3V3
Digital I/O with protections
Encoder with switch
User switch
Input connector (power, soft start, fan controller)
Output connector (3 x SPI modules)
Button cap: 4JRED
2 Gnd
+3V3 7
6 NRESET
8 NFAULT
10 OE_SYNC
4 UART_TX
UART_RX 3
Gnd 1
40-pin DIB backplane socket
+Vaux 5
CH3_IRQ 9
CH3_CSB 13
12 I2C_SCL
CH3_CSA 11
14 I2C_SDA
Gnd 15
16 Gnd
18 CH3_MISO
CH2_SCLK 23
22 CH2_CSA
24 CH2_MISO
26 CH2_MOSI
20 CH3_MOSI
CH2_IRQ 19
CH3_SCLK 17
CH2_CSB 21
CH1_IRQ 25
Gnd 29
28 CH1_CSA
CH1_CSB 27
30 Gnd
CH1_MISO 31
32 CH1_SCLK
CH1_MOSI 33
+12V 37
+5V 35
Gnd 39
34 Gnd
36 +5V
38 +12V
40 Gnd
UART_TX/DOUT1 4
DIN2 2
UART_RX/DIN1 1
5-pin I/O connector
Gnd 3
DOUT2 5

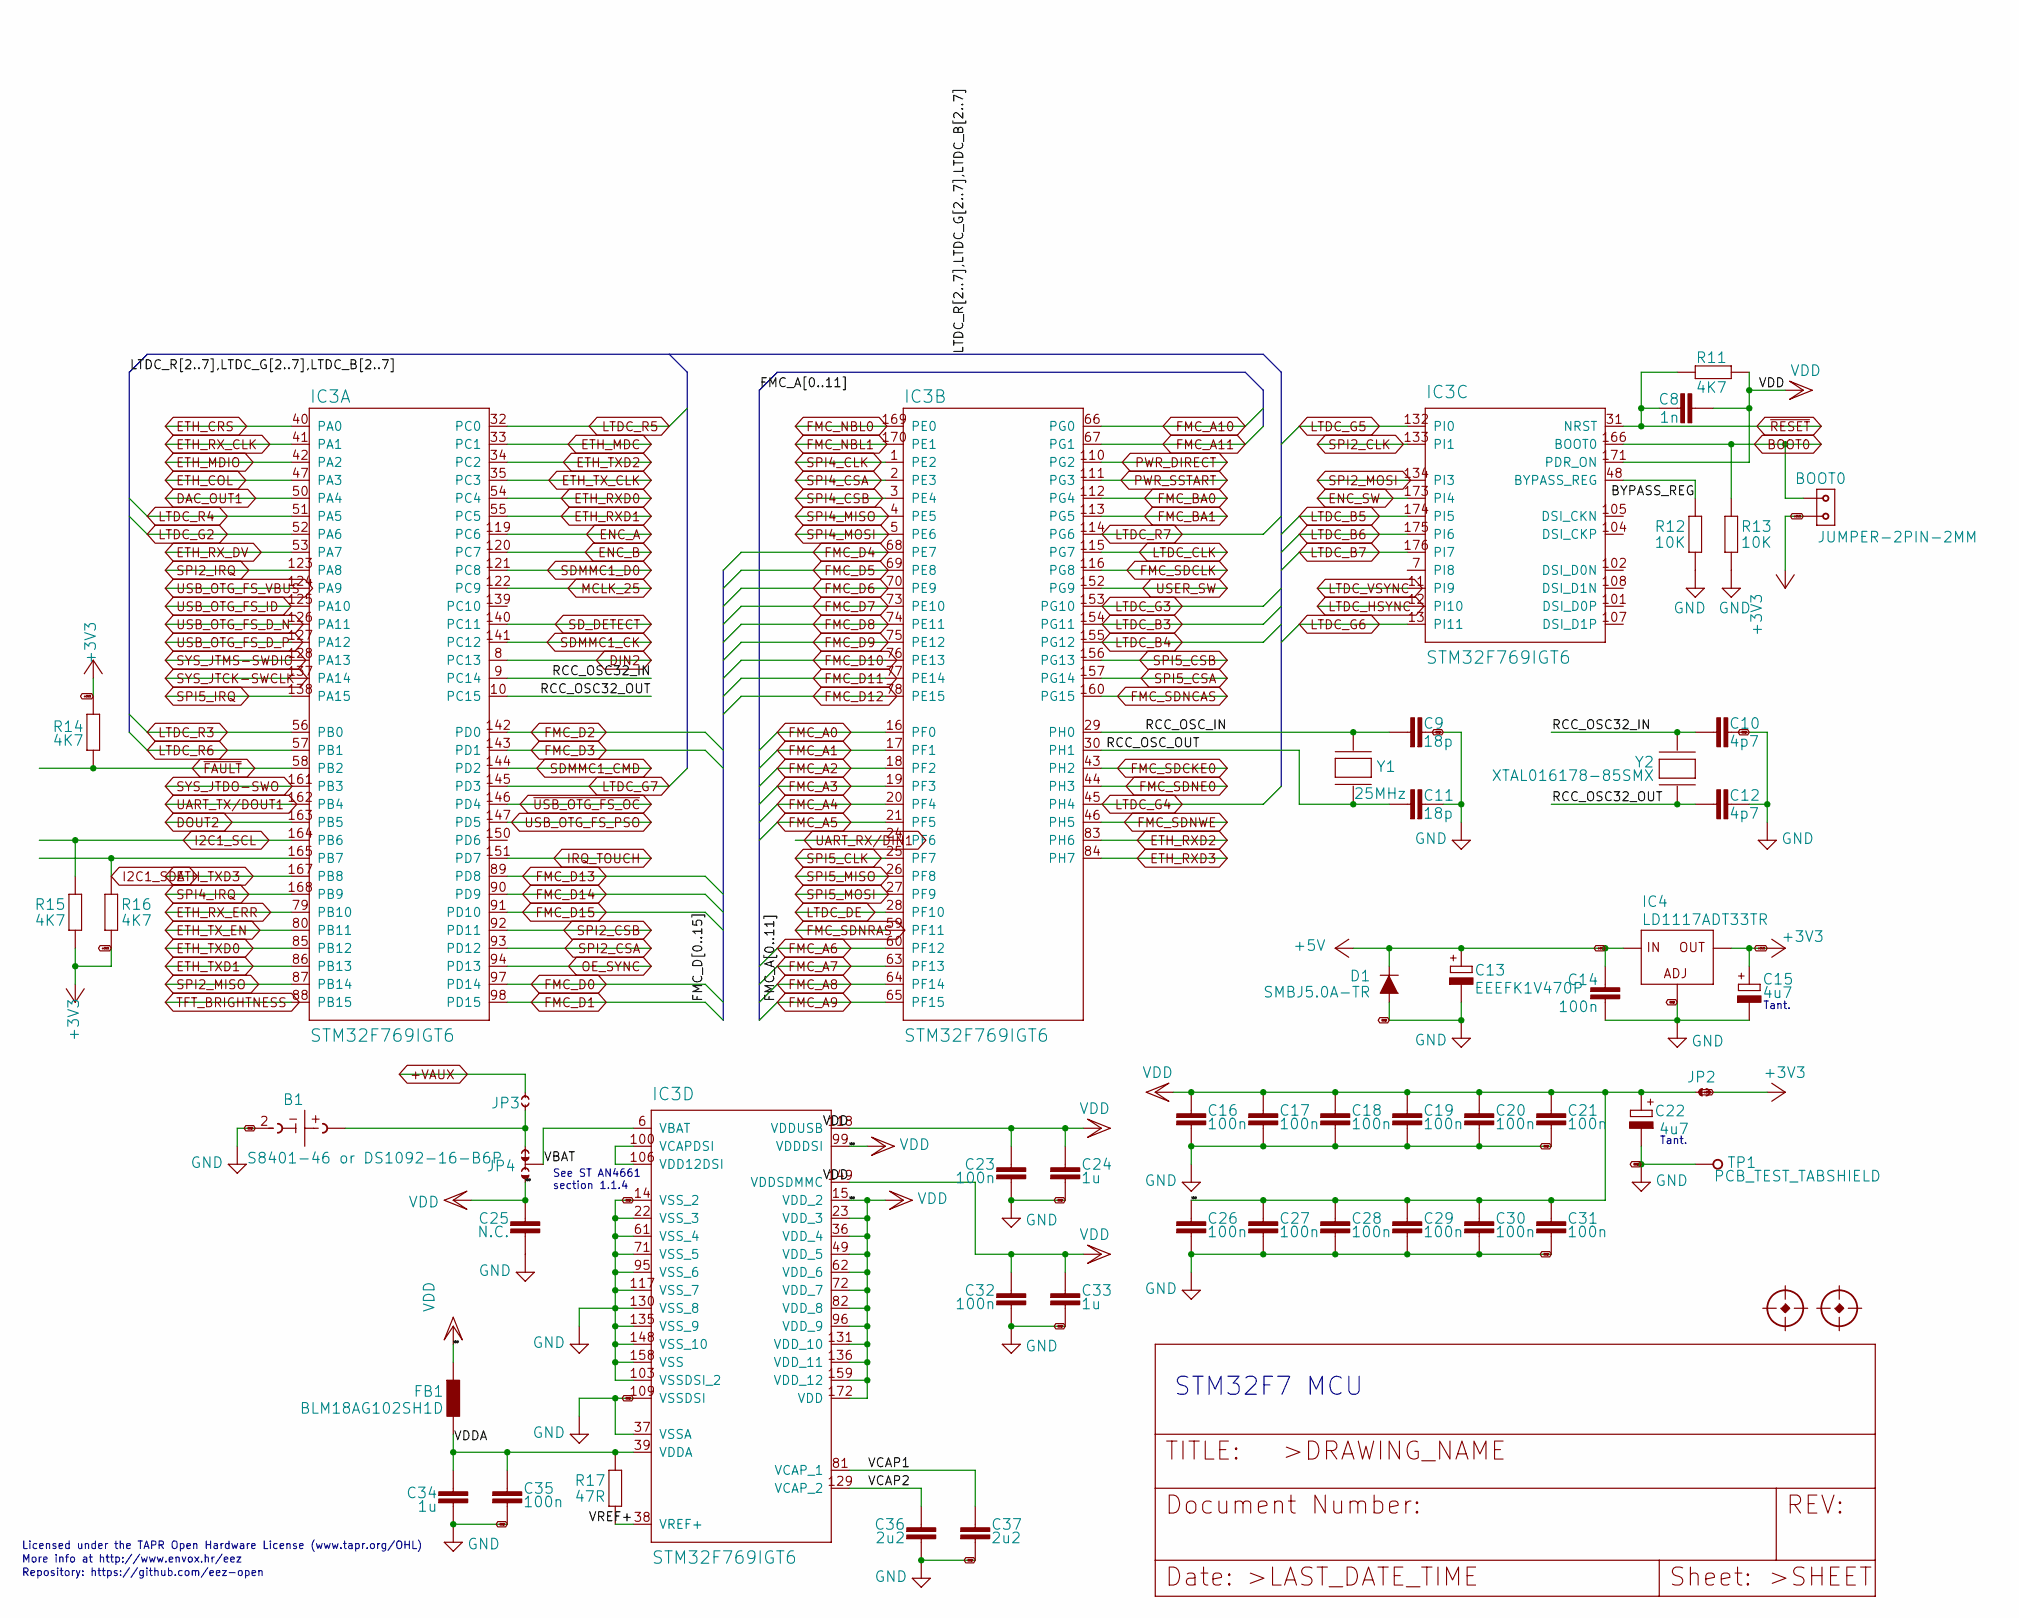
[picture p24: schematic STM32F7_MCU.sch]

Parts:
B1: S8401-46 or DS1092-16-B6P; S8401-46
BOOT0: JUMPER-2PIN-2MM; 2MM-2
C8: 1n; C0805
C9, C11: 18p; C0603
C10, C12: 4p7; C0603
C13: EEEFK1V470P; CAPAE660X610N
C14, C16, C17, C18, C19, C20, C21, C23, C26, C27, C28, C29, C30, C31, C32, C35: 100n; C0603
C15, C22: 4u7; EC1206
C24, C33, C34: 1u; C0805
C25: N.C.; C0603
C36, C37: 2u2; C0805
D1: SMBJ5.0A-TR; DO214AA
FB1: BLM18AG102SH1D; BEAD0603
FM1, FM2: FIDUCIAL
IC3: STM32F769IGT6; LQFP-176_24X24MM
IC4: LD1117ADT33TR; DPACK
JP2: JP2-NOCUT
JP3: JP2-CUT
JP4: JP3-CUT
R11, R14, R15, R16: 4K7; R0805
R12, R13: 10K; R0805
R17: 47R; R0805
TP1: PCB_TEST_TABSHIELD; PCB_SHIELD_TAB
Y1: 25MHz; HC-49_4H
Y2: XTAL016178-85SMX; 85SMX

Connections:
+3V3: BOOT0.2, C15.+, IC4.4 (OUT), JP2.2, R14.1, R15.1, R16.1; also elsewhere on the board
+5V: C13.1 (+), C14.1, D1.C, IC4.3 (IN); also elsewhere on the board
+VAUX: JP3.2; also elsewhere on the board
/STM32F7 MCU/BYPASS_REG: IC3.48 (BYPASS_REG), R12.2
/STM32F7 MCU/RCC_OSC32_IN: C10.1, IC3.9 (PC14), Y2.1
/STM32F7 MCU/RCC_OSC32_OUT: C12.1, IC3.10 (PC15), Y2.4 (2)
/STM32F7 MCU/RCC_OSC_IN: C9.2, IC3.29 (PH0), Y1.2
/STM32F7 MCU/RCC_OSC_OUT: C11.2, IC3.30 (PH1), Y1.1
/STM32F7 MCU/VBAT: IC3.6 (VBAT), JP4.COM
/STM32F7 MCU/VCAP1: C37.1, IC3.81 (VCAP_1)
/STM32F7 MCU/VCAP2: C36.1, IC3.129 (VCAP_2)
/STM32F7 MCU/VDDA: C34.1, C35.1, FB1.P$2 (2), IC3.39 (VDDA), R17.2
/STM32F7 MCU/VREF+: IC3.38 (VREF+), R17.1
BOOT0: BOOT0.1, IC3.166 (BOOT0), R13.2; also elsewhere on the board
DAC_OUT1: IC3.50 (PA4); also elsewhere on the board
DIN2: IC3.8 (PC13); also elsewhere on the board
DOUT2: IC3.163 (PB5); also elsewhere on the board
ENC_A: IC3.119 (PC6); also elsewhere on the board
ENC_B: IC3.120 (PC7); also elsewhere on the board
ENC_SW: IC3.173 (PI4); also elsewhere on the board
ETH_COL: IC3.47 (PA3); also elsewhere on the board
ETH_CRS: IC3.40 (PA0); also elsewhere on the board
ETH_MDC: IC3.33 (PC1); also elsewhere on the board
ETH_MDIO: IC3.42 (PA2); also elsewhere on the board
ETH_RXD0: IC3.54 (PC4); also elsewhere on the board
ETH_RXD1: IC3.55 (PC5); also elsewhere on the board
ETH_RXD2: IC3.83 (PH6); also elsewhere on the board
ETH_RXD3: IC3.84 (PH7); also elsewhere on the board
ETH_RX_CLK: IC3.41 (PA1); also elsewhere on the board
ETH_RX_DV: IC3.53 (PA7); also elsewhere on the board
ETH_RX_ERR: IC3.79 (PB10); also elsewhere on the board
ETH_TXD0: IC3.85 (PB12); also elsewhere on the board
ETH_TXD1: IC3.86 (PB13); also elsewhere on the board
ETH_TXD2: IC3.34 (PC2); also elsewhere on the board
ETH_TXD3: IC3.167 (PB8); also elsewhere on the board
ETH_TX_CLK: IC3.35 (PC3); also elsewhere on the board
ETH_TX_EN: IC3.80 (PB11); also elsewhere on the board
FMC_A0: IC3.16 (PF0); also elsewhere on the board
FMC_A1: IC3.17 (PF1); also elsewhere on the board
FMC_A2: IC3.18 (PF2); also elsewhere on the board
FMC_A3: IC3.19 (PF3); also elsewhere on the board
FMC_A4: IC3.20 (PF4); also elsewhere on the board
FMC_A5: IC3.21 (PF5); also elsewhere on the board
FMC_A6: IC3.60 (PF12); also elsewhere on the board
FMC_A7: IC3.63 (PF13); also elsewhere on the board
FMC_A8: IC3.64 (PF14); also elsewhere on the board
FMC_A9: IC3.65 (PF15); also elsewhere on the board
FMC_A10: IC3.66 (PG0); also elsewhere on the board
FMC_A11: IC3.67 (PG1); also elsewhere on the board
FMC_BA0: IC3.112 (PG4); also elsewhere on the board
FMC_BA1: IC3.113 (PG5); also elsewhere on the board
FMC_D0: IC3.97 (PD14); also elsewhere on the board
FMC_D1: IC3.98 (PD15); also elsewhere on the board
FMC_D2: IC3.142 (PD0); also elsewhere on the board
FMC_D3: IC3.143 (PD1); also elsewhere on the board
FMC_D4: IC3.68 (PE7); also elsewhere on the board
FMC_D5: IC3.69 (PE8); also elsewhere on the board
FMC_D6: IC3.70 (PE9); also elsewhere on the board
FMC_D7: IC3.73 (PE10); also elsewhere on the board
FMC_D8: IC3.74 (PE11); also elsewhere on the board
FMC_D9: IC3.75 (PE12); also elsewhere on the board
FMC_D10: IC3.76 (PE13); also elsewhere on the board
FMC_D11: IC3.77 (PE14); also elsewhere on the board
FMC_D12: IC3.78 (PE15); also elsewhere on the board
FMC_D13: IC3.89 (PD8); also elsewhere on the board
FMC_D14: IC3.90 (PD9); also elsewhere on the board
FMC_D15: IC3.91 (PD10); also elsewhere on the board
FMC_NBL0: IC3.169 (PE0); also elsewhere on the board
FMC_NBL1: IC3.170 (PE1); also elsewhere on the board
FMC_SDCKE0: IC3.43 (PH2); also elsewhere on the board
FMC_SDCLK: IC3.116 (PG8); also elsewhere on the board
FMC_SDNCAS: IC3.160 (PG15); also elsewhere on the board
FMC_SDNE0: IC3.44 (PH3); also elsewhere on the board
FMC_SDNRAS: IC3.59 (PF11); also elsewhere on the board
FMC_SDNWE: IC3.46 (PH5); also elsewhere on the board
GND: B1.2 (-), C9.1, C10.2, C11.1, C12.2, C13.2 (-), C14.2, C15.-, C16.2, C17.2, C18.2, C19.2, C20.2, C21.2, C22.-, C23.2, C24.2, C25.2, C26.2, C27.2, C28.2, C29.2, C30.2, C31.2, C32.2, C33.2, C34.2, C35.2, C36.2, C37.2, D1.A, IC3.14 (VSS_2), IC3.22 (VSS_3), IC3.37 (VSSA), IC3.61 (VSS_4), IC3.71 (VSS_5), IC3.95 (VSS_6), IC3.103 (VSSDSI_2), IC3.109 (VSSDSI), IC3.117 (VSS_7), IC3.130 (VSS_8), IC3.135 (VSS_9), IC3.148 (VSS_10), IC3.158 (VSS), IC4.1 (ADJ), R12.1, R13.1, TP1.1; also elsewhere on the board
I2C1_SCL: IC3.164 (PB6), R15.2; also elsewhere on the board
I2C1_SDA: IC3.165 (PB7), R16.2; also elsewhere on the board
IRQ_TOUCH: IC3.151 (PD7); also elsewhere on the board
LTDC_B3: IC3.154 (PG11); also elsewhere on the board
LTDC_B4: IC3.155 (PG12); also elsewhere on the board
LTDC_B5: IC3.174 (PI5); also elsewhere on the board
LTDC_B6: IC3.175 (PI6); also elsewhere on the board
LTDC_B7: IC3.176 (PI7); also elsewhere on the board
LTDC_CLK: IC3.115 (PG7); also elsewhere on the board
LTDC_DE: IC3.28 (PF10); also elsewhere on the board
LTDC_G2: IC3.52 (PA6); also elsewhere on the board
LTDC_G3: IC3.153 (PG10); also elsewhere on the board
LTDC_G4: IC3.45 (PH4); also elsewhere on the board
LTDC_G5: IC3.132 (PI0); also elsewhere on the board
LTDC_G6: IC3.13 (PI11); also elsewhere on the board
LTDC_G7: IC3.145 (PD3); also elsewhere on the board
LTDC_HSYNC: IC3.12 (PI10); also elsewhere on the board
LTDC_R3: IC3.56 (PB0); also elsewhere on the board
LTDC_R4: IC3.51 (PA5); also elsewhere on the board
LTDC_R5: IC3.32 (PC0); also elsewhere on the board
LTDC_R6: IC3.57 (PB1); also elsewhere on the board
LTDC_R7: IC3.114 (PG6); also elsewhere on the board
LTDC_VSYNC: IC3.11 (PI9); also elsewhere on the board
MCLK_25: IC3.122 (PC9); also elsewhere on the board
unnamed: B1.1 (+), B1.3 (+), JP3.1, JP4.NC
unnamed: IC3.100 (VCAPDSI), IC3.106 (VDD12DSI)
OE_SYNC: IC3.94 (PD13); also elsewhere on the board
PWR_DIRECT: IC3.110 (PG2); also elsewhere on the board
PWR_SSTART: IC3.111 (PG3); also elsewhere on the board
SDMMC1_CK: IC3.141 (PC12); also elsewhere on the board
SDMMC1_CMD: IC3.144 (PD2); also elsewhere on the board
SDMMC1_D0: IC3.121 (PC8); also elsewhere on the board
SD_DETECT: IC3.140 (PC11); also elsewhere on the board
SPI2_CLK: IC3.133 (PI1); also elsewhere on the board
SPI2_CSA: IC3.93 (PD12); also elsewhere on the board
SPI2_CSB: IC3.92 (PD11); also elsewhere on the board
SPI2_IRQ: IC3.123 (PA8); also elsewhere on the board
SPI2_MISO: IC3.87 (PB14); also elsewhere on the board
SPI2_MOSI: IC3.134 (PI3); also elsewhere on the board
SPI4_CLK: IC3.1 (PE2); also elsewhere on the board
SPI4_CSA: IC3.2 (PE3); also elsewhere on the board
SPI4_CSB: IC3.3 (PE4); also elsewhere on the board
SPI4_IRQ: IC3.168 (PB9); also elsewhere on the board
SPI4_MISO: IC3.4 (PE5); also elsewhere on the board
SPI4_MOSI: IC3.5 (PE6); also elsewhere on the board
SPI5_CLK: IC3.25 (PF7); also elsewhere on the board
SPI5_CSA: IC3.157 (PG14); also elsewhere on the board
SPI5_CSB: IC3.156 (PG13); also elsewhere on the board
SPI5_IRQ: IC3.138 (PA15); also elsewhere on the board
SPI5_MISO: IC3.26 (PF8); also elsewhere on the board
SPI5_MOSI: IC3.27 (PF9); also elsewhere on the board
SYS_JTCK-SWCLK: IC3.137 (PA14); also elsewhere on the board
SYS_JTDO-SWO: IC3.161 (PB3); also elsewhere on the board
SYS_JTMS-SWDIO: IC3.128 (PA13); also elsewhere on the board
TFT_BRIGHTNESS: IC3.88 (PB15); also elsewhere on the board
UART_RX/DIN1: IC3.24 (PF6); also elsewhere on the board
UART_TX/DOUT1: IC3.162 (PB4); also elsewhere on the board
USB_OTG_FS_D_N: IC3.126 (PA11); also elsewhere on the board
USB_OTG_FS_D_P: IC3.127 (PA12); also elsewhere on the board
USB_OTG_FS_ID: IC3.125 (PA10); also elsewhere on the board
USB_OTG_FS_PSO: IC3.147 (PD5); also elsewhere on the board
USB_OTG_FS_VBUS: IC3.124 (PA9); also elsewhere on the board
USER_SW: IC3.152 (PG9); also elsewhere on the board
VDD: C8.2, C16.1, C17.1, C18.1, C19.1, C20.1, C21.1, C22.+, C23.1, C24.1, C25.1, C26.1, C27.1, C28.1, C29.1, C30.1, C31.1, C32.1, C33.1, FB1.P$1 (1), IC3.15 (VDD_2), IC3.23 (VDD_3), IC3.36 (VDD_4), IC3.49 (VDD_5), IC3.62 (VDD_6), IC3.72 (VDD_7), IC3.82 (VDD_8), IC3.96 (VDD_9), IC3.99 (VDDDSI), IC3.118 (VDDUSB), IC3.131 (VDD_10), IC3.136 (VDD_11), IC3.149 (VDDSDMMC), IC3.159 (VDD_12), IC3.171 (PDR_ON), IC3.172 (VDD), JP2.1, JP4.NO, R11.1
~FAULT: IC3.58 (PB2), R14.2; also elsewhere on the board
~RESET: C8.1, IC3.31 (NRST), R11.2; also elsewhere on the board
~USB_OTG_FS_OC: IC3.146 (PD4); also elsewhere on the board

Notes on the sheet:
Licensed under the TAPR Open Hardware License (www.tapr.org/OHL)
Repository: https://github.com/eez-open
More info at http://www.envox.hr/eez
Tant.
See ST AN4661 section 1.1.4
STM32F7 MCU

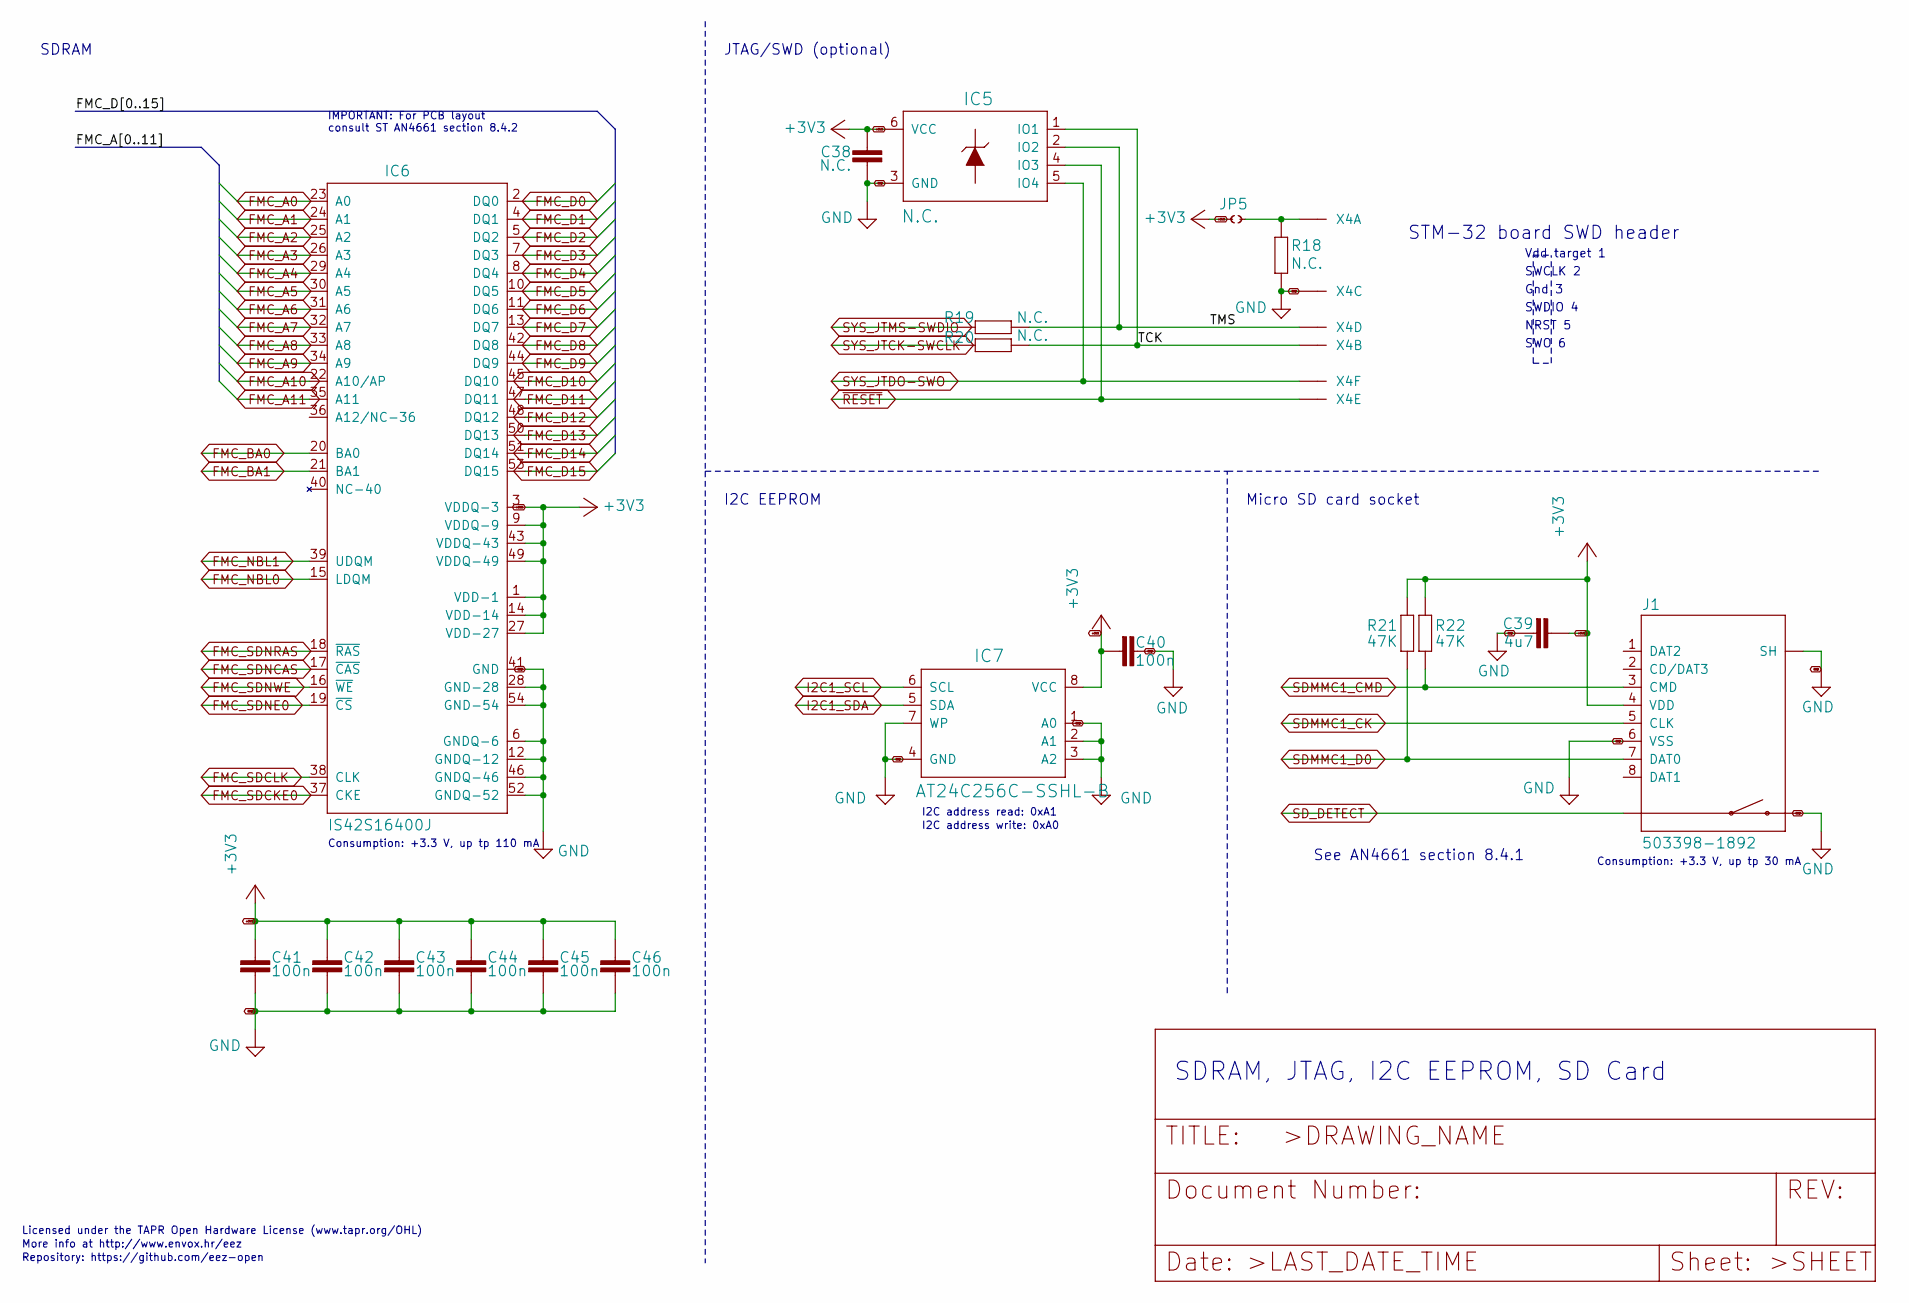
[picture p25: schematic SDRAM,_JTAG,_SD_card,_EEPROM.sch]

Parts:
C38: N.C.; C0603
C39: 4u7; C1206
C40, C41, C42, C43, C44, C45, C46: 100n; C0603
IC5: N.C.; DRL6
IC6: IS42S16400J; TSOPII-54
IC7: AT24C256C-SSHL-B; SOIC127P600X173-8N
J1: 503398-1892; 5033981892
JP5: JP2-CUT
R18, R19, R20: N.C.; R0805
R21, R22: 47K; R0805
X4: N.C.; 22-23-2061

Connections:
+3V3: C38.1, C39.1, C40.2, C41.1, C42.1, C43.1, C44.1, C45.1, C46.1, IC5.6 (VCC), IC6.1 (VDD-1), IC6.3 (VDDQ-3), IC6.9 (VDDQ-9), IC6.14 (VDD-14), IC6.27 (VDD-27), IC6.43 (VDDQ-43), IC6.49 (VDDQ-49), IC7.8 (VCC), J1.4 (VDD), JP5.1, R21.1, R22.1; also elsewhere on the board
/SDRAM, JTAG, SD card, EEPROM/TCK: IC5.1 (IO1), R20.2, X4.2
/SDRAM, JTAG, SD card, EEPROM/TMS: IC5.2 (IO2), R19.2, X4.4
FMC_A0: IC6.23 (A0); also elsewhere on the board
FMC_A1: IC6.24 (A1); also elsewhere on the board
FMC_A2: IC6.25 (A2); also elsewhere on the board
FMC_A3: IC6.26 (A3); also elsewhere on the board
FMC_A4: IC6.29 (A4); also elsewhere on the board
FMC_A5: IC6.30 (A5); also elsewhere on the board
FMC_A6: IC6.31 (A6); also elsewhere on the board
FMC_A7: IC6.32 (A7); also elsewhere on the board
FMC_A8: IC6.33 (A8); also elsewhere on the board
FMC_A9: IC6.34 (A9); also elsewhere on the board
FMC_A10: IC6.22 (A10/AP); also elsewhere on the board
FMC_A11: IC6.35 (A11); also elsewhere on the board
FMC_BA0: IC6.20 (BA0); also elsewhere on the board
FMC_BA1: IC6.21 (BA1); also elsewhere on the board
FMC_D0: IC6.2 (DQ0); also elsewhere on the board
FMC_D1: IC6.4 (DQ1); also elsewhere on the board
FMC_D2: IC6.5 (DQ2); also elsewhere on the board
FMC_D3: IC6.7 (DQ3); also elsewhere on the board
FMC_D4: IC6.8 (DQ4); also elsewhere on the board
FMC_D5: IC6.10 (DQ5); also elsewhere on the board
FMC_D6: IC6.11 (DQ6); also elsewhere on the board
FMC_D7: IC6.13 (DQ7); also elsewhere on the board
FMC_D8: IC6.42 (DQ8); also elsewhere on the board
FMC_D9: IC6.44 (DQ9); also elsewhere on the board
FMC_D10: IC6.45 (DQ10); also elsewhere on the board
FMC_D11: IC6.47 (DQ11); also elsewhere on the board
FMC_D12: IC6.48 (DQ12); also elsewhere on the board
FMC_D13: IC6.50 (DQ13); also elsewhere on the board
FMC_D14: IC6.51 (DQ14); also elsewhere on the board
FMC_D15: IC6.53 (DQ15); also elsewhere on the board
FMC_NBL0: IC6.15 (LDQM); also elsewhere on the board
FMC_NBL1: IC6.39 (UDQM); also elsewhere on the board
FMC_SDCKE0: IC6.37 (CKE); also elsewhere on the board
FMC_SDCLK: IC6.38 (CLK); also elsewhere on the board
FMC_SDNCAS: IC6.17 (~CAS); also elsewhere on the board
FMC_SDNE0: IC6.19 (~CS); also elsewhere on the board
FMC_SDNRAS: IC6.18 (~RAS); also elsewhere on the board
FMC_SDNWE: IC6.16 (~WE); also elsewhere on the board
GND: C38.2, C39.2, C40.1, C41.2, C42.2, C43.2, C44.2, C45.2, C46.2, IC5.3 (GND), IC6.6 (GNDQ-6), IC6.12 (GNDQ-12), IC6.28 (GND-28), IC6.41 (GND), IC6.46 (GNDQ-46), IC6.52 (GNDQ-52), IC6.54 (GND-54), IC7.1 (A0), IC7.2 (A1), IC7.3 (A2), IC7.4 (GND), IC7.7 (WP), J1.6 (VSS), J1.S (SH), J1.S1 (SH), J1.S2 (SH), J1.SW2, R18.1, X4.3; also elsewhere on the board
I2C1_SCL: IC7.6 (SCL); also elsewhere on the board
I2C1_SDA: IC7.5 (SDA); also elsewhere on the board
unnamed: JP5.2, R18.2, X4.1
SDMMC1_CK: J1.5 (CLK); also elsewhere on the board
SDMMC1_CMD: J1.3 (CMD), R22.2; also elsewhere on the board
SDMMC1_D0: J1.7 (DAT0), R21.2; also elsewhere on the board
SD_DETECT: J1.SW1; also elsewhere on the board
SYS_JTCK-SWCLK: R20.1; also elsewhere on the board
SYS_JTDO-SWO: IC5.5 (IO4), X4.6; also elsewhere on the board
SYS_JTMS-SWDIO: R19.1; also elsewhere on the board
~RESET: IC5.4 (IO3), X4.5; also elsewhere on the board

Notes on the sheet:
SDRAM, JTAG, I2C EEPROM, SD Card
Consumption: +3.3 V, up tp 30 mA
Licensed under the TAPR Open Hardware License (www.tapr.org/OHL)
Repository: https://github.com/eez-open
More info at http://www.envox.hr/eez
Consumption: +3.3 V, up tp 110 mA
I2C address read: 0xA1
I2C address write: 0xA0
I2C EEPROM
IMPORTANT: For PCB layout consult ST AN4661 section 8.4.2
See AN4661 section 8.4.1
Micro SD card socket
SWDIO 4
SWCLK 2
Vdd target 1
STM-32 board SWD header
Gnd 3
NRST 5
SWO 6
JTAG/SWD (optional)
SDRAM
