goran-mahovlic/modular-psu/mcu/KiCad_new/r2B1/EEZ DIB MCU r2B1.kicad_pcb

## KiCad design mcu/KiCad_new/r2B1/EEZ DIB MCU r2B1.kicad_pcb (continued)

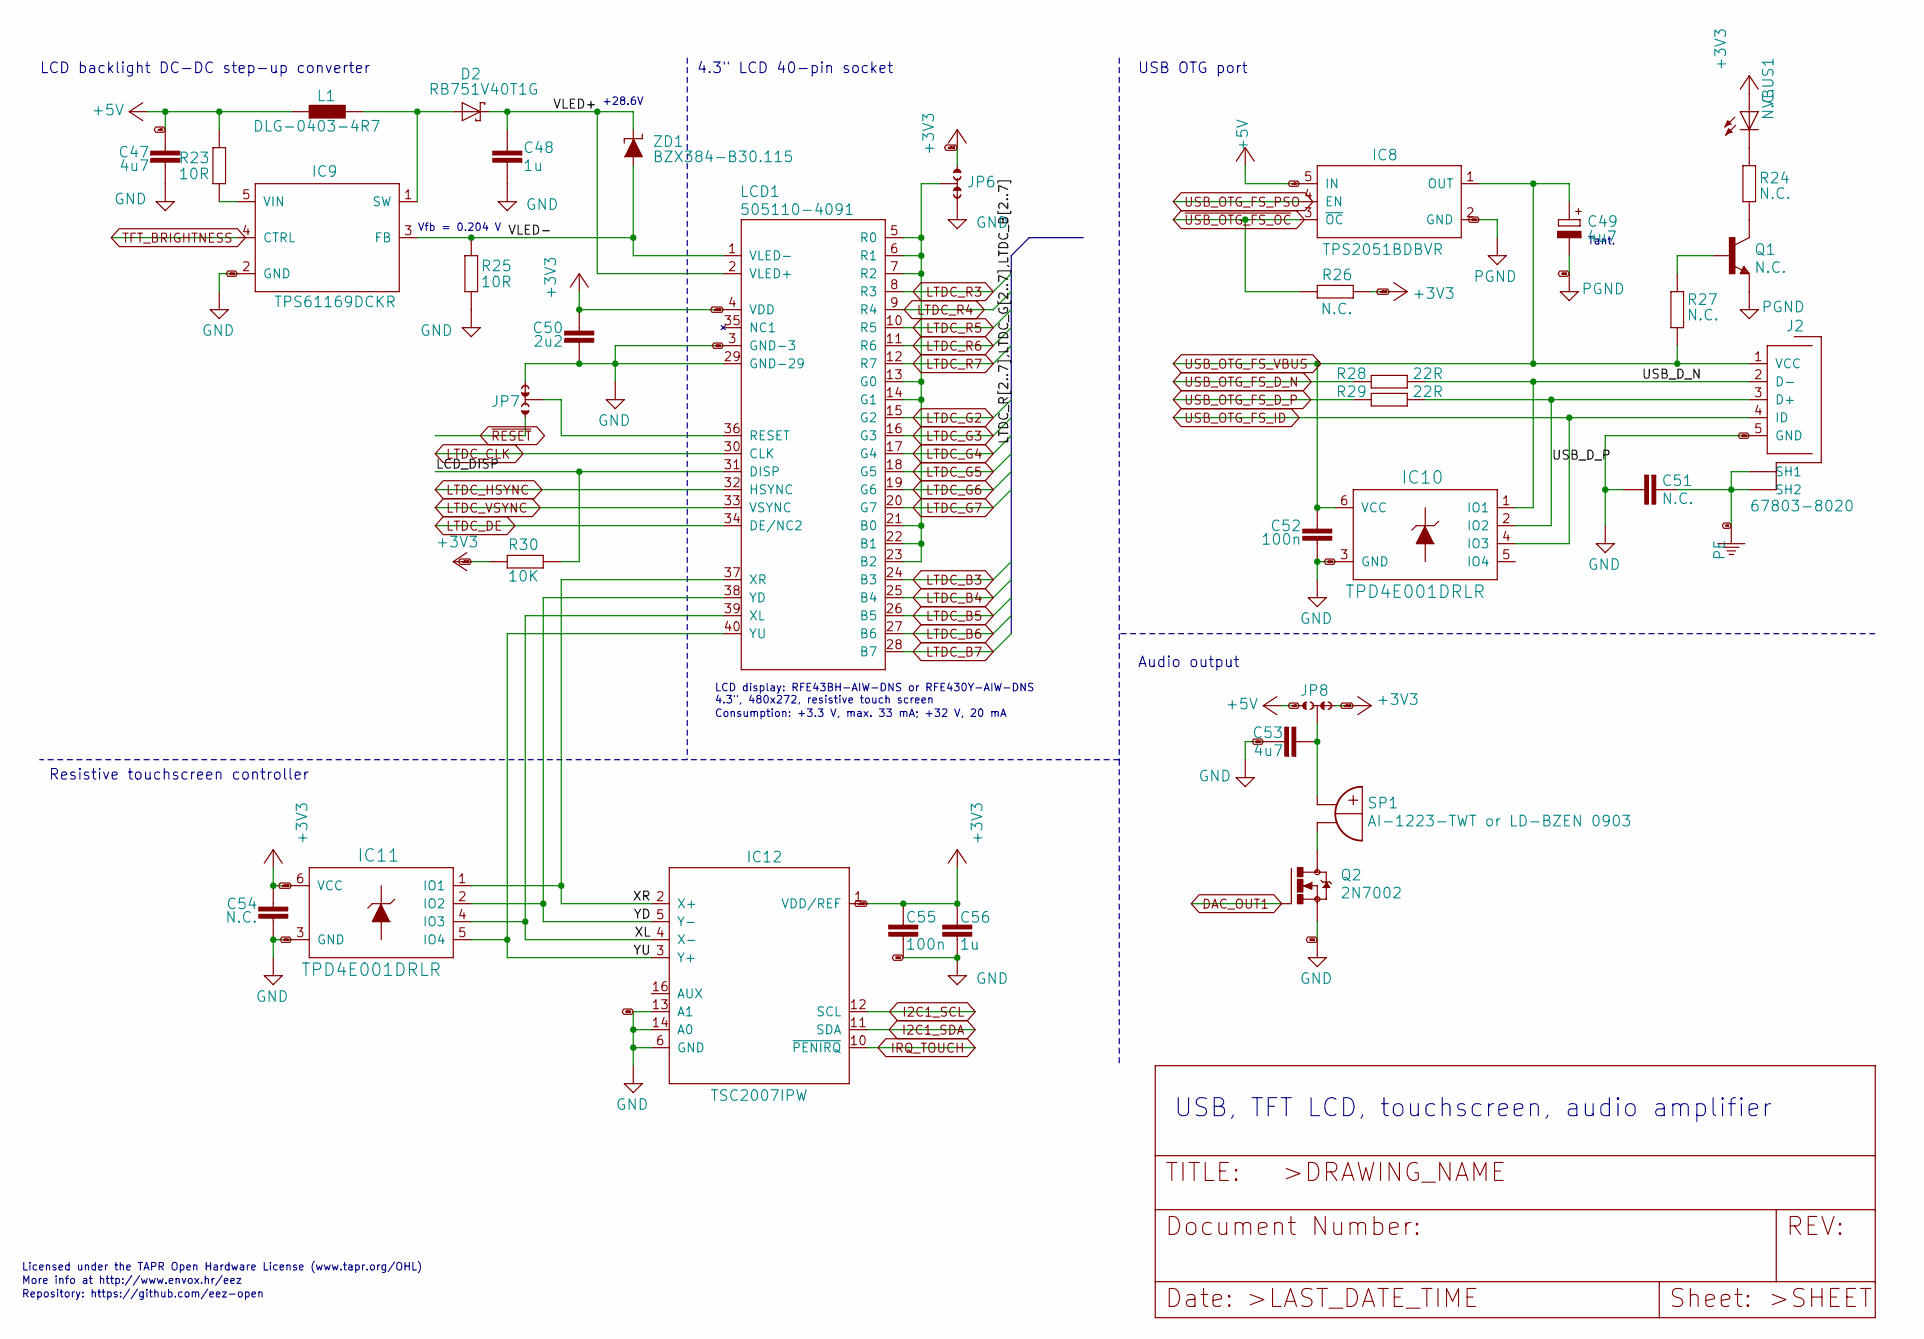
[picture p26: schematic TFT_LCD,_Audio,_USB.sch]

Parts:
C47, C53: 4u7; C1206
C48, C56: 1u; C0805
C49: 4u7; EC1206
C50: 2u2; C0805
C51: N.C.; C0805
C52, C55: 100n; C0603
C54: N.C.; C0603
D2: RB751V40T1G; SOD323-R
IC8: TPS2051BDBVR; DBV5
IC9: TPS61169DCKR; DCK5
IC10, IC11: TPD4E001DRLR; DRL6
IC12: TSC2007IPW; PW(R-PDSO-G16)
J2: 67803-8020; 678038020
JP6, JP7, JP8: JP3-CUT
L1: DLG-0403-4R7; DE0403
LCD1: 505110-4091; FPC_40
Q1: N.C.; SOT23-BEC
Q2: 2N7002; SOT103P240X110-3N
R23, R25: 10R; R0805
R24, R26, R27: N.C.; R0805
R28, R29: 22R; R0805
R30: 10K; R0805
SP1: AI-1223-TWT or LD-BZEN 0903; AI-1223-TWT_COMBO
VBUS: N.C.; LED_0805
ZD1: BZX384-B30.115; SOD323-W

Connections:
+3V3: C50.1, C54.2, C55.2, C56.2, IC11.6 (VCC), IC12.1 (VDD/REF), JP6.NO, JP8.NC, LCD1.4 (VDD), R26.2, R30.2; also elsewhere on the board
+5V: C47.1, IC8.5 (IN), JP8.NO, L1.1, R23.1; also elsewhere on the board
/TFT LCD, Audio, USB/LCD_DISP: LCD1.31 (DISP), R30.1
/TFT LCD, Audio, USB/USB_D_N: IC10.1 (IO1), J2.2 (D-), R28.1
/TFT LCD, Audio, USB/USB_D_P: IC10.2 (IO2), J2.3 (D+), R29.1
/TFT LCD, Audio, USB/VLED+: C48.1, D2.C, LCD1.2 (VLED+), ZD1.C
/TFT LCD, Audio, USB/VLED-: IC9.3 (FB), LCD1.1 (VLED-), R25.1, ZD1.A
/TFT LCD, Audio, USB/XL: IC11.4 (IO3), IC12.4 (X-), LCD1.39 (XL)
/TFT LCD, Audio, USB/XR: IC11.1 (IO1), IC12.2 (X+), LCD1.37 (XR)
/TFT LCD, Audio, USB/YD: IC11.2 (IO2), IC12.5 (Y-), LCD1.38 (YD)
/TFT LCD, Audio, USB/YU: IC11.5 (IO4), IC12.3 (Y+), LCD1.40 (YU)
DAC_OUT1: Q2.1 (G); also elsewhere on the board
GND: C47.2, C48.2, C49.-, C50.2, C51.2, C52.1, C53.1, C54.1, C55.1, C56.1, IC8.2 (GND), IC9.2 (GND), IC10.3 (GND), IC11.3 (GND), IC12.6 (GND), IC12.13 (A1), IC12.14 (A0), J2.5 (GND), JP6.NC, JP7.NC, LCD1.3 (GND-3), LCD1.29 (GND-29), Q1.E, Q2.2 (S), R25.2; also elsewhere on the board
I2C1_SCL: IC12.12 (SCL); also elsewhere on the board
I2C1_SDA: IC12.11 (SDA); also elsewhere on the board
IRQ_TOUCH: IC12.10 (~PENIRQ); also elsewhere on the board
LTDC_B3: LCD1.24 (B3); also elsewhere on the board
LTDC_B4: LCD1.25 (B4); also elsewhere on the board
LTDC_B5: LCD1.26 (B5); also elsewhere on the board
LTDC_B6: LCD1.27 (B6); also elsewhere on the board
LTDC_B7: LCD1.28 (B7); also elsewhere on the board
LTDC_CLK: LCD1.30 (CLK); also elsewhere on the board
LTDC_DE: LCD1.34 (DE/NC2); also elsewhere on the board
LTDC_G2: LCD1.15 (G2); also elsewhere on the board
LTDC_G3: LCD1.16 (G3); also elsewhere on the board
LTDC_G4: LCD1.17 (G4); also elsewhere on the board
LTDC_G5: LCD1.18 (G5); also elsewhere on the board
LTDC_G6: LCD1.19 (G6); also elsewhere on the board
LTDC_G7: LCD1.20 (G7); also elsewhere on the board
LTDC_HSYNC: LCD1.32 (HSYNC); also elsewhere on the board
LTDC_R3: LCD1.8 (R3); also elsewhere on the board
LTDC_R4: LCD1.9 (R4); also elsewhere on the board
LTDC_R5: LCD1.10 (R5); also elsewhere on the board
LTDC_R6: LCD1.11 (R6); also elsewhere on the board
LTDC_R7: LCD1.12 (R7); also elsewhere on the board
LTDC_VSYNC: LCD1.33 (VSYNC); also elsewhere on the board
unnamed: C53.2, JP8.COM, SP1.+B (+), SP1.+B.1 (+)
unnamed: D2.A, IC9.1 (SW), L1.2
unnamed: IC9.5 (VIN), R23.2
unnamed: JP6.COM, LCD1.5 (R0), LCD1.6 (R1), LCD1.7 (R2), LCD1.13 (G0), LCD1.14 (G1), LCD1.21 (B0), LCD1.22 (B1), LCD1.23 (B2)
unnamed: JP7.COM, LCD1.36 (RESET)
unnamed: Q1.B, R27.2
unnamed: Q1.C, R24.1
unnamed: Q2.3 (D), SP1.-B (-), SP1.-B.1 (-)
unnamed 195: R24.2; also elsewhere on the board
PE: C51.1, J2.SH1, J2.SH1.1 (SH1), J2.SH2, J2.SH2.2 (SH2); also elsewhere on the board
TFT_BRIGHTNESS: IC9.4 (CTRL); also elsewhere on the board
USB_OTG_FS_D_N: R28.2; also elsewhere on the board
USB_OTG_FS_D_P: R29.2; also elsewhere on the board
USB_OTG_FS_ID: IC10.4 (IO3), J2.4 (ID); also elsewhere on the board
USB_OTG_FS_PSO: IC8.4 (EN); also elsewhere on the board
USB_OTG_FS_VBUS: C49.+, C52.2, IC8.1 (OUT), IC10.6 (VCC), J2.1 (VCC), R27.1; also elsewhere on the board
~RESET: JP7.NO; also elsewhere on the board
~USB_OTG_FS_OC: IC8.3 (~OC), R26.1; also elsewhere on the board

Notes on the sheet:
USB, TFT LCD, touchscreen, audio amplifier
Licensed under the TAPR Open Hardware License (www.tapr.org/OHL)
Repository: https://github.com/eez-open
More info at http://www.envox.hr/eez
4.3" LCD 40-pin socket
LCD backlight DC-DC step-up converter
Consumption: +3.3 V, max. 33 mA; +32 V, 20 mA
Vfb = 0.204 V
LCD display: RFE43BH-AIW-DNS or RFE430Y-AIW-DNS 4.3", 480x272, resistive touch screen
USB OTG port
Resistive touchscreen controller
Audio output
Tant.
+28.6V

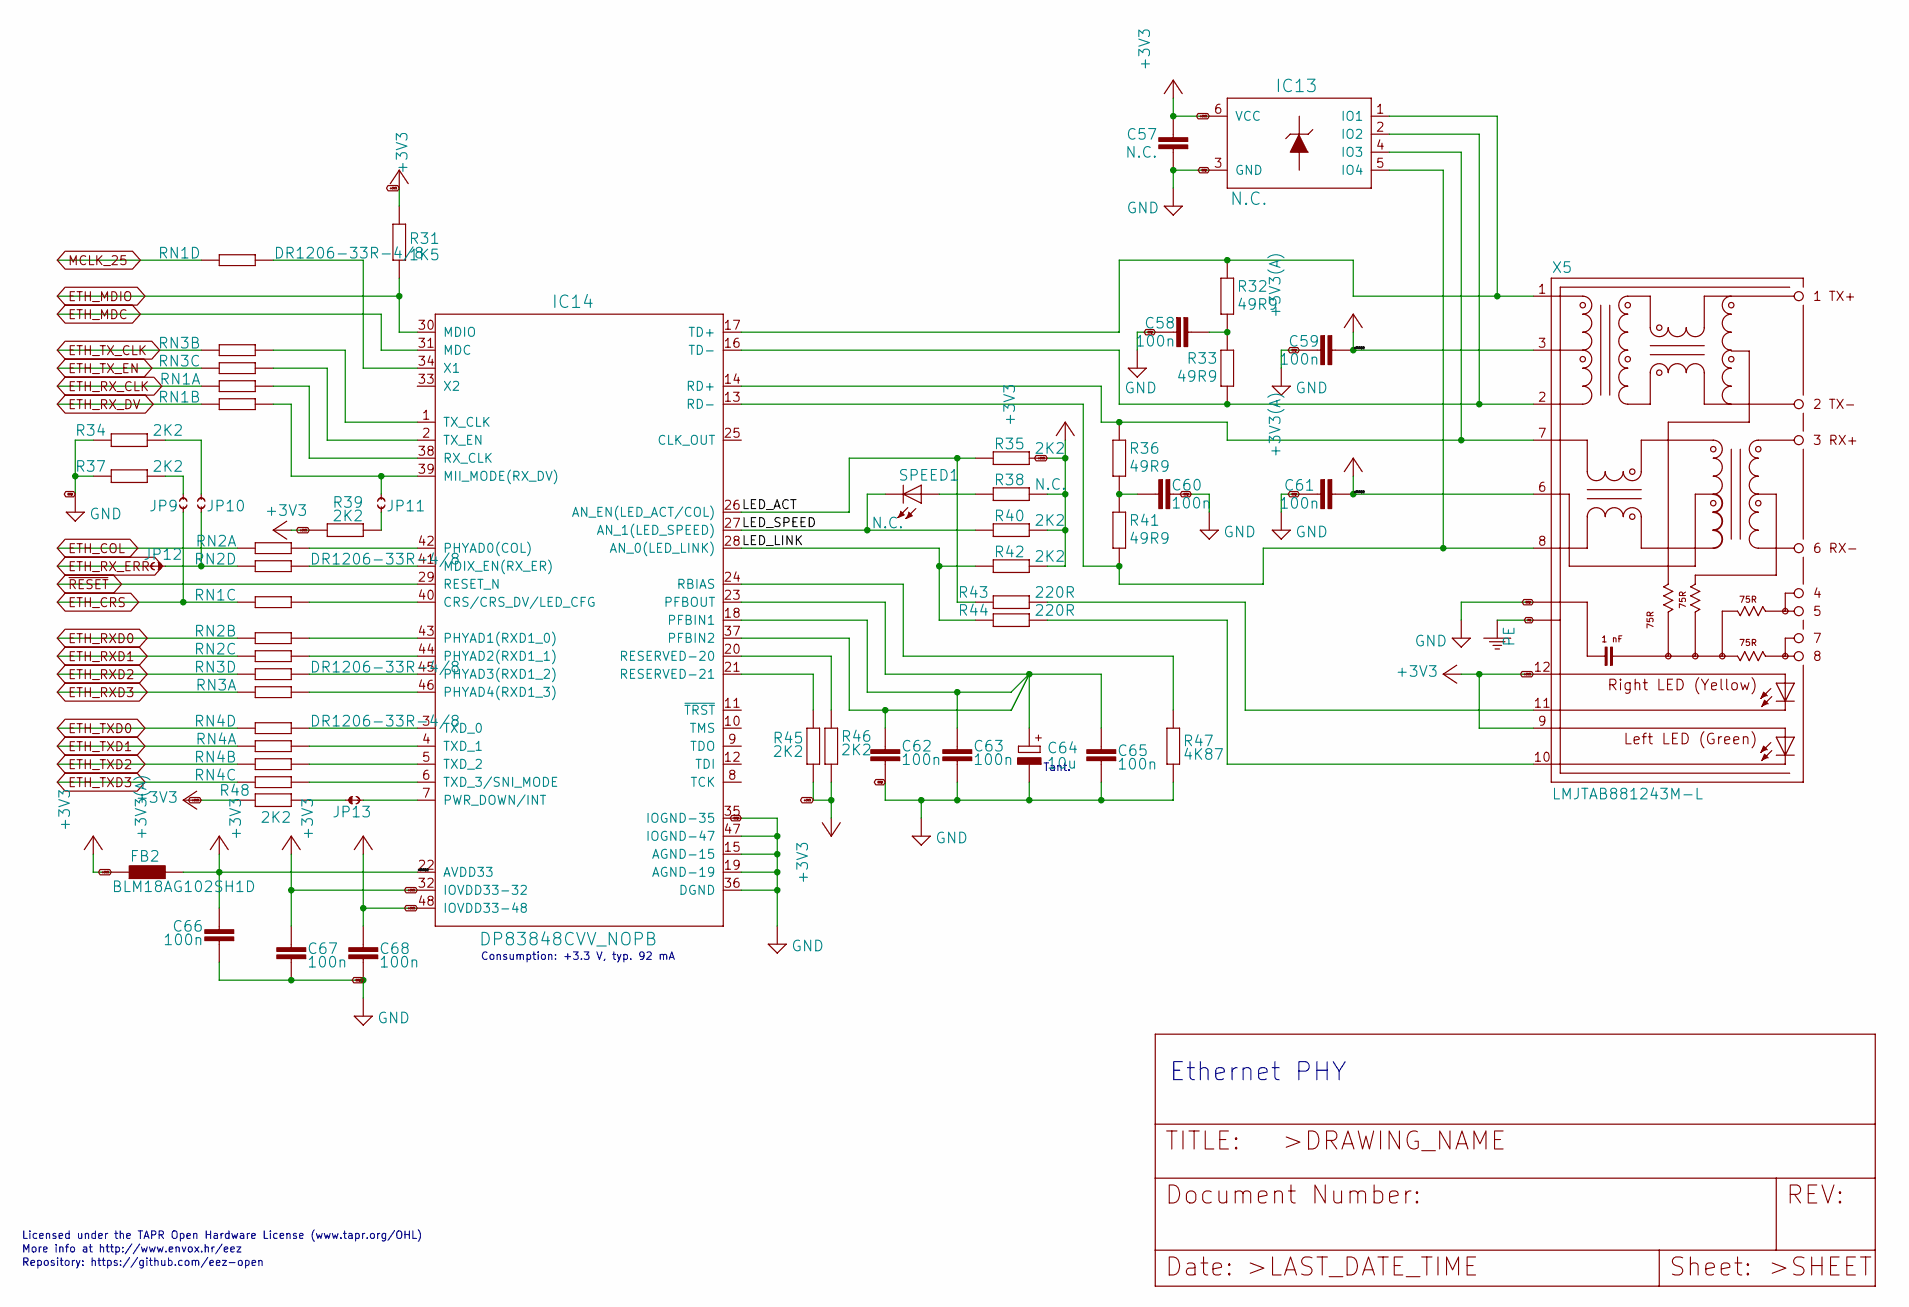
[picture p27: schematic Ethernet_PHY.sch]

Parts:
C57: N.C.; C0603
C58, C59, C60, C61, C62, C63, C65, C66, C67, C68: 100n; C0603
C64: 10u; EC1206
FB2: BLM18AG102SH1D; BEAD0603
IC13: N.C.; DRL6
IC14: DP83848CVV_NOPB; PT48
JP9, JP10, JP11: JP2-CUT
JP12, JP13: JP2-NOCUT
R31: 1K5; R0805
R32, R33, R36, R41: 49R9; R0805
R34, R35, R37, R39, R40, R42, R45, R46, R48: 2K2; R0805
R38: N.C.; R0805
R43, R44: 220R; R0805
R47: 4K87; R0805
RN1, RN2, RN3, RN4: DR1206-33R-4/8; CAY16
SPEED: N.C.; LED_0805
X5: LMJTAB881243M-L; RJ45-TRAFO-LED

Connections:
+3V3: C57.1, C67.1, C68.1, FB2.P$1 (1), IC13.6 (VCC), IC14.32 (IOVDD33-32), IC14.48 (IOVDD33-48), R31.2, R35.1, R38.1, R39.1, R40.1, R42.1, R45.1, R46.1, R48.1, X5.9 (GREEN-A), X5.12 (YELLOW_A); also elsewhere on the board
+3V3(A): C59.2, C61.2, C66.1, FB2.P$2 (2), IC14.22 (AVDD33), X5.3 (CT), X5.6 (CR)
/Ethernet PHY/LED_ACT: IC14.26 (AN_EN(LED_ACT/COL)), R35.2, R43.2
/Ethernet PHY/LED_LINK: IC14.28 (AN_0(LED_LINK)), R42.2, R44.2
/Ethernet PHY/LED_SPEED: IC14.27 (AN_1(LED_SPEED)), R40.2; also elsewhere on the board
ETH_COL: RN2.2 (1); also elsewhere on the board
ETH_CRS: JP9.1, RN1.4 (1); also elsewhere on the board
ETH_MDC: IC14.31 (MDC); also elsewhere on the board
ETH_MDIO: IC14.30 (MDIO), R31.1; also elsewhere on the board
ETH_RXD0: RN2.3 (1); also elsewhere on the board
ETH_RXD1: RN2.4 (1); also elsewhere on the board
ETH_RXD2: RN3.1; also elsewhere on the board
ETH_RXD3: RN3.2 (1); also elsewhere on the board
ETH_RX_CLK: RN1.2 (1); also elsewhere on the board
ETH_RX_DV: RN1.3 (1); also elsewhere on the board
ETH_RX_ERR: JP12.2; also elsewhere on the board
ETH_TXD0: RN4.1; also elsewhere on the board
ETH_TXD1: RN4.2 (1); also elsewhere on the board
ETH_TXD2: RN4.3 (1); also elsewhere on the board
ETH_TXD3: RN4.4 (1); also elsewhere on the board
ETH_TX_CLK: RN3.3 (1); also elsewhere on the board
ETH_TX_EN: RN3.4 (1); also elsewhere on the board
GND: C57.2, C58.2, C59.1, C60.2, C61.1, C62.2, C63.2, C64.-, C65.2, C66.2, C67.2, C68.2, IC13.3 (GND), IC14.15 (AGND-15), IC14.19 (AGND-19), IC14.35 (IOGND-35), IC14.36 (DGND), IC14.47 (IOGND-47), R34.1, R37.1, R47.1, X5.4 (GND), X5.5 (GND); also elsewhere on the board
MCLK_25: RN1.1; also elsewhere on the board
unnamed: C58.1, R32.1, R33.2
unnamed: C60.1, R36.1, R41.2
unnamed: C62.1, C63.1, C64.+, C65.1, IC14.18 (PFBIN1), IC14.23 (PFBOUT), IC14.37 (PFBIN2)
unnamed: IC13.1 (IO1), IC14.17 (TD+), R32.2, X5.1 (TD+)
unnamed: IC13.2 (IO2), IC14.16 (TD-), R33.1, X5.2 (TD-)
unnamed: IC13.4 (IO3), IC14.14 (RD+), R36.2, X5.7 (RD+)
unnamed: IC13.5 (IO4), IC14.13 (RD-), R41.1, X5.8 (RD-)
unnamed: IC14.1 (TX_CLK), RN3.6 (2)
unnamed: IC14.2 (TX_EN), RN3.5 (2)
unnamed: IC14.3 (TXD_0), RN4.8 (2)
unnamed: IC14.4 (TXD_1), RN4.7 (2)
unnamed: IC14.5 (TXD_2), RN4.6 (2)
unnamed: IC14.6 (TXD_3/SNI_MODE), RN4.5 (2)
unnamed: IC14.7 (PWR_DOWN/INT), JP13.2
unnamed: IC14.20 (RESERVED-20), R46.2
unnamed: IC14.21 (RESERVED-21), R45.2
unnamed: IC14.24 (RBIAS), R47.2
unnamed: IC14.34 (X1), RN1.8 (2)
unnamed: IC14.38 (RX_CLK), RN1.7 (2)
unnamed: IC14.39 (MII_MODE(RX_DV)), JP11.2, RN1.6 (2)
unnamed: IC14.40 (CRS/CRS_DV/LED_CFG), RN1.5 (2)
unnamed: IC14.41 (MDIX_EN(RX_ER)), RN2.8 (2)
unnamed: IC14.42 (PHYAD0(COL)), RN2.7 (2)
unnamed: IC14.43 (PHYAD1(RXD1_0)), RN2.6 (2)
unnamed: IC14.44 (PHYAD2(RXD1_1)), RN2.5 (2)
unnamed: IC14.45 (PHYAD3(RXD1_2)), RN3.8 (2)
unnamed: IC14.46 (PHYAD4(RXD1_3)), RN3.7 (2)
unnamed: JP9.2, R37.2
unnamed: JP10.1, JP12.1, RN2.1
unnamed: JP10.2, R34.2
unnamed: JP11.1, R39.2
unnamed: JP13.1, R48.2
unnamed 196: R38.2; also elsewhere on the board
unnamed: R43.1, X5.11 (YELLOW-C)
unnamed: R44.1, X5.10 (GREEN-C)
PE: X5.SH, X5.SH2 (SH); also elsewhere on the board
~RESET: IC14.29 (RESET_N); also elsewhere on the board

Notes on the sheet:
Ethernet PHY
Tant.
Consumption: +3.3 V, typ. 92 mA
Licensed under the TAPR Open Hardware License (www.tapr.org/OHL)
Repository: https://github.com/eez-open
More info at http://www.envox.hr/eez

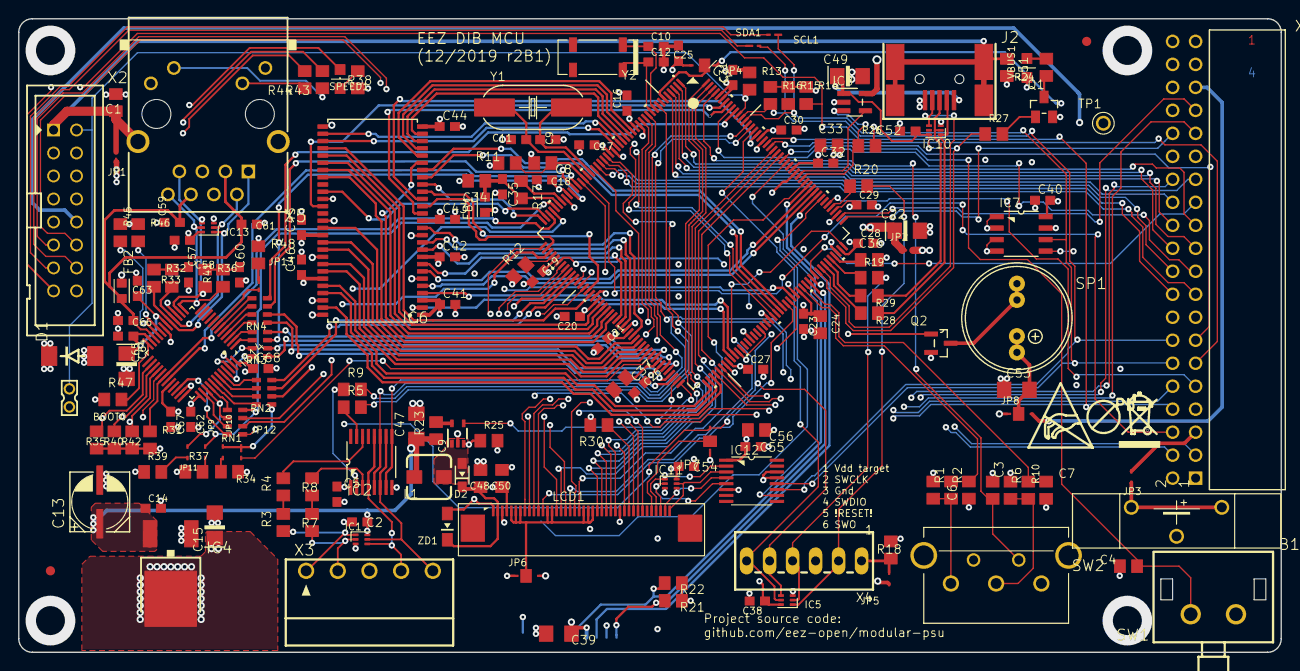
[picture p28: board EEZ DIB MCU r2B1.kicad_pcb from above]

Board: 4 copper layers, 139.5 x 70.0 mm, 181 parts (0 on the bottom side), 219 nets.

Other parts of the board:
EEZ_SIGNATURE: SIGNATURESMALL; SIGNATURE_5MM
SCL1: JP2-NOCUT
SDA1: JP2-NOCUT
SPEED1: N.C.; LED_0805
U$1: RECYCLE_BIN1_8
U$5: PB_SMALL
U$6: ESD_SYMBOL
VBUS1: N.C.; LED_0805

Their connections:
+3V3: VBUS1.A; also elsewhere on the board
/Ethernet PHY/LED_SPEED: SPEED1.C; also elsewhere on the board
I2C1_SCL: SCL1.1; also elsewhere on the board
I2C1_SDA: SDA1.2; also elsewhere on the board
unnamed 195: VBUS1.C; also elsewhere on the board
unnamed 196: SPEED1.A; also elsewhere on the board
unnamed 199: SCL1.2; also elsewhere on the board
unnamed 200: SDA1.1; also elsewhere on the board
