goran-mahovlic/modular-psu/(commit log)

2020-01-06 Converting all designs to KiCad
    [Bias_PS,_DIB_interface.sch, Bias_power,_DIB_interface.sch, CC%2fCV,_OVP.sch, Channel_#1.sch, Channel_#2.sch, Digital_control,_Vref.sch, Digital_control.sch, EEZ DIB BP3C r3B2.kicad_pcb]
2020-01-07 Adding initial 3D images for BP3C
    [EEZ DIB BP3C r3B2.kicad_pcb, RM84-2P.STEP, RM84-2Z.STEP]
2020-01-07 Fixing Blender export - hand needs to be removed from PCB for export
    [EEZ DIB BP3C r3B2.kicad_pcb]
2020-01-07 Adding freecad connected - adding pins to modules
    [EEZ DIB DCM220 r2B7.kicad_pcb, EEZ DIB DCM220 r2B7.step, EEZ DIB DCP405 r2B8.kicad_pcb, connected.FCStd]
